lilicqyu-ship-it/smartcar/tc275_car/doc/00-index.md

# 00 · 文档地图（doc/ 入口）

| 项 | 内容 |
|---|---|
| 文档编号 | 00 |
| 域 | 入口（跨板） |
| 版本 | V1.23（2026-10-05：**融合保护主开关批次登记**——新增编译期宏 `FUSION_CFG_PROTECTION`（`app/fusion.h`，默认 1）：置 0 构建台架/诊断旁路固件，场景分类/cap/健康位照常发布但限速、停车锁存（近障/盲区/编码器/超速）、倾斜停车与倒车限速全不执行、原始摇杆直通（动机 = 48 cm 桅杆水平安装下地面回波 ~0.95–1.4 m 把 cap 压到 fs 以下、重新武装 v1.0.9 只豁免 `cap==fs` 的超速假锁存并打破 OPEN_CLEAR，地面无法驾驶；2026-10-04 记录的 201–488 mm 近回波在该高度不可能是地面，待 `[TOF_ZONE]` 定位）；`[FUSION]` 日志新增 `protection` 字段；**旁路构建无任何前向保护仅限台架，测完恢复 1 重烧**，长期修复候选（地面平面过滤/上仰 ≥10–16°/fs 实测标定）登记在 37 号 V1.4），33 **V1.9**（§6 新增主开关条目）、37 **V1.4**、38 **V1.3**；APPFW **1.3.2**；`test_fusion_bypass` 新增 6 组旁路回归并入 CI（`tc275-car.yml`），既有 `test_fusion` 全过；TASKING 构建过（ROM 199042 B），旁路/实车驾驶未上台架。V1.22（2026-10-04：**BUG-ENC-1 编码器健康 P0 修复批次登记**——新增 **51 号缺陷修复记录**（BUG-ENC-1：4 路霍尔健康合并成单一 `alive`、融合把"1 ms 发布序号变化"当"编码器有效"，单侧失效被对侧运动掩蔽，`FUSION_ENCODER_LOST` 对传感器失效是死代码；修复 = `XcoreEncoder.edgeAgeMs[2]` 按侧边沿龄 + "被驱侧 500 ms 宽限内必须出边沿"消费语义，速度锚/一致性只用边沿新鲜的侧，measOk 按侧回退开环，[WHEELS] 补 age 字段），21 **V1.16**（§5.1/§5.2）、31 **V2.9**、33 **V1.8**、37 **V1.3**（flags bit4 语义更新）、38 **V1.2**、51 新登记；APPFW **1.3.1**（与日志泵去阻塞同批一个发布，33 V1.7/38 V1.1 为该批条目）；test_fusion 新增按侧失效回归、test_xcore +2 断言（1144）；TASKING 构建过（ROM 198243），按侧拔线注入待台架）。V1.21（2026-10-04：**TB6612 STBY 受控化同批索引同步**——23 **V1.23**（§3 脚位改 P22.2/X1-16 → J4-2、新增 §3.2 选脚判据与三条电气事实）、21 **V1.15**（§4 术语/§5.2/§7.1/§7.2/§17 五处回写，"急停是否拉低 STBY"登记为未裁决语义）、33 **V1.6**（§9 硬件速查补 STBY 行）、01 **V2.2**（第 4 步改接线 + 排障表加"四轮全不动＝STBY 未使能"）；**改线与刷固件必须同批**，且本轮未过 TASKING 构建）。V1.20（2026-10-04：**新增 38 号开发者日志字典**，App **v1.2.1** 把周期日志改为 `[MODULE] 字段=值+单位` 并按状态分级节流（融合 5 s、IMU/ToF/车速 10 s、链路 30 s，伺服抖动不重置节流），故障与恢复仍即时成事件，新增 `XCORE_LOG_FIELDS`/`XCORE_logDue` 与 `log_dropped_total`；35/36/37/21 各加指向注；CI 步骤新增 `test_log_policy.py`，`test_xcore` 1121→1144 断言）。V1.19（2026-10-04：新增 37 号，App v1.2.0 多传感器融合与遥控保护）。V1.18（2026-10-04：36 号 V1.5，ToF 1 MHz 配置试验 865 帧、错误 0）。V1.17（2026-10-04：36 号 V1.4，ToF COM16 连续 744 帧、错误 0）。V1.16（2026-10-04：23 号 V1.22、36 号 V1.3，ToF 换到 X304-7/-8 复测）。V1.15（2026-10-04：36 号 V1.1 登记复测失败与清标志前诊断快照）。V1.14（2026-10-04：登记 36 号 ToF 驱动故障修复与验证记录）。V1.13（2026-10-03，**§2 版本列同步 23→V1.21**——23 号新增 **§11「TC275 ↔ VL53L5CX 8×8 多区 ToF」接线定稿**：挂 **TC275 唯一 I2C0**（SCL=P13.1 / SDA=P13.2，mikroBUS 12/11 孔）、INT=P10.7（孔 15）、LPn 方案 A（47 k 上拉、不占 MCU 脚）、AVDD+IOVDD 同取 VEXT 3.3 V、典型 95 mA 并入 §5.2 电流预算；**两条新登记的事实**：① **ERU 输入通道互斥**——`IfxScu_REQ4_P10_7_IN` 的 `channelId=0`，与 IMU 在用的 `REQ0_P15_4`（ch0 选 a）是同一条通道 ⇒ ToF 的 INT **做不了边沿中断，改 CPU0 电平轮询**（这正是 §6 G2 所说"引脚冲突是最贵的错误"的又一例，已把备选脚 P10.8/P20.9/P20.0 登记在 23 §11.2）；② **iLLD 把 I2C SCL/SDA 配成开漏**（`IfxI2c.c:220-228`）⇒ SDA/SCL 2.2 k + INT/LPn/I2C_RST 47 k 是手册硬要求，`23 §9.3` 的"杜邦线无外部元件"口径在这条总线**不成立**，已在 23 §1 加例外注。另 23 V1.21 更正 **§10.1 IMU INT2 孔位 X1-30 → X1-29**（X1-30 实为 PORST_N 复位网）。**ToF 本批只锁脚位：不动 `.cproject`、不引 ST API、不写 `bsp/tof.c`、不改 C6 侧、11 号需求表尚无 ToF 条目**；§2 表内 23 行同步，本行自指版本一并纠正为 V1.13）。V1.12（2026-10-03，**新增 35-imu-driver.md 并登记进 §2**——TC275 侧 LSM6DSV16BX 六轴 IMU 驱动落地：`bsp/imu.c/.h` CPU1 属主（QSPI1 主机 SPI 模式 3/1 MHz 档位、WHO_AM_I 0x70、±4 g/±500 dps/240 Hz、每 5 ms 14 B 突发、INT1 P15.4 走 SCU ERU 仅计数、失联 1 Hz 重探免重启自愈）、xcore 新块 `XcoreImu`、中断优先级占用 11/14/15+24（21 §18 C2 同步）、主机单测新增 `test_imu` 55 断言（CI 同步）/`test_xcore` 1095→1109；**未过 TASKING 编译、硬件未接线（23 §10 待实物接线），驱动主体无单测需台架首验**；接线真源 23 §10、驱动设计真源 35。§2 版本列同步 21→V1.13 / 23→V1.19 / 31→V2.7 / 32→V1.9 / 33→V1.5）。V1.11（2026-09-27，**34 号 M2a + M3' + §9 DPT 落地**，本轮口径变更：**标定结果回传 + DFlash 持久化 + 台架命令族**——新增 `mw/calib/`（`calib_record.c/.h` 纯 C99 记录 blob 与 EVT 编解码、有主机单测；`calib_store.c/.h` CPU0 专属 **DFlash0 扇区 15** 单槽持久化，magic/CRC/范围三关不过则回默认值），§8.2 满量程与轮径转**运行时变量（换算公式未动）**，xcore 新增四块 `CalibResult`(CPU1→CPU0)/`Jog`(CPU0→CPU1)/`RecordLive`(带 `version`)/`EVT 出站队列`(CPU0→CPU2)，命令 `0x71 MOTOR_JOG`（duty 钳 ±500、300 ms 未续约自动停车、FAULT/急停拒收）与 `0x72/0x73/0x74` REC 读写清，回传 EVT `0x22`(23 B，`saved` 在 [22])/`0x23`(15 B)，**写 flash 延后到车辆静止 500 ms**、序列=喂狗→关中断→擦→逐页写→回读；真源 `34 §8/§9/§11`，协议侧 `22 §5.1/§5.2`、`21 §5.1/§5.2/§6.2`。**SF 主机单测 2873→2948**（① 的编译单元加 `mw/calib/calib_record.c`，`.github/workflows/ci.yml` 同改）。**M2a/M3' 只过主机单测：未做 TASKING 构建、xcore 新块/jog/DFlash 均无台架证据**，未决项见 `34 §12 Q1~Q3`。§2 版本列同步 21→V1.10 / 22→V1.7 / 23→V1.15 / 31→V2.5 / 32→V1.8 / 33→V1.1 / 34→V1.2）。V1.10（2026-09-27，34 号升 V1.1——按用户需求追加：标定数据（电机位置/运动方向/算法参数）**存 TC275 DFlash**（CalibRecord 单槽+CRC，参数运行时化）、DPT 命令族 **0x71 MOTOR_JOG / 0x72~0x74 REC 读写清**、0x22 回传帧追加 saved 位；跨库配套 esp32c6_car 17 号 V1.1 §8；文档追加，无行为变更）。V1.9（2026-09-27，新增 **34-calib-dpt.md** 并登记进 §2——TC275 编码器判向标定功能现状与需求：0x70 现状盘点、M2a 结果回传帧 `SF_CID_DPT_RESULT(0x22)` 契约（跨库配套 esp32c6_car `doc/17-calib-ui.md`）、M3 符号固化流程、弱 plant 台架规程；文档新增，无行为变更）。V1.8（2026-09-27，§2 版本列同步至 SDD V1.9 / 23 V1.14 / 31 V2.4 / 32 V1.7，本轮口径变更：**电池电压采集落地**——D24A J6-1 分压（VIN/11）接 kit **X2-23/AN4**（VADC G0 CH4），`bsp/adc` 100 Hz + EMA，遥测 `batteryMv/batteryPct` 转 ✅（pct 按 3S 估算待节数确认），真源 `23 §5.5` 与 `21 §6.3`；接线真源 23 V1.14）。V1.7（2026-09-27，**23 号新增 §3.1「D24A 驱动板原理图详解」**——把驱动板原理图 REV1.0 板内电路（5V TB6288GSP / 3V3 RT9013-33 / 双 TB6612FNG / 过温过流使能 / 连接器清单）登记为真源，§2 版本列同步 23→V1.13；33 号 §9 硬件速查补指向该节）。V1.6（2026-09-27，新增 **33-ai-codebase-guide.md**——供 AI 编码助手作业前必读的代码库导航、跨核数据流、高频改动路径正确改法与 9 条红线速查，登记进 §2 真源表；现状口径已含 servo 闭环 / CPU 看门狗 / 0x70 判向）。V1.5（2026-09-27，§2 版本列同步至 SDD V1.8 / 31 V2.3 / 32 V1.6 / 50 V1.2，本轮口径变更：**跑飞自恢复链落地**——`bsp/wdg.h` 新增，**CPU0/CPU1 硬件看门狗启用并周期喂狗**（CPU1 1 kHz 环 / CPU0 robot 任务 10 ms，窗口 ≈0.3~0.5 s），SM 与 CPU2 看门狗**有意保持关闭并各附理由**，FreeRTOS 栈溢出钩子改为"上报 + 断喂复位"，真源 `21 §7.2` 与 `21 §18 C8`（含 **ENDINIT 饱和计数**铁律）；50 号评估 §6 建议 1/2/3 已处置并回执。V1.4（2026-09-27，§2 版本列同步至 SDD V1.7 / 23 V1.12 / 31 V2.2 / 32 V1.5 / 50 V1.1，本轮口径变更：**CPU1 速度闭环落地 + 判向标定转正**——`rt/servo` PI×2（编码器无效回退开环）、`g_encInvert` 运行时可写 + `0x70` 台架自动判向、遥测 `vTargetL/R` 转 ✅，真源 `21 §5.1/§5.2` V1.7；50 号评估的建议 1/2 已处置并回执于 `50 §5`）。V1.3（2026-09-27，新增 **50-tech-assessment.md**——对 `v0.2.1` 现状代码的第三方技术评估快照，登记进 §2 真源表与 §1 编号规则 5x 域）。V1.2（2026-09-27，§2 版本列同步至 SDD V1.6 / 22 V1.6 / 23 V1.11 / 31 V2.1 / 32 V1.4 / 41 V1.3，本轮口径变更：**链路泵简化**——寄存器快照改单读+消费端钳位、失联判定只由 `SF_ALIVE` 500 ms 承担、SEQ 越窗 8 帧重锁，真源 `22 §4.2/§5.4` V1.6；另登记 GitHub Actions CI 已建——主机单测 push/PR 自动跑，真源 `.github/workflows/ci.yml`）。V1.1（2026-09-26，随 doc 目录重构建立；V1.1 = §2 版本列全量同步至 SDD V1.5 / 22 V1.5 / 23 V1.10 / 31 V2.1 / 32 V1.3 / 41 V1.2 / 11 V1.3，并登记两条口径变更：**板间连线为杜邦线直连无外部元件**（真源 `23 §9.3`）、**UART 作为板间链路已弃用**（真源 `21 §5.6` 末条与 `21 §18 C15`，构建侧 `USE_SPI_LINK` 进 Debug/Release 两个 TASKING 配置）） |
| 读者 | 所有第一次进入本仓库的人；以及需要确认"某件事的权威出处在哪篇"的人 |

本仓库（`tc275_car` = TC275 固件工程）与同级仓库（`esp32c6_car` = ESP32-C6 固件工程）共同构成 SmartDrive 的双固件产品。文档按**域**分目录、按**编号**排序。

---

## 1. 编号规则

```
NN-名称.md
│└─ 名称：kebab-case，英文
└─ NN：两位数字。十位 = 域，个位 = 域内阅读顺序
   0x  入口 / 教程        1x  产品与需求      2x  设计与硬件（跨板）
   3x  TC275 侧           4x  ESP32-C6 侧     5x  生产/质量、运维（50 评估、51 验证日志…）
```

目录与编号一一对应：`doc/10-product/`、`doc/20-design/`、`doc/30-tc275/`、`doc/40-esp32c6/`；`0x` 两篇放在 `doc/` 根。

**新增文档时**：先确定归属域，取该域下一个空号；不要插号（如 `21a`），也不要为了"看起来成对"复制内容——跨板内容进 `20-design/`，单板内容进 `3x`/`4x`。

## 2. 全部文档与真源职责

| 编号 | 文档 | 域 | 版本/状态 | 它对什么负责（真源） |
|---|---|---|---|---|
| 00 | [00-index.md](00-index.md) | 入口 | V1.21 | 文档地图、编号规则、阅读路线、缺口清单 |
| 01 | [01-getting-started.md](01-getting-started.md) | 入口 | V2.2 | **demo（esp-at + UART）能跑通的 bring-up 全流程**：编译烧录 → 刷 esp-at → 接线 → 手机遥控 → 排障。**做本教程需临时删掉 `USE_SPI_LINK`**（UART 板间链路已弃用）。**V2.2 = 第 4 步 STBY 改 GPIO 受控（拔 J4-1↔J4-2 跳线帽 + X1-16→J4-2），并加"四轮全不动 = STBY 未使能"排障行** |
| 11 | [10-product/11-requirements.md](10-product/11-requirements.md) | 产品 | V1.3 | 产品定义、功能编号 F01~F14、验收标准、版本路线（V1.3：板间链路唯一为 SPI） |
| 12 | [10-product/12-demo-evaluation.md](10-product/12-demo-evaluation.md) | 产品 | 冻结快照 | demo 的问题清单 P0~P3（**历史快照**，结论已被 21 号吸收为架构约束，不再更新） |
| 21 | [20-design/21-software-design.md](20-design/21-software-design.md) | 设计 | **V1.16 ★基准** | 量产软件设计基准：三核分区、模块详设、两段协议、安全/信息安全、OTA、产测、质量工程、里程碑、风险、**§18 工程级实现约束 C1~C15**（C15 = UART 板间链路弃用；V1.6 = 链路泵简化；V1.7 = 速度闭环 `rt/servo` 落地 + `g_encInvert` 运行时判向 + 0x70 自动判向，**首次闭环前必须先判向**；V1.8 = **CPU0/CPU1 硬件看门狗启用 + 栈溢出钩子上报并断喂复位**，喂狗铁律见 §18 C8；V1.10 = 标定/DPT 落地：§4.1 DF0 槽位占用（扇区 15）+ §5.1 参数运行时化与持久化 + §5.2 jog 与结果回传 + §6.2 `0x70~0x7F` 同字节双语义 hazard + §17 新增 `mw/calib/`；V1.11 = §5.2 闭环使能门固件化（`g_closedLoopOk`，src=0 强制开环等价，34 §13）；V1.12 = §5.1 编码器刻度 13 PPR；**V1.13 = §7.2/§18 C8 看门狗假死根治**——TC27x 的 CPU WDT 到期只发 NMI 不自行复位、iLLD 默认空钩子 → V1.8 的"断喂→复位"链从未闭合（整车假死根因），`Ifx_Cfg.h` NMI 钩子接 `IfxCpu_triggerSwReset()` 兜底，窗口更正 `REL=0xF800`≈**1.4 s**（旧稿 0.3~0.5 s 算术矛盾），随 tc275_car v1.1.2；**V1.15 = TB6612 STBY 改 GPIO 受控（P22.2/X1-16 → D24A J4-2）**：§4 术语"安全态"/§5.2"STBY 硬线"/§7.1 复位口径/§7.2 台架项/§17 映射五处同批回写，凭 TB6612 **控制输入内部 200 kΩ 下拉**给出"复位期间驱动未解锁"的纸面答案（**实物须改线 + 台架未做前不得宣称已闭环**）；**未裁决**：急停/堵转/欠压是否叠加"STBY 拉低"——与现短接刹车互斥（拉低=高阻滑行、刹车距离变长），详见 §5.2 与 23 §3.2） |
| 22 | [20-design/22-link-spi-design.md](20-design/22-link-spi-design.md) | 设计 | V1.8 | 板间 SPI 链路的详细设计：事实基线 **E1~E14**、事务模型（V1.6 = 单读快照 + 消费端钳位，§4.2）、SF 帧（含 FLAGS/CID 载荷形状两张契约表、SEQ 越窗重锁 §5.3）、两固件改动清单、门禁 G1~G6；V1.7 = EVT 登记 0x22(23 B)/0x23(15 B)（CPU0 组帧、CPU2 发送、队头重试）与 DPT op 扩到 0x70~0x74；**V1.8 = 命令队列抗突发**（§5.4 队列满载条目重写：深度 8→16、`SET_SPEED` 新者胜入队 `XCORE_cmdPushLatest`、`cmdq full` 日志限速 1 行/s、`XCORE_logService` 每调用排空一行、LINKDBG 第 19 字段 `cmdqRej`；台架"大量 LINK cmdq full 后失控"的根因收敛，xcore 队列语义新增主机单测 `test_xcore` 1095 断言） |
| 23 | [20-design/23-wiring.md](20-design/23-wiring.md) | 硬件 | **V1.23** | **引脚与接线唯一真源**（TC275 ↔ C6 ↔ D24A ↔ 电机/编码器 ↔ IMU ↔ **ToF** ↔ 电源）+ 接线状态一览 + **§3.1 D24A 驱动板原理图详解（REV1.0 板内电路）** + **§3.2 STBY 受控化**（2026-10-04：STBY 由"跳 J4-1 板载 3V3 常使能"改为 **TC275 GPIO 受控 P22.2 / X1-16 → J4-2**，一根线管四路；含选脚五条排除判据、**片内 200 kΩ 下拉 ⇒ 浮空=关断**、`VIH(STB)=3.5 V` vs 3.3 V 驱动的裕量账、与 21"安全态"的语义冲突登记；**改线与刷固件同批**） + **§9.3 板间连线电气形态（杜邦线直连、无外部元件）**；§2 UART 已降为调试控制台；§8.4 步骤 2 首选 `0x70` 自动判向，V1.15 追加"持久化与台架命令"子块（0x70 结果自动写 DF0 扇区 15、EVT 0x22/0x23、0x71 jog 与 0x72~0x74 语义），V1.16 = "开环等价"由固件强制执行（34 §13 闭环使能门），V1.17 = §8 编码器刻度修正（13 PPR → 1061.27 计数/轮转），V1.18 = **§10 新增 LSM6DSV16BX 六轴 IMU 接线定稿**（QSPI1 P11.6/11.9/11.3 + SLSO3 P11.10、INT1 P15.4/INT2 P15.5、VEXT 供电），V1.19 = §10 IMU 固件驱动落地（`bsp/imu.c/.h` CPU1 属主、xcore `XcoreImu`、失联 1 Hz 重探；设计真源 35），V1.20 = §10.2 首验 ① 台架通过（`WHOAMI=0x71`、静置六轴模 995 mg）+ 三项未结，**V1.21 = 新增 §11「TC275 ↔ VL53L5CX 8×8 多区 ToF」定稿**（**I2C0 主机**，SCL=**P13.1**/SDA=**P13.2** 走 mikroBUS 12/11 孔、INT=**P10.7**（**ERU ch0 与 IMU INT1 撞车 ⇒ 电平轮询**，备选 P10.8/P20.9/P20.0 已登记）、**LPn 方案 A** 47 k 上拉不占 MCU 脚、AVDD+IOVDD 同取 VEXT 3.3 V、典型 95 mA 并入 §5.2）+ **§1 补"I2C 总线上拉例外"口径**（iLLD 开漏 ⇒ SDA/SCL 2.2 k、INT/LPn/I2C_RST 47 k 是硬要求，§9.3 的"无外部元件"在这条总线不成立）+ **§10.1 INT2 孔位更正 X1-30 → X1-29**（X1-30 实为 PORST_N 复位网，用户实物已改插 29）。**ToF 本批只锁脚位：不动 `.cproject`、不引 ST API、不写 `bsp/tof.c`**；当前 ToF 接线按 §11.6：P02.5=X304-7 / P02.4=X304-8（100 kHz 复测） |
| 31 | [30-tc275/31-firmware-architecture.md](30-tc275/31-firmware-architecture.md) | TC275 | V2.9（现状） | **当前代码**的分层/任务/中断/xcore 通道/HTTP API/电机映射（描述现状，不是目标态；UART 段落自 2026-09-26 起需删符号才编得出；V2.2 = CPU1 速度闭环 + 判向请求通道；V2.3 = CPU0/CPU1 看门狗已启用的现状描述；V2.5 = 标定/DPT 落地：xcore 通道表补 `CalibResult`/`Jog`/`RecordLive`/EVT 出站队列四行、§7.2 命令表补 0x71~0x74、mw/calib 进分层图；**V2.6 = 命令队列抗突发现状回写**：命令队列 16 深 + `SET_SPEED` 新者胜 + 限速日志 + `XCORE_logService` 每调用一行；**V2.7 = IMU 驱动现状回写**：xcore 通道表补 `XcoreImu` 行、§3 中断清单补 QSPI1 11/14/15 + ERU 24、分层图补 `bsp/imu`（真源 [35](30-tc275/35-imu-driver.md)） |
| 32 | [30-tc275/32-tc275-dev-guide.md](30-tc275/32-tc275-dev-guide.md) | TC275 | V1.11 | TC275 侧**怎么做**：环境、构建（**两个 TASKING 配置都定义 `USE_SPI_LINK`**）、烧录调试、**两份主机单测的可粘贴命令（GitHub Actions 同步在跑）**、新增中断/跨核消息/外设引脚的操作步骤、排障手册（含 `SRV=`/`ENCCAL=` 台架行判读；**V1.6 起"跑着复位"第一嫌疑是喂狗断流**；V1.8 = 标定/DPT 落地同步：单测 ① 加 `mw/calib/calib_record.c`、2873→2948，§5 新增"写 DFlash 只允许 CPU0 + 喂狗关中断 + 版本计数而非 valid"，§8 排障表加 `CALIBREC`/jog/保存失败三行；**V1.10 = 看门狗假死根治随 v1.1.2/21 V1.13 同步**：§3 调试约定补"超时反应已闭合（NMI→软复位）"、窗口全文更正 ~1.4 s、§8 新增"整车冻结假死"一行；**V1.11 = IMU 驱动落地同步**：§1 单测命令加 ③ `test_imu`（55 断言）/④ `test_xcore`（1109）、§3 CPU1 行补 `bsp/imu.c`、§4 步骤 5 补 SCU ERU 例外（真源 35）） |
| 33 | [30-tc275/33-ai-codebase-guide.md](30-tc275/33-ai-codebase-guide.md) | TC275 | V1.9 | **AI 协作指南**：代码地图、跨核数据流与单位域、三条高频改动路径的正确改法、安全机制现状、验证命令、**10 条红线速查**、硬件事实速查——**AI 编码助手作业前必读**（现状口径含 servo 闭环 / CPU 看门狗 / 0x70 方向标定 / 标定参数运行时化 + DFlash 持久化 + 0x71~0x74；V1.2 = 随 34 号 V1.3 补闭环使能门 §2/§5.2/§6；V1.3 = 编码器刻度修正；**V1.4 = 命令队列 16 深 + SET_SPEED 新者胜**，§7 加 `test_xcore` 命令（1095 断言）；**V1.5 = IMU 驱动落地**：§2 代码地图加 `bsp/imu`、§7 验证加 `test_imu` 命令、§9 硬件速查补 IMU 段（QSPI1/INT1/优先级 11·14·15·24，真源 [35](30-tc275/35-imu-driver.md)）；**V1.6 = STBY 受控化**：§2 代码地图 `bsp/motor.c` 行补 STBY、§9 电机速查新增 STBY 条目（P22.2→J4-2、`MOTOR_setEnabled`、急停路径不调用它、跳线帽须拔）；**V1.9 = §6 新增融合保护主开关** `FUSION_CFG_PROTECTION`（0=旁路固件仅限台架，回归 `test_fusion_bypass` 入 CI）） |
| 34 | [30-tc275/34-calib-dpt.md](30-tc275/34-calib-dpt.md) | TC275 | V1.9（**已落地，台架闭环**） | **编码器判向标定（0x70/DPT）功能真源**：F02 现状盘点（触发链路/状态机/ENCCAL 行）、M2a 结果回传帧 `SF_CID_DPT_RESULT(0x22)` 契约（与 esp32c6_car 17 号同一份协议两端）、**M3' DFlash 持久化（CalibRecord：电机位置/运动方向/算法参数）+ DPT 命令族 0x71~0x74（逐电机 jog / 参数读写）**、弱 plant 台架规程与判读语义。V1.3 = §13 闭环使能门；**V1.8（2026-10-02）= DFlash 保存链路台架全通**（擦除态 0x00 极性 + 页装载小端两根因闭环，固件 1.0.10）；**V1.9（2026-10-03）= §8.3 停顿预算随 21 V1.13 更正**（CPU0 WDT 窗口 ≈1.4 s，旧稿 0.3~0.5 s 算术错误） |
| 35 | [30-tc275/35-imu-driver.md](30-tc275/35-imu-driver.md) | TC275 | V1.3（**首验 ① 台架通过：实测 `IMU ready (WHOAMI=0x71)`、静置六轴模 995 mg、`err`=0；新增"全 0 突发＝读失败"判据；另有三项未结**） | **LSM6DSV16BX 六轴 IMU 驱动真源**（F13 感知层地基）：寄存器级事实（WHO_AM_I=**0x71**、CTRL1/2 低 4 位 ODR、CTRL6/8 分离 FS、0x20 起 14 B 连续突发——与 LSM6DSL 布局不同的交叉核对结论）、QSPI1 主机 SPI 模式 3 与时钟档位、CPU1 属主与优先级 11/14/15+24、xcore `XcoreImu` 块与单位域（mg/mdps/0.01 °C）、失联 1 Hz 重探行为、**台架首验规程（接线后 §7 三步判读）**；**V1.1 = 失联诊断行 `IMUERR st/id/err/clk=`（`imu_probe` 回传 `ImuStatus` + 原始 ID 字节）+ §7.1 判读表——把"无供电/时钟相位/CS 未到/事务超时"四种失联病因在串口上分开，不改总线行为**；**V1.2 = 芯片身份与突发解码更正**：① 期望 ID 0x70→**0x71**（核对来源改 ST 官方 `lsm6dsv16bx-pid`，原 `stm32duino/LSM6DSV16X` 是另一颗芯片；此条独立于台架症状，`id=0x00` 说明总线根本没回字节）② 14 B 突发解码改**小端 + 加计寄存器序 Z,Y,X**（`IMU_le16`/`IMU_burst*`，新增 §2.4 逐字节表）③ §7.1 移位判读值随 0x71 更正 ④ `test_imu` 55→**75 断言**；**V1.3 = 运行中静默判据 + 首验 ① 实测背书**：① 新增 `IMU_burstIsBlank`，14 B 全 0（配 `tempC` 恰好 2500、`drdy` 冻结）判为**读失败**→ 100 ms → `alive=FALSE` → 1 Hz 重探重配置（此前 QSPI 状态干净即把空突发算成功，`IMU=` 行长期撒谎且 `whoAmI` 只是探测缓存）② 两处日志字面量 `0x70`→`0x71` ③ §7.2 登记静默签名与 H1（模块掉电自复位）/H2（彻底失电）判别，`drdy` 同步冻结排除"MISO 单线断" ④ §7.3 记两项未结：`drdy` 实测 +399/行 vs 期望 +480（-17%，候选＝ERU 吞沿或 STIME 时基偏慢）、SCLK 实测 5 µs vs `clk` 字段 1 MHz（iLLD 反算假设 QSPI 输入＝fMAX，全仓无 `IfxScuCcu_init()`）⑤ ODR 编码按 `lsm6dsv16bx_reg.h` 复核（XL 与 GY 的 `0x7` 均为 240 Hz）⑥ `test_imu` 75→**92 断言**，固件本轮未经 TASKING 构建；接线真源 23 §10 |
| 36 | [30-tc275/36-tof-driver.md](30-tc275/36-tof-driver.md) | TC275 | V1.5（2026-10-04） | VL53L5CX 驱动、FIFO 握手修复与首故障快照；实测 SDA 持低，加入有界 GPIO 释放与 TOFCLEAR；TASKING/主机模型通过，COM16 已采集原组故障，GPIO 地址 ACK；新组 X304-7/-8 待换线复测 |
| 37 | [30-tc275/37-sensor-fusion.md](30-tc275/37-sensor-fusion.md) | TC275/C6 | V1.5（2026-10-09） | 完全可信区严格 >2/3 才限速；15–6 cm 线性降速、原始距离 <6 cm 停车；低覆盖忽略限速；原前向距离/车速安全包络已替换（V1.3：编码器健康按侧判定，flags bit4 语义更新，随 [51](51-encoder-health-bugfix.md)；**V1.4：新增融合保护主开关 `FUSION_CFG_PROTECTION` 台架旁路**——`[FUSION]` 日志 `protection` 字段配套、48 cm 桅杆地面回波几何核算与假锁存动机、长期修复候选登记）、冻结帧保护、停车松杆恢复；IMU 互补滤波与差速航向融合留待轴向标定；28 B 可选状态事件、网页提示和验证记录 |
| 38 | [30-tc275/38-developer-logging.md](30-tc275/38-developer-logging.md) | TC275 | V1.3（2026-10-05） | v1.2.1 开发者日志格式（V1.2：[WHEELS] 补按侧边沿龄字段，随 [51](51-encoder-health-bugfix.md)；V1.3：[FUSION] 补 `protection` 字段——旁路构建下 cap/forward 仅为建议值）、输出频率、全字段单位与异常值字典 |
| 41 | [40-esp32c6/41-c6-docs-map.md](40-esp32c6/41-c6-docs-map.md) | C6 | V1.3 | C6 侧文档边界与索引：本仓库负责哪几条接口、`esp32c6_car/doc/` 各篇对应关系、跨仓库待办、**§4 板间连线电气形态 + UART 弃用对 coding 的硬约束** |
| 50 | [50-tech-assessment.md](50-tech-assessment.md) | 生产/质量 | V1.2（评估快照） | **对 `v0.2.1` 现状代码的第三方技术评估**：8 维度评分（加权 3.54/5）、结合主流路线对标、按 P0/P1/P2 排序的改进路线；**非设计基准**，与 21 冲突时以 21 为准（V1.1 = §5 电机建议 1/2 回执；V1.2 = §6 安全兜底建议 1/2/3 回执：CPU0/CPU1 看门狗、栈溢出钩子、§18 C8 铁律已落地，SM/CPU2 与带条件喂狗仍是缺口） |
| 51 | [51-encoder-health-bugfix.md](51-encoder-health-bugfix.md) | 生产/质量 | V1.0（2026-10-04） | **BUG-ENC-1（P0）缺陷修复记录**：编码器健康被合并成单一 `alive` + 融合把发布序号当编码器有效（单侧失效被掩蔽、`FUSION_ENCODER_LOST` 对传感器失效失效、死侧 PI windup）——根因证据、按侧 `edgeAgeMs[2]` + 500 ms 受驱宽限的修复设计、已知边界、验证记录与台架待办 |
| — | `esp32c6_car/doc/00~13` | C6 | 外部 | C6 固件模块级设计（LLDD）**不在本仓库**，见 41 号索引 |

## 3. 冲突裁决顺序

2026-10-04 新增事务层：21 文末补充及 [共享契约](../../contracts/link/transaction-v1.md)。TC275 v1.3.0 实现见 [39 · 诊断事务](30-tc275/39-diagnostic-transactions.md)；C6/iOS 接入尚待实现，现有 SPI 物理层仍参照 22。

多个文档口径不一致时，按此顺序取权威：

```
21（量产基准） > 23（接线真源） > 22（链路详细设计，不得与 21/23 矛盾）
   > 32/31（TC275 实现层） > 11（需求层） > 12（历史快照，仅供追溯）
```

一句话规则：**"要做成什么样"看 21；"线插哪个孔"看 23；"现在代码是什么样"看 31。**

## 4. 阅读路线

**新成员（半天建立全局）**
`00` → `01` 跟做一遍（板子点亮）→ `31`（理解现有代码）→ `21`（理解要去哪）→ 按需 `23`/`22`。

**只改 TC275 固件（今天就要动手）**
`32`（环境与构建）→ `21 §18`（工程铁律，**必读**）→ 目标模块在 `21 §5` 的设计 → 现状参照 `31` 对应节 → 涉及引脚则 `23` 核对冲突。

**做板间链路 / C6 侧（SPI + SF 帧）**
`21 §3.7` + `22` 全文 + `23 §9.1`（接线）+ `23 §9.3`（**电气形态：杜邦线直连、无外部元件，写代码前必读**）→ `41`（C6 侧边界与待办）→ `esp32c6_car/doc/04`（C6 侧实现现状：SPI 从机已完成，未通电联调）。

**评审 / 验收 / 排期**
`21 §2.2`（NFR）→ `§15`（里程碑）→ `§16`（风险）→ `22 §8`（链路门禁）→ `11 §32`（V1.0 验收项）。

**生产 / 测试**
`21 §10`（产测与标定）→ `21 §13`（质量工程）→ `41` 里的 BLE DPT 指针（`esp32c6_car/doc/10`）。

## 5. 维护规则（防漂移）

1. **改行为必须同批改文档**：协议帧、引脚、超时/看门狗数值、xcore 通道语义任一变动，同一提交里更新对应真源（帧→21 §6/22 §5；引脚→23；跨核→31 §4 + 21 §5.5）。
2. **`21` 是唯一允许写"目标态"的地方**；`31`/`01` 只写现状。想在 `31` 里写未实现的东西，说明它该进 `21`。
3. 历史快照类（`12`）不更新；结论被吸收后在 `21` 里注明"吸收自评估报告 P0-x"即可。
4. 每次升版在文档头部表加一行修订记录，并在 `00-index.md` §2 的状态列同步版本号。
5. 文档间引用只写**编号 + 章节**（例：`21 §18 C1`），不写整段路径，避免重命名时批量失效。

## 6. 已知缺口（诚实清单，按价值排序）

| # | 缺什么 | 现状 | 建议 |
|---|---|---|---|
| G1 | **测试/验证矩阵文档（5x 域）** | 判据散落在 `21 §13`、`22 §8`、`21 §10` 与 `esp32c6_car/doc/13` | 等 SPI 链路 G1 门禁跑完后，把"每档门禁的实测记录"独立成验证日志文档（取下一个空号——`51` 已被 [51-encoder-health-bugfix.md](51-encoder-health-bugfix.md) 登记）（含波形截图、CRC 误码率、时延实测），否则数值无法追溯 |
| G2 | **引脚分配总表（单一视图）** | 分在 `23` 各节 + `31 §9`。**2026-10-03 再添一例**：VL53L5CX 的 INT 选到 P10.7 后才发现它与 IMU INT1（P15.4）**同属 ERU 输入通道 0**（`IfxScu_REQ4_P10_7_IN.channelId=0`），边沿中断直接不可用——这种"两个都对、合起来不行"的冲突只有单一矩阵才拦得住 | 引脚冲突是本项目最贵的错误，值得在 `23` 内加一节"全引脚占用矩阵（X1/X2/mikroBUS/**ERU 通道**/板载复用）"；未做，`23` 目前是分区叙述 |
| G3 | **D24A / 电机电流与钳位的量化设计依据** | `21 §5.2` 有职责，缺 StallGuard/电流阈值推导 | 闭环上板实测后再写，避免拍数字 |
| G4 | **C6 侧 LLDD 的中文索引** | `esp32c6_car/doc/` 14 篇无跨仓库索引 | 已由 `41` 承担（本次补齐） |
| G5 | **`01-getting-started` 的量产通路** | 只覆盖 esp-at + UART | SPI 链路启用后新增 `02-bringup-production.md`，在 G1 通过前不预先写未验证流程 |
