lilicqyu-ship-it/smartcar/s3-gateway/doc/17-calib-ui.md

# 17 · 台架标定 Web UI 需求（编码器判向 · 专用页面 /calib.html）

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

> **设计原则：简单、功能完整。** M1 只动 C6，复用既有通路零协议改动即可交付可用台架工具；M2 补一条结果回传帧让结果直接显示在页面上（需要 tc275_car 固件配合，契约在 §5 定义死）。

---

## 1. 背景与目标

**台架证据（2026-09-27 串口抓取，COM16）：**

```
SRV= 200 76 599 160 -86 656    ← 同一次前向命令：左 duty+599↔实测+76（同号正常），
                                  右 duty+656↔实测-86（反号，闭环在追假反馈）
SRV= 0 0 37 0 43 -334          ← 摇杆松开（目标0/0）后右 duty 仍钳在 -334 持续倒驱
SPD= 0 43 29926 1              ← "空闲"状态下右轮累计转出 29.9 m
```

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

**目标**：做一个专门的标定 Web UI 页面 `/calib.html`，完成：

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

**非目标（明确排除）**：

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

---

## 2. 页面设计（M1，纯 C6 可交付）

### 2.1 文件与入口

| 项 | 规定 |
|---|---|
| 页面 | 新增 `assets_src/calib.html` + `assets_src/calib.js`（自包含：复制控制页约 40 行的 `buildFrame/crc16/wsUrl/hello` 助手，**不重构 app.js**，降低回归面）；打包机制照 doc/12-assets-tools.md |
| 入口 | 控制页 `index.html` 的"维护 · 固件升级" `<details>` 区（73 行附近）加一行链接：`台架标定 → /calib.html` |
| 会话 | 复用同源 token 配对流程与 WS 建连（`/ws?token=`）。页面 hello 后按 `role==="ctrl"` 判定权限；服务端单 ctrl 会话会把旧 ctrl 自动降级（`s3_http/ws_sessions.c:194`），页面上提示"**标定时请勿同时操作控制页**" |

### 2.2 布局（单列卡片，沿用深色座舱主题与现有 CSS 类）

> **V1.2 起本节为历史记录**：卡片 A/B 的平铺已按标定流程重排为四步，监视器并入③、前提独立成①，现行排布见 §9。

```
┌──────────────────────────────────────┐
│ ●已连接   [状态chip]      [STOP 大红钮] │  ← STOP=sendDrive(0,0)，任何状态可用
├──────────────────────────────────────┤
│ ⚠ 判向标定将逐轮转动车轮，必须四轮离地    │  ← 常显安全横幅（warn 色）
├──────────────────────────────────────┤ 卡片A 编码器判向
│ 说明：每轮 250ms 脉冲共约 1.4s；          │
│ 结果仅本次上电有效（断电回默认值）          │
│ [×] 我已确认四轮离地                    │  ← 未勾选则按钮禁用
│ [ 开始判向标定 ]   （进度条 ▓▓▓░░ 1.4s）│
│ 结果表（M2 有回传后填充）：               │
│  轮       位置      delta  判定   状态   │
│  A(motor A) 前左   -1204  →-1   已翻转  │
│  B(motor B) 后左    +331  →+1   正常    │
│  C(motor C) 后右       0  →+1   无计数⚠ │  ← delta=0 标红：查编码器接线
│  D(motor D) 前右    +987  →+1   正常    │
├──────────────────────────────────────┤ 卡片B 闭环验证观察（复用现有遥测）
│  左侧  目标 ▓▓▓▓░░ 实测 ▓▓▓▓░░          │  ← 同控制页 gauge 样式
│  右侧  目标 ▓▓▓▓░░ 实测 ▓▓▓▓░░          │
└──────────────────────────────────────┘
```

### 2.3 状态机与互锁

```
idle → confirm(二次确认弹窗) → sending(发1帧) → running(1.4s+余量,互锁) → done
                                                     ├→ 超时(3s)→ fallback 文案
                                                     └→ 收到结果(M2)→ 填表
```

互锁规则（全部硬性）：

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

### 2.4 超时与降级（M1 的预期终点）

发出 0x70 后 3s 内未收到结果事件 → 结果区显示固定文案：

> 结果回传未启用（需 tc275_car 固件 M2）：请在 TC275 调试串口查看 `ENCCAL=` 行（invert[0..3] delta[0..3]）。

页面不报错、不复位，进度照常结束。

---

## 3. 通信协议契约（M1：既有通路，零改动，逐跳验收路径）

开发 AI 按此链路逐级自验：

| 跳 | 位置 | 行为 |
|---|---|---|
| 1 | 页面 `calib.js` | `ws.send(buildFrame(0x70, new Uint8Array(0)))`；v2 帧 `[SYNC1][SYNC2][VER][0x70][seq][len=0][CRC16be]`（参考 app.js:21 `buildFrame`） |
| 2 | `s3_bridge/bridge.c:153` | `bridge_post_cmd` 入队；0x70 非 DRIVE，走严格不丢路径 |
| 3 | `s3_link/link.c:286` | v2 cmd 0x70∈[`PROTO_CMD_DPT_ENTER`,`PROTO_CMD_DPT_SELFTEST`] → SF `TYPE_CMD(0x01)`、`CID_DPT(0x04)`、`payload[0]=op=0x70`、len=1 |
| 4 | SF-over-QSPI3 | 事务泵照旧（doc/14-sf-link.md；寄存器握手 + RDDMA/WRDMA 分段） |
| 5 | tc275_car `com/link.c:243` | CPU2 `link_dispatch`：CID 白名单含 DPT → `link_forward(0x70,…)` 入 xcore 命令队列 |
| 6 | tc275_car `mw/proto/protocol.c:110` | CPU0 `PROTO_handleCommand` case 0x70 → `XCORE_dirCalibRequest()`。**注意：不是驾驶命令——不发心跳、不受故障锁存门禁** |
| 7 | tc275_car `rt/motor_algo.c` | CPU1 消费请求 → `calibStart`（`MOTOR_stopAll`+`SERVO_reset`）→ 逐轮 250ms +12% duty 脉冲 + 80ms 停顿，共 ≈1.4s → delta<0 翻 `ENCODER_setInvert(-1)`，delta==0 记死通道 → 结束 `ENCCAL= invert[0..3] delta[0..3]`（仅串口） |
| 8 | 任意急停 | 0x32 或链路失联 → `ENCCAL aborted (estop)`，标定中止 |

**命名冲突（必须在代码注释里写明）**：字节 0x70 在 esp32c6_car 叫 `PROTO_CMD_DPT_ENTER`（`s3_proto/proto_frames.h:78`），在 tc275_car 叫 `PROTO_CMD_DPT_CAL_DIR`（`mw/proto/protocol.h:36`）——同一字节双语义，对 tc275_car main 基线的实际语义是**编码器判向标定**。

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

---

## 4. 结果回传协议（M2，跨仓库契约——本文档定义，实施分两仓库任务）

现状缺口：标定结果只有 TC275 串口 `ENCCAL=` 行，页面拿不到。M2 定义如下：

### 4.1 SF 帧定义（tc275_car 侧）

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

### 4.2 C6 侧解码与 WS 事件

- `s3_link` 收到 `TYPE_EVT/CID 0x22` → 解码 → 经 `s3_http` JSON 事件流下发：`{"t":"cal","status":n,"invert":[i0,i1,i2,i3],"delta":[d0,d1,d2,d3]}`（与现有 `"tc"/"otastatus"` 事件同通道同风格）；
- 页面收到 `"cal"`：填 §2.2 结果表；`delta==0` 行标红"无计数：查编码器接线"；`invert==-1` 行标"已翻转"；`status!=0` 显示对应原因；
- 兼容性：无 M2 固件时（页面在 3s 窗口内收不到 `"cal"`）走 §2.4 降级文案，不得报错。

### 4.3 回归与测试

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

---

## 5. 验收标准（AC）

**M1（本仓库独立可验收）：**

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

**M2（tc275_car 固件合入后）：**

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

---

## 6. 任务拆分建议

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

---

## 7. 附录

### 7.1 文件锚点

- esp32c6_car：`assets_src/index.html:62-86`（ctl 行与维护区）、`assets_src/app.js:6/21/173-205`（CMD 表/buildFrame/摇杆 30Hz）、`components/s3_bridge/bridge.c:153-184`、`components/s3_link/link.c:286-293`（DPT 映射）、`components/s3_http/ws_sessions.c:194-201`（单 ctrl 降级）
- tc275_car：`mw/proto/protocol.h:33`、`mw/proto/protocol.c:110-116`、`com/link.c:243`（CID 白名单）、`rt/motor_algo.c:30-57/183-288`（标定状态机）、`rt/encoder.c:62/327-339`（invert）、`mw/sf/sf_frame.h:60-96`（TYPE/CID 表）、`mw/xcore/xcore.c`（块规约样板）

### 7.2 TC275 串口行格式（台架对数用，115200 8N1）

```
SRV= tL mL dL tR mR dR     ← 1Hz，percent*10：目标/实测/输出 duty（MOTOR_ALGO_diag）
SPD= vL vR odo alive       ← 1Hz，mm/s / mm / 0|1（Cpu2_Main link_speedPrint）
ENCCAL start               ← 标定开始（要求四轮离地）
ENCCAL= i0 i1 i2 i3 d0 d1 d2 d3   ← 标定结束：各轮符号终值 + 脉冲计数 delta
ENCCAL aborted (estop)     ← 急停中止
```

### 7.3 判向结果固化（当前工作流，非本任务范围）

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

### 7.4 给开发 AI 的红线提示

- 只发 0x70，不发 0x71~0x79；0x70 不是心跳，不要把它当驾驶保活用；
- 不改 `s3_link` 的 v2→SF 映射表（0x70 通路已存在，改了反而破坏对齐）；
- 不在标定页面引入新依赖/构建步骤；样式复用现有 class；
- 改 `index.html` 仅限加一行入口链接，其余全部放新文件。

---

## 8 · V1.1 追加需求：逐电机手动控制 · 车辆可视化 · 参数与 DFlash 持久化

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

### 8.1 卡片 C：逐电机手动控制（台架 jog）

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

### 8.2 车辆可视化（4 轮运动状态）

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

### 8.3 卡片 D：参数与 DFlash 持久化

- 进入页面即发 `0x72 REC_GET`，用 EVT `0x23` 渲染**当前生效参数表**：每轮 位置 / 编码器方向（±1，`-1` 标"已翻转"）/ 全局 满量程速度 `fullScaleMmS` / 轮径 `wheelDiaMm` / 数据来源（默认值 · DFlash · 在线设置）；
- 编辑 `fullScaleMmS`（100..5000）、`wheelDiaMm`（30..200，前端范围校验）→ `0x73 REC_SET` **生效并写入 DFlash**；`0x74 REC_CLEAR` 恢复默认并擦除；
- `0x70` 自动判向成功后由 TC275 **自动持久化**，UI 无需手动存；EVT `0x22` 追加 `saved u8`（0 未持久化 / 1 已写 / 2 写失败），结果表显示保存状态；
- "运动方向"指**编码器计数方向 invert**（0x70 判向结果，生效项）；电机驱动方向属接线级事实（tc275_car `g_dirInvert` 编译期表），**不在本协议字段范围**，页面不显示、不下发。

### 8.4 协议追加（与 tc275_car 34 §9 同源；既有 0x70 通路与 s3_link 映射零改动）

DPT 命令族（SF `CMD` / `CID_DPT`，`payload[0]=op`；s3_link 现有 0x70~0x79 映射已覆盖，**不改 s3_link**）：

| v2 op | 名称 | payload（多字节小端） | 应答 |
|---|---|---|---|
| 0x70 | CAL_DIR（既有） | ∅ | EVT 0x22（追加 `saved u8` → 23 B，见 §4.1 更正） |
| 0x71 | MOTOR_JOG | `{motor u8, duty i16}`（3 B，duty=percent×10，钳 ±500） | 无（newest-wins，300 ms 固件超时） |
| 0x72 | REC_GET | ∅ | EVT 0x23 |
| 0x73 | REC_SET | `{pos u8×4, invert i8×4, fullScale i16, wheelDia i16}`（12 B） | EVT 0x23（生效+持久化回执） |
| 0x74 | REC_CLEAR | ∅ | EVT 0x23（默认值回执） |

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

新增事件帧：**EVT `SF_CID_DPT_REC = 0x23`**，payload **15 B**，逐字节（已与 tc275_car `mw/calib/calib_record.c:buildEvtRec` 实码核对一致）：

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

c6 侧改动点：`s3_link` 不改；JSON 事件流新增/扩展（`"cal"` 扩展 `saved` 字段、新 `"rec"` 事件）；`test/host` 补 0x71~0x74 触发帧与 `0x22/0x23` 解析用例。

### 8.5 里程碑与验收追加

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

**AC 追加（编号接 §5）：**

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

## 9 · V1.2 页面排布：按标定流程分四步

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

```
┌ header：台架标定 · fw · [车●][WS●] ┐
│ ▣ 常驻安全条 sticky：状态文案 [STOP] [配对] │  ← 滚动到任一步都能急停
│ 流程条 ①前提 ②判向 ③复核 ④落库（act/done/bad 四态）│
├──────────────────────────────────┤ ① 安全前提
│ ⚠ 横幅 + 四项清单（连接/控制权/车在线/四轮离地）│  ← 缺哪几项写在标题右侧
├──────────────────────────────────┤ ② 编码器判向标定
│ [开始判向标定] 进度条 结论 + 结果表（轮/位置/delta/计数方向/结论）│
├──────────────────────────────────┤ ③ 点动复核 · 车辆实时
│ 车辆俯视图 + 左/右"目标·实测"两条 gauge      │  ← 原卡片B 并入，消除与 cv_l/cv_r 的重复
│ 4 行 jog：轮位标签下挂"② 已翻转（计数 -1）"  │  ← 复核时对照在眼前
├──────────────────────────────────┤ ④ 生效参数与持久化
│ 来源 + "与②判定一致/不一致⚠(轮号)" + 位置/方向表 + fullScale/wheelDia + 写入/擦除 │
└──────────────────────────────────┘
```

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
