lilicqyu-ship-it/smartcar/smartcar_remote/doc/06-ui.md

# 06 LCD UI（main/ui，LVGL 9）

| 项 | 内容 |
|---|---|
| 代码位置 | `main/ui/`：`ui.c/.h`（页面管理）`ui_theme.c`（主题）`ui_joystick.c`（摇杆）`ui_home.c`（驾驶主页）`ui_pages.c`（Vehicle/Radio/Diagnostics/Settings/Pairing/Events）`ui_alert.c`（告警覆盖层） |
| 上游需求 | spec §3（响应式）、§4-§5（信息架构/页面清单）、§8-§22（驾驶主页/告警）、§31-§48（设置/校准/导航/手势）、§51-§57（颜色/主题/字体/图标/电量）、§59（状态决定 UI）、§70/§110（推荐布局）、§71-§76（Quick Panel/解耦/刷新率/卡顿）、§83（Event Log）、§86-87（用户/工程模式）、§111（验收清单） |
| 状态 | 🟩 **代码完成** — 触摸/显示/流畅度待真机 |

## 1. 线程模型（解耦的架构保证，spec §74-76）

```
LVGL 任务（BSP bsp_display_start_with_config：栈 9216 B、绑核 1）
 ├─ 100 ms 周期定时器：app_state_snapshot → 告警覆盖层 + 当前页刷新
 │    （全部经 ui_label_set_text/fmt 缓存写入——值不变不触碰对象，
 │      否则 10 Hz 无效重绘让 RGB bounce-buffer 供帧持续满载 → 屏幕抖动）
 ├─ 触摸/按钮事件回调（摇杆、STOP、设置控件）
 └─ 页面切换（单层导航，无跨任务对象访问）

scr_ctrl 任务（核 1，prio 5 > LVGL 4）：30 Hz，发送 try-only（见 04 §7），
   微秒级突发，不受 UI 负载影响也不阻塞 UI
scr_link 任务（核 0，网络侧）：不持有任何 LVGL 对象
跨任务通道：唯一 = app_state 快照（互斥拷贝，见 01 §3）
```

刷新分级（spec §75）：驾驶控制 30 Hz（ctrl 任务直发，不过 UI）、UI 值刷新
10 Hz、Radio 统计 1 Hz、静态信息仅 on_show。**没有任何 50 Hz 全量刷新路径**。

## 2. 页面清单（spec §5 → 实现映射）

| 页 | 实现 | 备注 |
|---|---|---|
| P0 Boot | `boot_create/refresh` | SMART CAR + 进度条 + LCD/Touch/Radio/System 四格 ✓；满格 600 ms 后 fade(250 ms) 进主页；无 DEBUG 输出（§7） |
| P1 Home | `ui_home.c` | 见 §3 |
| P2 Vehicle | `ui_pages` | State/Speed/Throttle/Steering/Mode/Battery(+V)/Odo/Fault/TC FW/HW；过期显示 `--` |
| P3 Radio | `ui_pages` | 状态行 + RSSI（数字 + 条形双表达 §25）/Quality/Latency(min/max)/Loss/TX/RX/Seq/Channel/Peer/LINK RTT |
| P4 Diagnostics | `ui_pages` | **工程模式条目**（§86-87）：Controller FW/Heap/PSRAM/Uptime + Radio + Vehicle Chain + Event Log 入口 |
| P5 Settings | `ui_pages` | 列表 + Control（模式三选/死区滑条）/Radio（SSID/密码 + 配对）/Display/About 四子页；危险项无（一阶段无恢复出厂） |
| P6 Pairing | `ui_pages` | 三步引导 + [PAIR] + 状态反馈（spec §40/41） |
| P8 About | Settings 子页 | 版本信息；**FW 值 3 s 内 7 连击 → 工程模式解锁**（spec §87，Toast 反馈） |
| P9 Alert Overlay | `ui_alert.c` | 见 §5 |
| Event Log | `ui_pages` | 工程模式条目；时间戳 + 等级着色（spec §83） |
| P7/P10 Calibration | — | ⚪ 二阶段（虚拟摇杆无硬件校准需求，死区/限幅即"校准"） |

导航：主页右上齿轮 → Settings；各子页 BACK → Home。**驾驶中不做滑动手势**
（spec §47 驾驶功能避免复杂手势；§48 禁止隐蔽急停手势）。

设置子页的值在**打开时一次性填充**（10 Hz 刷新绝不重写 textarea/滑条——
否则用户每敲一个字符都会被清掉）；软键盘的隐藏走 50 ms 延时（DEFOCUSED 与
FOCUSED 事件顺序竞态下，两个输入框间切换永不丢键盘）。

## 3. P1 驾驶主页（spec §70/§110 布局）

```
┌──────────────────────────────────────────────┐
│ SMART CAR          ● CONNECTED   [⚙]         │  顶栏 52 px：连接态(色+字) / 控制权
├──────────────────────────────────────────────┤
│ ┌─ 左列 36 % ─────────┐  ┌─ 摇杆区 ───────┐ │
│ │ SPEED               │  │                │ │
│ │ +1.25   (48 px)     │  │    大摇杆      │ │  flex 布局随分辨率伸缩
│ │ THROTTLE/STEER      │  │  (≤340 px)     │ │
│ │ BAT/MODE/STATE 行   │  │                │ │
│ │ RSSI/LAT/LOSS 行    │  └────────────────┘ │
├──────────────────────────────────────────────┤
│                  [ STOP ]                    │  底部固定 56 px，红，宽 ~33 %
└──────────────────────────────────────────────┘
```

- 信息**色+图标+文字**三重表达（§51/§11）：CONNECTED/STALE/CONNECTING/
  SEARCHING；S3 MASTER / NO CONTROL；READY/DRIVING/STOPPED/WARNING/FAULT/
  EMERGENCY。
- **模式一键切换**：信息行模式值可点，点击在 ECO→NORMAL→SPORT 间循环 +
  Toast 反馈（spec §33/§34，驾驶中 1 次触摸完成，不进设置页）。
- 过期数据处理（§101/102）：遥测过期 → 速度 `--`（含慢速倒车符号修正：
  -50 mm/s 显示 `-0.05` 而非 `+0.05`）；连接在但无数据 → STALE。
- STOP 按钮固定底部中央不随页面变化（§18）；按下时长在 UI 内计时，
  松开时分流单击/急停（§19）；RELEASED 无 PRESSED 配对（如按压中弹出
  覆盖层）一律按单击处理，防误触发急停。

## 4. 虚拟摇杆（ui_joystick，spec §13-16）

- 视觉：外圈 + 四向刻度 + 中心点 + 高亮旋钮（**3 px 描边而非模糊阴影**——阴影
  随拖动逐像素混合，是面板上最重的渲染路径，实测拖动闪烁 R-9）。
- 旋钮像素更新带 2 px 滞回（PRESSING 每次输入轮询都到达，坐标未变不重绘）；
  **控制输出不受滞回影响**，仍按触摸原始坐标全速率计算。
- **输入门控（失效保护）**：Home 页 10 Hz 下发
  `ui_joystick_set_enabled(conn==CONNECTED && owner==S3)`。门关闭时：输入
  全零、旋钮强制回中、控件置灰（不可驾驶的视觉语言，spec §104）；**拖动中
  失链不会留下"陈旧倾斜量"**——链路恢复时若手指仍停在盘上，摇杆保持惰性，
  抬手重按才恢复，杜绝恢复瞬间复出行驶指令。
- 门开启时：`PRESSING` 取屏坐标 → 相对中心、钳位到最大半径；
  **径向死区**（按压起始时从设置采样）+ 死区边缘线性重映射：
  `scale=(r-dz)/(1-dz)`，`v=-dy/r·scale·600`，`w=-dx/r·scale·300`（上=前进）。
- 释放：160 ms ease-out 回弹动画 + 输入归零；按压即调
  `scr_ctrl_joystick_touch()`（STOP 锁存的显式再接管，仅门开启时）。
- Throttle/Steering 实时百分比显示在主页（来自 `out_v/out_w`，§16：让用户
  看见"油门非零"）。

## 5. 告警覆盖层（P9，spec §20-22/§63）

- `lv_layer_top()` 全屏模态：等级配色（CRIT 红/WARN 琥珀/NOTICE 蓝）+ 红色
  边框（急停态 §63）+ 图标 + 标题 + 正文 + 动作按钮。
- 按钮语义：`id==EMERGENCY` → **[RELEASE]**（调 `scr_ctrl_emergency_release`）；
  其余 → **[ACKNOWLEDGE]**（`app_alert_ack`，条件解除仍由 raise/clear 管理）。
- 等级门槛：仅 WARNING/CRITICAL 进覆盖层；RSSI 低等提示只走状态栏（§22）。

## 6. 主题与字体层级（spec §51-54）

深色主题（§52）：`#0E1116` 底 / `#1A2029` 卡片 / 亮字 `#E8ECF1`；
语义色 OK `#34C77B` / WARN `#F5B944` / CRIT `#F5475B` / INFO `#4D9FFF` /
ACCENT `#2FA4FF`。

字体四级（§54）：48 px（速度）→ 28 px（STOP/标题）→ 20 px（页标题）→
16/14 px（值/说明/Diagnostics）。图标统一 LVGL 内置符号集（一阶段，§55
统一视觉语言）。

## 7. 资源

| 项 | 值 |
|---|---|
| LVGL 任务 | 栈 9216 B / prio 4 / 绑核 1（`bsp_display_start_with_config`，覆盖 BSP 默认值） |
| UI 定时器 | 100 ms 单实例 |
| RGB 供帧 | **防撕裂 DIRECT_MODE**：三全尺寸帧缓冲（PSRAM，3×768 KB）+ bounce-buffer（高度 20）+ VSYNC 同步——局部重绘不再与扫描相撞（撕裂/抖动的根因）；FULL_REFRESH 已实测否定（每次小失效整屏重绘 → 闪屏）。**供帧带宽前提（2026-09-29 R-10）**：必须与官方 `lvgl_demos` 一致——CPU 240 MHz（`CONFIG_ESP_DEFAULT_CPU_FREQ_MHZ_240`）、`SPIRAM_XIP_FROM_PSRAM`（flash 写时 bounce ISR 仍可读 PSRAM）、D-cache 64 KB / 64 B、`-O2`（PERF）、3 帧缓冲；缺任一项在开机 PHY 校准或 Wi-Fi 负载下即出现割裂。禁用 `LCD_RGB_RESTART_IN_VSYNC`（bounce 模式下致雪花屏） |
| 对象规模 | 全部页面一次性创建后隐藏切换（无运行时创建/销毁，除 Event Log 列表与 Settings 列表重建） |
| Toast | 顶层单例 label + 1.4 s 一次性定时器（§34 模式切换反馈） |

## 8. 完成状态表

| # | 功能 | 状态 | 证据 / 缺口 |
|---|---|---|---|
| U-1 | 800×480 flex 响应式布局 | 🟩 | 比例化布局；真机显示未验 |
| U-2 | P0/P1/P2/P3/P5/P6 页面 | 🟩 | 代码完成；触摸联调未做 |
| U-3 | 摇杆（死区/回弹/实时值） | 🟩 | 算法见 §4；手感待实驾调 |
| U-4 | STOP/急停 UI（长按分流 + 误触发防护） | 🟩 | 待 HIL |
| U-5 | 告警覆盖层（ACK/RELEASE 分流） | ✅ | 逻辑与 01/05 对齐；多告警仲裁见 01 §4 |
| U-6 | Event Log 页 | ✅ | 读取环形日志，增量重建 |
| U-7 | 工程模式门控（7 连击） | ✅ | 解锁 Diagnostics/Event Log 条目 |
| U-8 | 摇杆禁用（无控制权/断链） | ✅ | 门控 + 置零 + 回中 + 置灰，见 §4 |
| U-9 | 设置页输入稳定性 | ✅ | 子页打开时一次性填值；键盘 50 ms 延时隐藏 |
| U-9 | Quick Panel 下滑抽屉 | ⚪ | spec §71 二阶段 |
| U-10 | 滑动切页 / 页面过渡动画 | ⚪ | 防驾驶误触（§47）；开机→主页有 250 ms fade |
| U-11 | 屏幕常亮策略 | ⚪/✅ | SUB3 背光硬件常亮，天然满足 §37"驾驶不黑屏" |

## 9. 已知限制与风险

1. **LVGL 任务栈已提升至 9216 B**（原 BSP 默认 7168），Settings+键盘页的
   最深调用路径留有余量；真机仍应读 `uxTaskGetStackHighWaterMark` 复核。
2. Event Log 列表整列表重建（32 条上限，1 Hz 内触发，成本可控）。
3. 图标为 LVGL 符号字体，开机页"小车"占位符是通用图标——正式视觉资产
   （SVG→C 数组）属 spec §92 UI Phase 6。
4. 主页信息行约 10 个 label 每 100 ms 重设文本（值变化才重绘出内容，但
   invalidate 每次发生）；800×480 RGB + bounce-buffer 下余量充足，
   若真机测出帧率问题再按字段缓存。
