lilicqyu-ship-it/smartcar/tc275_car/doc/40-esp32c6/41-c6-docs-map.md

# 41 · ESP32-C6 侧文档地图与跨仓库边界

| 项 | 内容 |
|---|---|
| 文档编号 | 41 |
| 域 | ESP32-C6（C6 固件开发） |
| 版本 | V1.3（2026-09-27：§3 T4 的主机侧读法改按 22 号文档 V1.6 新口径——**单读快照 + 消费端钳位**，原"连读两次取相同值"规范已随链路泵简化（`ae10aac`）废弃）。V1.2（2026-09-26，随 doc 目录重构建立；V1.1 = §4 补入板间连线电气形态（杜邦线直连、无外部上拉）与 Debug 已定义 `USE_SPI_LINK` 的现状，登记 C6 侧 `link.c` 注释待更正；V1.2 = §3 T6/§4 按"UART 板间链路弃用、Release 也定义 `USE_SPI_LINK`"改口径，并写明恢复 UART 是双侧刷机动作） |
| 为什么在本仓库 | C6 固件的**代码与模块设计在 `esp32c6_car` 仓库**，但"两板之间怎么连、谁对什么负责"这件事的裁决权在 TC275 侧。本篇是**边界声明 + 索引 + 跨仓库待办清单**，不镜像 C6 内容（避免双写漂移） |

---

## 1. 两个仓库的分工

| 主题 | 真源在哪 | 具体位置 |
|---|---|---|
| 产品需求、量产架构、安全模型、里程碑 | tc275_car | `21-software-design.md`（基准） |
| **板间物理层：引脚、线束、时钟档位、上拉** | tc275_car | `23-wiring.md §9.1`（实物已接线）+ `§9.3`（电气形态：杜邦线直连、无外部元件） |
| **LINK 段帧格式（SF 帧）与事务模型、握手寄存器、门禁 G1~G6** | tc275_car | `22-link-spi-design.md` |
| 手机侧协议（v2 帧）、命令/遥测表 | tc275_car | `21 §6.1b/§6.2/§6.3` |
| C6 内部：任务模型、组件接口、WS 会话、配对、OTA 自身、assets、BLE DPT | **esp32c6_car** | `esp32c6_car/doc/00~13`（下表） |
| C6 侧构建/烧录/签名/主机单测怎么跑 | **esp32c6_car** | `esp32c6_car/README.md` |
| 控制页前端（摇杆 + 50 Hz 仪表） | **esp32c6_car** | `esp32c6_car/assets_src/` + `esp32c6_car/doc/12` |

一句话：**C6 怎么实现自己 = esp32c6_car；C6 与 TC275 之间长什么样 = tc275_car 的 21/22/23。**

## 2. `esp32c6_car/doc/` 索引（14 篇，含与 TC275 侧的对齐点）

| 篇 | 主题 | TC275 侧要对齐的文件/节 |
|---|---|---|
| 00 | 总览与完成状态矩阵 | 看链路/协议改造进度时以它为准；对齐 `22 §7.1` |
| 01 | 应用状态机与启动编排（`app_main`/`app_state`） | `21 §3.4` 初始化时序（C6 侧对应物） |
| 02 | proto v2 帧编解码（`c6_proto`） | **同一份纯 C 源码在 TC275 侧复用** → 改帧必须两仓库同审；对齐 `21 §6.1b` |
| 03 | 出厂数据（`c6_factory`，NVS：SN/密钥/预配对表） | `21 §4.2` 分区表、`21 §8` 身份与配对 |
| 04 | LINK 链路（`c6_link`）**已换向 SPI 从机**（2026-09-26）| `22 §4`（事务模型）、`22 §7.1`（改动清单，C6 侧已执行）、`23 §9.1`（接线）；详设见 `esp32c6_car/doc/14` |
| 05 | 接入网（softAP / Captive DNS / mDNS） | `21 §11` UX、`11-requirements.md §5.1` |
| 06 | 配对与会话（token、30 s 宽限） | `21 §8.2` 配对流程 |
| 07 | Web 服务与 WS 会话（含 assets 流式、REST/OTA 端点） | `31 §8`（demo 的 HTTP 现状，量产由 C6 承担） |
| 08 | 三台泵（命令 / 遥测广播 50 Hz / OTA 中继信用窗） | `21 §3.5` 数据流、`21 §9.2` OTA 流程 |
| 09 | 自身升级与 ed25519 验签、A/B 回滚 | `21 §9`、`21 §8` 反回滚 |
| 10 | BLE DPT 产测通道（默认关） | `21 §10` 产测序列 |
| 11 | TCP 8080 遗留直通桥（默认关） | 与 demo `31 §6/§8` 的兼容通道 |
| 12 | 控制页源码与工具链（`build_assets.py`/`sign_bundle.py`） | `21 §11` 交互结论 |
| 13 | 验证与测试状态汇总 | `21 §13` 质量工程、`22 §8` 门禁 |

访问路径（同级仓库）：`../esp32c6_car/doc/`（从仓库根）或 `../../../esp32c6_car/doc/`（从本文档所在目录）。

## 3. 跨仓库待办（SPI 链路启用前必须清）

| # | 待办 | 落点 | 判据 |
|---|---|---|---|
| T1 | `c6_link` 传输层由 UART 改 `spi_slave_hd`（半双工 + 共享寄存器 + IRQ），`link.h` 对外 API 签名不变，`bridge`/`ota_relay` 不感知物理层 | `esp32c6_car/components/c6_link/`，`esp32c6_car/doc/04` | `22 §8` G1~G2 |
| T2 | 删除 UART 专有物：0x44 BAUD REQ/ACK/NAK 状态机、`C6_LINK_TX_GPIO`/`RX_GPIO` 配置项 | 同上 + `Kconfig` | 全仓库 grep 无 `0x44` 波特率协商残留 |
| T3 | **调试串口脚位统一**：Kconfig 现在默认 `TX=10 / RX=11`，与实物接线（`23 §2` 的 GPIO6=RX / GPIO7=TX，J1-5/6）不一致 | `esp32c6_car` Kconfig + help | 文档、Kconfig、实物三者一致 |
| T4 | C6 侧发布 6 个 u32 握手寄存器（`SF_READY`/`SF_TX_PENDING`/`SF_RX_ROOM`/`SF_ALIVE`/`SF_ERRSTAT`/`SF_CMDRSP`）；主机侧**单读快照 + 消费端钳位**（2026-09-27 起，`22 §4.2` V1.6——原"连读两次取相同值"规范已废弃） | `22 §4.3` | G1 |
| T5 | OTA 分片上限 62 B → 240 B（4 B 对齐约束带来的红利），两端同步 | `esp32c6_car/doc/09` + `21 §9.2` | G5 提速档下 OTA 1 MB ≤3 s |
| T6 | `esp-at` 工程保留为**应急返修镜像**：G1 失败时刷回 esp-at 走 UART 通道（**2026-09-26 起 UART 已弃用**，还需 TC275 侧删除 `USE_SPI_LINK` 重编，双侧动作） | `23 §2`、`21 §16 R4`/`R7` | 回退流程可复现（含 `AT+UART_CUR=115200,8,1,0,0` 关流控） |

## 3.1 C6 侧落地状态（2026-09-26 更新，`esp32c6_car` 仓库）

| # | 状态 | 说明 |
|---|---|---|
| T1 | ✅ 完成 | `c6_link` 重写为 `spi_slave_hd` 段模式从机；`link.h` 对外保持 v2 帧 API，**v2↔SF 映射落在 c6_link 内部**（与原计划"在 c6_bridge 里做"不同——见 `esp32c6_car/doc/14-sf-link.md` 差异记录 D1），bridge 仅新增 EVT→WS 文本一行 |
| T2 | ✅ 完成 | 0x44 BAUD 状态机、PING/PONG、`C6_LINK_TX/RX_GPIO` 全部删除；全仓 grep 无残留（v2 头中 0x43/0x44 常量同步移除） |
| T3 | ✅ 完成 | SPI 五线 Kconfig 按 23 §9.1（19/18/20/23/21）；调试串口 GPIO6/7 以文档锚点项固化 |
| T4 | ✅ 完成 | 6 个 u32 寄存器按 22 §4.3 发布（SF_GEN 槽在偏移 24），GEN 回执/静默模式/时钟镜像已实现 |
| T5 | ✅ 完成 | OTA CHUNK 240B（`link_send_ota_chunk` 快路径）；**TC275 侧 `mw/sf/` 已落地**（22 §7.2）。注意两侧是**同一份线格式的独立实现**（C6 用 `c6_sf`、TC275 用 `sf_frame.c`，API 不同名），因此常量必须逐项目视对齐：寄存器偏移 / READY magic / LEN 上限 / 段长已核对一致（22 §7.1） |
| T6 | 未动 | esp-at 回退镜像职责不在 esp32c6_car 仓库 |

C6 侧验证状态：主机单测 33/33 绿（新增 test_sf 7 项）、`idf.py build` 0 error。
**22 §8 G1 波形兼容（R7 硬风险）待台架**：两侧代码均已就绪，缺的是逻辑分析仪（TC275 侧 TASKING IDE 构建链接闭合已于 2026-09-26 达成，22 §7.2）。

## 4. 现状提醒（别把已接线当成已启用）

`23 §9.1` 的 SPI 五行 + 共地**实物已接好**，**两侧固件代码也都已改为 SPI**（C6 侧 `esp32c6_car` `22e15f2`；TC275 侧 `com/`，**Debug 与 Release 两个 TASKING 配置都已定义 `USE_SPI_LINK`——UART 板间链路于 2026-09-26 弃用，见 `21 §5.6` 末条与 `21 §18 C15`**，UART 分支只在手动删除该符号时才编译，见 `32 §1`）。但**这条链路从未通电跑过**：TC275 侧编译链接已闭合（2026-09-26），板上实际刷的镜像仍未验证。**后果（C6 侧要一起认）**：G1 失败时不再有"刷回 esp-at 就能通"的单向退路——恢复 UART 需要 TC275 删符号重编 + C6 重刷 esp-at 两侧动作，`esp32c6_car` 的构建/文档若把 UART 当作现成回退通道来写，口径已过期。

**电气形态（2026-09-26 已确认，coding 必读）**：两板之间**所有相连引脚都是杜邦线直连，没有任何外部电阻**（无上拉/下拉/串阻/端接/电平转换），真源见 `23 §9.3` 与 SDD `§18 C14`。对 IRQ（GPIO21 → P23.0）这条线的直接后果：

- 唯一上拉是 **TC275 片内** `IfxPort_InputMode_pullUp`；C6 侧 `esp32c6_car/components/c6_link/link.c` 以开漏输出且显式写了 `GPIO_PULLUP_DISABLE`，其"`/* external 10k (22 §3.2) */`"注释与实物不符，**待该仓库更正**。
- 握手是**电平轮询**（P23.x 做不出边沿中断，22 §3.1 E11），且片内上拉驱动能力弱、线又长，电平边沿慢且可能带毛刺：只采样静态电平，不做边沿计数/消抖状态机。
- **判活只看 `SF_ALIVE`**：`IRQ 高 ≠ 从机在位`，`MISO 读回 0x00/0xFF ≠ 应答`（那是浮空/默认值，不是回答）。
