lilicqyu-ship-it/smartcar/tc275_car/doc/20-design/22-link-sequence.html

深色

风格

视觉表达S 循环切换

经典稳定的技术默认风格 信号流突出动态流向 蓝图工程评审 编辑风格适合发布与上线说明

动态 演示

导出

导出图表便携、整洁的输出

E

分享 分享卡片1200×630 PNG 路径分享卡片1200×630 PNG 可达范围分享卡片1200×630 PNG 复制分享卡片复制 PNG 到剪贴板 复制图表复制 PNG 到剪贴板

图像 PNG无损图像 JPEG紧凑图像 WebP现代图像格式

矢量与动效 SVG可编辑矢量图 WebM6 秒动效

# TC275 ↔ ESP32-C6 板间 SPI 链路交互

SF 帧半双工事务：QSPI3 主机轮询拉取 + 共享寄存器握手（doc 22-link-spi-design V1.6）

←

引导视图

探索此系统 沿精选路径逐步查看，而不改变源图表。

节点

→

▶ 播放故事 # 复制此刻 显示全部

就绪 章节 01 / 01

引导章节

图表指南 探索此系统 ×

正在检查已编译语义

01 查找任意节点搜索标签、职责、类型和稳定 ID。 / 02 追踪路径查看两个语义节点如何按编写方向连接。 R 03 查看完整系统打开带实时视口和稳定节点的语义雷达。 M 04 比较语义类型统计角色、显示流量并比较直接编写的连接。 L 05 播放引导故事浏览已编写的章节和真实关系。 P 06 进入演示模式让实时图表占满视口，同时不改变导出。 F

E 导出T 主题S 风格0 重置+ 放大- 缩小Esc 关闭

查找节点 ×

⌕ /

没有匹配的节点

语义护照

已验证来源

编写可达范围

上游0 下游0

× 复制链接 关系

路径探测 选择起点节点 查找起点 复制链接 清除

在图表中选择两个语义节点

← ▶ 旅程 → 总览

先选择来源，再选择目标；方向很重要。

语义透镜 比较系统角色 ×

最多选择两种语义类型。选择一种可显示其真实流量；选择两种只比较直接编写的关系。

选择一种类型以检查其节点和相连关系。

复制链接 清除

语义雷达 正在构建总览 打开雷达 ×

点击节点拖动平移

语义雷达需要更多地图可见空间。

路径 地图 透镜 100%

### 主机拉取模型

- • C6 半双工不能主动推送：IRQ 提示 + 2 ms 保活轮询兜底
- • 每圈顺序固定：寄存器快照 → 读(优先) → 写 → 判活
- • 命令链路段时延 ≤2.3 ms，端到端预算 50 ms

### 安全语义

- • LINK_LOST / 急停都走 XCORE_estopRequest 锁存，受控停车
- • 急停旁路 CPU0 队列深度，不等出队
- • SEQ 严格前进窗口(32)、连续 8 帧越窗即重锁 + CRC16，从机 ERRSTAT 七位粘滞可读

### 三条硬握手契约

- • 寄存器单读快照 + 消费端钳位（V1.6：E5 非原子属实，但双读比对越忙越误判失联，已废弃）
- • RDDMA/WRDMA 必须以 INT0/WR_END 收尾（E12，否则从机卡死）
- • GEN 回执跨两次从机任务调度，必须带 20 ms 超时（E14）
