lilicqyu-ship-it/smartcar/ios_remote/doc/screenshot-home-radiolost.png

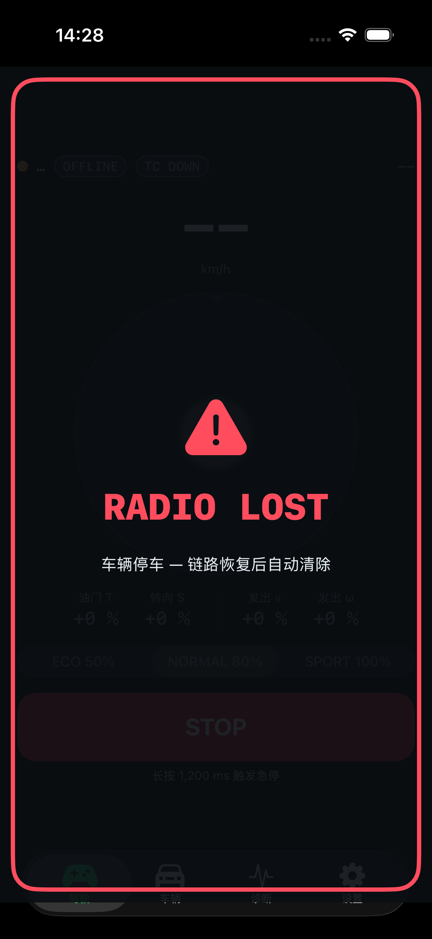
ios_remote/doc/screenshot-home-radiolost.png
