lilicqyu-ship-it/smartcar/ios_remote/doc/ui-alert-radiolost.png

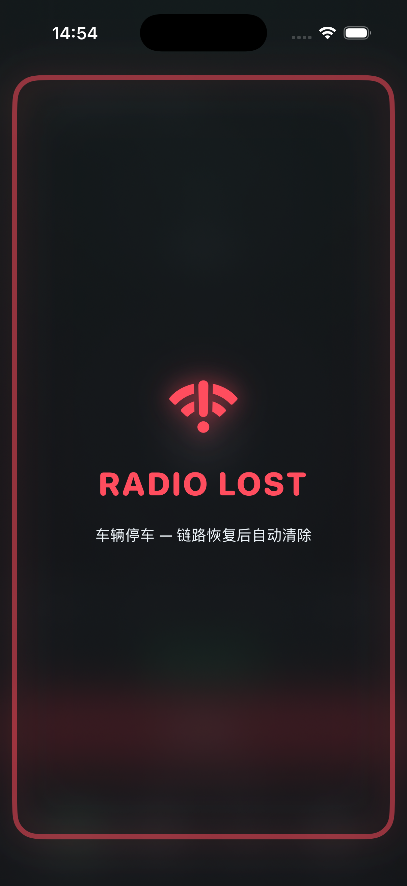
ios_remote/doc/ui-alert-radiolost.png
