lilicqyu-ship-it/smartcar/ios_remote/doc/ui-diag.png

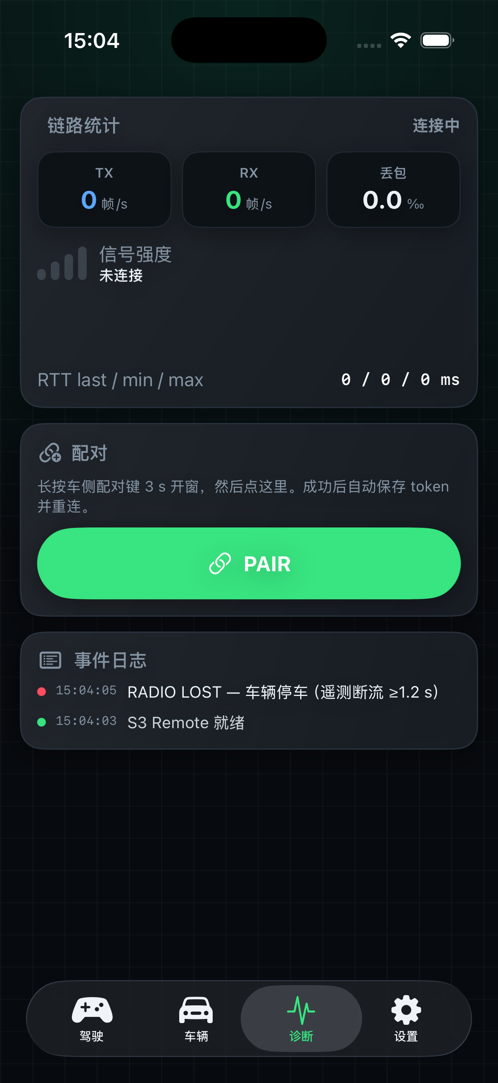
ios_remote/doc/ui-diag.png
