lilicqyu-ship-it/smartcar/ios_remote/doc/ui-home.png

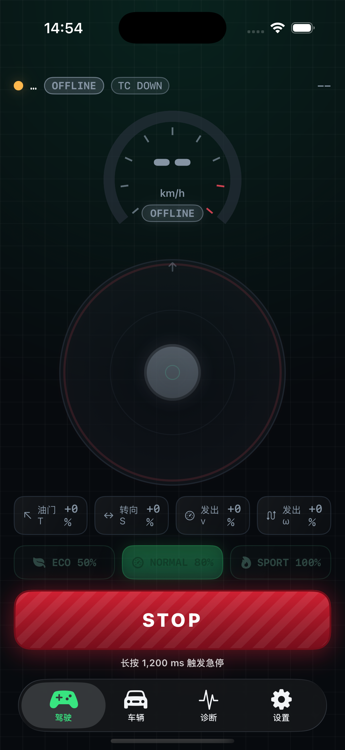
ios_remote/doc/ui-home.png
