lilicqyu-ship-it/smartcar/ios_remote/doc/ui-settings.png

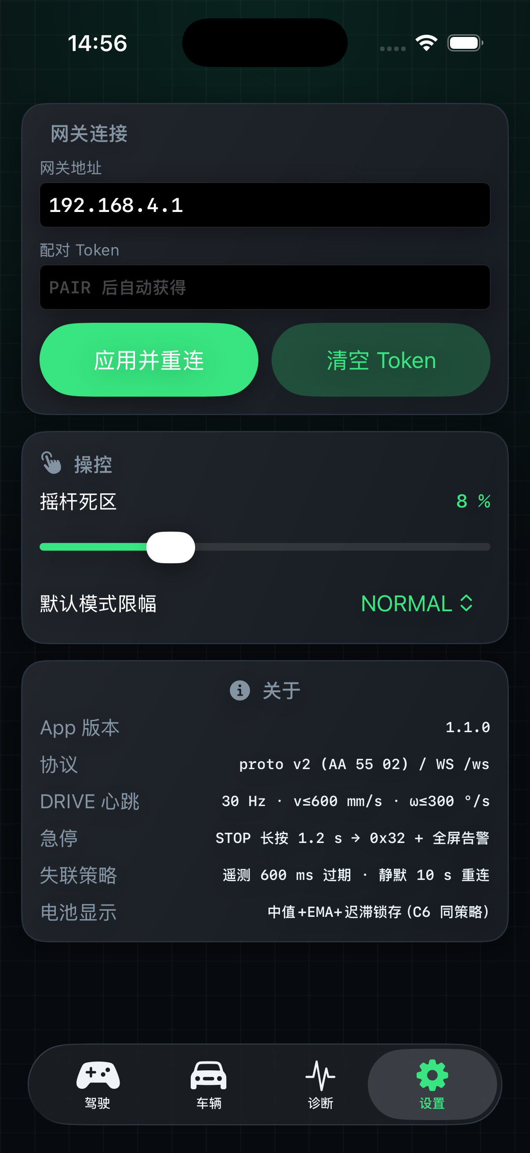
ios_remote/doc/ui-settings.png
