lilicqyu-ship-it/smartcar/ios_remote/doc/ui-vehicle.png

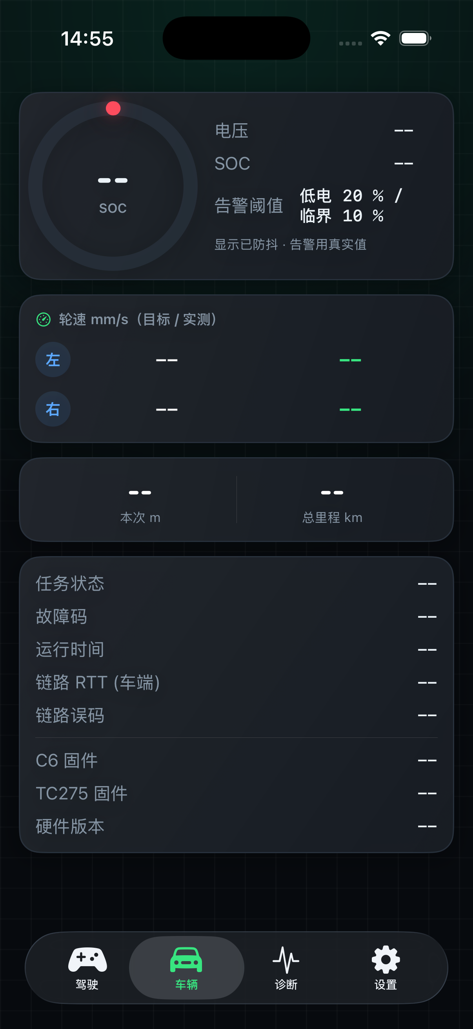
ios_remote/doc/ui-vehicle.png
