lilicqyu-ship-it/smartcar/tc275_car/doc/20-design/23-wiring.md

# AURIX SmartDrive 接线图（TC275 + ESP32-C6 + D24A 四路驱动板）

> 文档编号 **23** · 域 设计·硬件 · 定位：**引脚与接线真源**（脚位/孔位冲突以本文为准） · 上级索引 [00-index.md](../00-index.md)

版本：V1.23（2026-10-04：**§3 STBY 受控化 + 新增 §3.2**——TB6612 的 STBY 从"J4-2 跳 J4-1 板载 3V3 常使能"改为 **TC275 GPIO 受控：P22.2 / X1-16 → J4-2**（一片 GPIO 管四个电机：两片 TB6612 的 STBY 在 D24A 板内是**同一网络**，只从 J4-2 引出，J6 无独立 STBY 脚）。§3 表 STBY/3V3 两行改写、§1 状态行标 🔌 待改线、§3.1 电机驱动行登记两条电气事实（VCC=板载 5V ⇒ `VIH(STB)=3.5 V`；**全部控制输入含 STBY 内部 200 kΩ 下拉** ⇒ 浮空=低=关断，板内无上下拉/跳线帽座）。**§3.2 新节**给出选脚判据（P22.2 五条排除审计 + 备选脚）与三条事实的后果：① 片内下拉使"MCU 复位/未烧录 = 驱动未解锁"无需外部元件，**§9.3 的"杜邦线无外部元件"口径不用破**，并回答 21 §7.1 挂着的"复位期间 TB6612 输入行为未核实"（纸面=滑行）；② 3.3 V 驱动低于 `VIH(STB)=3.5 V` 保证门限，**与原跳线接法同级裕量、非新引入缺陷**，spec-clean 需 PMOS 抬到 5 V——本批不做；③ 与 21 号"安全态=STBY 拉低"存在语义冲突（拉低会使 `MOTOR_ALGO_brakeAll` 的短接刹车退化为高阻滑行、急停距离变长），**本批只做"上电使能 + 未跑固件即断电"，急停/故障路径不碰 STBY**，待用户放行。固件落点 `bsp/motor.c`（`MOTOR_STBY_PORT/PIN`、`MOTOR_setEnabled()`、`MOTOR_init()` 末步拉高，属主 CPU1）。**改线与刷固件必须同批**。01-getting-started 第 4 步、21 §5.2/§7.1/§17、33 §9、00-index 同批同步）。V1.22（2026-10-04：按用户要求，ToF I2C0 复测切换到 P02.5=X304-7 / P02.4=X304-8，见 §11.6；原 mikroBUS 接线保留为历史记录）。V1.21（2026-10-03：**新增 §11「TC275 ↔ VL53L5CX 8×8 多区 ToF」并定稿 + §10.1 INT2 孔位更正**——① ToF 归属经"挂 C6 还是挂 TC275"对比后定在 **TC275 I2C0**（本工程只有一模块 I2C0，`IfxI2c_PinMap.h:74-79`），脚位 **SCL=P13.1 / SDA=P13.2**，落在 mikroBUS 12/11 号孔，整把插座一次接线；② **INT=P10.7**（mikroBUS 15 号孔；**写本节时逐条核 iLLD 后发现：`IfxScu_REQ4_P10_7_IN` 的 `channelId=0`，与 IMU 在用的 `IfxScu_REQ0_P15_4_IN` 是同一条 ERU 输入通道 ⇒ 二者不能同时做边沿中断**，`IfxScu_PinMap.c:61,73`。孔位按用户批准保持不变，**消费方式改为 CPU0 电平轮询**，边沿中断备选脚（P10.8/P20.9/P20.0）在 §11.2 登记但本批不做）；③ **LPn 采方案 A**——47 kΩ 上拉到 IOVDD、**不占 MCU 脚**，省出 P10.6（该脚受 Table 2 的 R31 空焊约束）；④ §1 状态一览登记 ToF 行 + §1 补"**I2C 总线上拉例外**"口径（iLLD 把 SCL/SDA 配成开漏，`IfxI2c.c:220-228`，故 §9.3 的"杜邦线无外部元件"在这条总线**不成立**：SDA/SCL 2.2 k、INT/LPn/I2C_RST 47 k 是手册硬要求）；§5.2 电流预算并入 ToF 典型 **95 mA**（max ≈130 mA），扣后 VEXT 余量 ≈600 mA；mermaid 增 I2C0/ToF 节点；⑤ **§11.2 新建「ERU 输入通道占用矩阵」**（8 通道 × 4 选择、17 路 REQ 全量对照孔位与本工程占用），并据此更正 §9.1 两处的错误措辞——**"TC275 无 ERU"是错的**（IMU INT1 正在用），正确说法是"**P23.x 一颗都不在 ERU 的 REQ 清单里**"，22 号 E11 与 §9.1 的结论不变；35 号 §2.1 的 INT2 孔位、00-index 的 23 行与 G2 缺口条目同批同步。**明确不做（本批）**：`.cproject` 的 `I2c/*`、`Port/Io` 排除未解除（须与真实 `bsp/tof.c` 同批改才能验零告警）、ST API 与固件 blob 未引入、SDD §18 C2 未登记 I2C0/ERU 新优先级与 OGU 通道。② §10.1 更正：**INT2 实际孔位 = X1-29（P15.5/SDA0）**，原文记 X1-30 有误——**X1-30 是 PORST_N 复位网**，用户实物已改插 29；§10.1 表行与末条孔位列表同批修正）。V1.20（2026-10-03：**§10 IMU 首验 ① 台架通过 + 运行中静默判据**——实物已接线；实测上电 `IMU ready (WHOAMI=0x71, ODR 240Hz, +-4g/+-500dps, 1MHz)`、静置六轴 `595 479 -649`（模 **995 mg**）、`err` 恒 0 ⇒ V1.19 遗留的"首验 ① 未过（`id=0x00`＝MISO 未被驱动）"**结案**，0x71 身份与小端/加计 Z,Y,X 解码同时获得实物证据。新登记**三项未结**（§10.2 状态）：① **运行中静默**（六轴全 0 ＋ `tempC` 恰好 2500 ＋ `drdy` 冻结 ＋ `err` 仍 0；`drdy` 同步冻结排除"MISO 单线断"，病因收缩到 VCC/GND/SCL/CS 公共路径或器件自复位；35 V1.3 已把"14 B 全 0"判成读失败并接回 1 Hz 重探自愈）；② `drdy` 实测 **+399/行 vs 期望 +480（-17%）**，候选为 ERU 吞沿或 STIME 时基偏慢——**未结前不提时钟档**；③ 示波器实测 **SCLK 5 µs（200 kHz）** vs `clk` 字段报 1 MHz（iLLD 反算假设 QSPI 输入＝fMAX，全仓无 `IfxScuCcu_init()`）。§1 状态行/§10 标题/§10.2 状态注回写；随 35 号 V1.3）。V1.19（2026-10-03：**§10 IMU 固件侧驱动落地**——`bsp/imu.c/.h`（CPU1 属主，QSPI1 主机 SPI 模式 3、1 MHz 起步档位；WHO_AM_I=0x70 探测 + SW_RESET/BDU/IF_INC 配置，默认 ±4 g/±500 dps/240 Hz；每 5 ms 一次 0x20 起 14 B 突发（温度+陀螺+加计）；INT1 P15.4 走 SCU ERU（输入通道 0→OGU0）**仅计数**，作本节 §10.2 ③ 的台架证据；QSPI1 TX/RX/ER=11/14/15、ERU DRDY=24（21 §18 C2 已登记）；xcore 新块 `XcoreImu`（mg/mdps/0.01 °C 域 + seq）；失联 1 Hz 重探、接线下自愈免重启；主机单测新增 `test_imu` 55 断言）。本节 §1 状态行/§10.2 状态注已回写；**待实物接线 + §10.2 台架首验**，固件侧判读规程见 [35-imu-driver.md](../30-tc275/35-imu-driver.md) §7。V1.18（2026-10-03：**新增 §10「TC275 ↔ LSM6DSV16BX 六轴 IMU」**——3.3 V 供电/3.3 V 接口模块走 **QSPI1**：SCLK=P11.6(X1-36)、MTSR=P11.9(X1-35)、MRST=P11.3(X1-37)、CS=SLSO3 P11.10(X1-34)，INT1=P15.4(X1-31，数据就绪，推荐接)、INT2=P15.5(X1-30，运动事件，可选)，VCC 取 **X1-2 VEXT**（LDO G1 1 A 预算内）；冲突检查三结论：P11.3/6/9/10 丝印为以太网 MII 名（kit 无 PHY，可安全复用）、P11.10 与 Shield2Go 2 号座 CS 复用（禁同插）、P15.4/5 在 SCU ERU 通路（REQ0/REQ13）**可边沿中断**——与 P23.0/P33.x"无 ERU"口径相反；QSPI3 板间主链路不挂 IMU 的理由在案；需求定位 F13（V2.0 感知层）提前锁脚位，**待实物接线 + WHO_AM_I 首验**。§1 状态一览/§1 mermaid/§5.2 电流预算同步）。V1.17（2026-09-30：**§8 编码器刻度修正**——实物 MG310 编码器为 **13 PPR** 霍尔 AB（此前误记 260 线）：×4 解码 = 52 计数/电机转，×20.409 减速 = **1061.27 计数/轮转**（48 mm 胎周长 150.8 mm，0.1421 mm/计数），§8.1/§8.3/§8.4 数字与默认 `wheelDiaMm`（65→**48**）同步更正，固件 `rt/encoder.h`、`mw/calib` 同批；随 34 V1.4。V1.16（2026-09-27：**§8.4"开环等价"由固件强制执行**——随 34 号 V1.3 闭环使能门（`g_closedLoopOk`，src=0 记录强制 SERVO 开环等价、0x70 DONE 自动开门），根治"编码器已接线但方向未标定 → 闭环正反馈、原点回中电机仍转"的台架现象；本节"判向结果自动落盘"条补门机制与两条门日志，V1.15 内容不变。随 34 号 V1.3）。V1.15（2026-09-27：**§8.4 追加"标定持久化与台架命令"小节**——`0x70` 判向结果自动写 **DFlash0 扇区 15**（掉电保持、静止才写、校验失败回落默认 `src=0`）、EVT `0x22`(23 B)/`0x23`(15 B) 回传、`0x71 MOTOR_JOG` 单轮手动验证（钳 ±500 / 故障门禁 / 300 ms 超时）、`0x72~0x74` 读写清标定参数（`fullScaleMmS`/`wheelDiaMm` 不再需要重编固件）；随 SDD V1.10，真源 [34-calib-dpt.md](../30-tc275/34-calib-dpt.md) §8/§9/§11。V1.14 = 2026-09-27：**电池电压采集落地**——§4 J6 表 ADC 行接 **X2-23/AN4**（D24A J6-1 分压 VIN/11），新增 **§5.5**（信号链/VAREF 基准/固件 100 Hz+EMA/验收，含"台架量 X2-15 核对 VAREF"动作）；固件 `bsp/adc.c` + xcore 电池块 + 遥测 `batteryMv/Pct` 转 ✅（SDD V1.8）；`.cproject` 解除 `Vadc/{,Std,Adc}` 排除。V1.13 = 2026-09-27：**新增 §3.1「D24A 驱动板原理图详解」**——把驱动板原理图 REV1.0 的板内电路登记为真源：5V 降压 TB6288GSP(U1)、3V3 LDO RT9013-33(U4)、双 TB6612FNG(U8/U2)、过温(P_EN/NTC)与过流使能网络、连接器清单(J5/J7/J8/Motor_A~D/KEY1)，并明确"逻辑电全板载自产、编码器 3V3 参考即此 LDO、动力经 VM 不经 3V3"三条使用前提；§3/§4 对外脚位表不变）。V1.12（2026-09-27：**§8.4 步骤 2 判向自动化**——`0x70` 命令触发 CPU1 脉冲判向、`g_encInvert` 运行时翻转（`ENCCAL=` 结果行），手动改表降级为备用手段；随 21 V1.7 servo/闭环落地。V1.11 = 2026-09-27：**链路泵简化随 `com/link.c` `ae10aac` 同步**——§9.2 事务模型中"寄存器连读两次取相同值"的继承规范废弃，改**单读快照 + 消费端钳位**、失联判定只由 `SF_ALIVE` 500 ms 承担；§9.3 第 4 行"超时判定"改按新口径；主机单测断言数 2855→2873。决策真源 22 号文档 V1.6 §4.2/§5.4 与 21 §16 R9）（V1.10 = 2026-09-26：**UART 作为板间链路弃用**——用户决策，`USE_SPI_LINK` 已定义进 TC275 的 Debug 与 Release 两个 TASKING 构建配置，构建唯一产出的板间链路是 SPI；本号 §1 状态表、§2（改为"仅调试控制台 + 双侧刷机才恢复的应急返修"）、§9.2 进度注、§9.3 第 6 行、§9.1 R7 退路口径同步，决策真源见 21 §5.6 末条与 21 §18 **C15**）（V1.9 是 2026-09-26：**新增 §9.3「板间连线全程杜邦线直连、无任何外部元件」**——用户确认两板之间无外部上拉/下拉/端接电阻、无电平转换，据此更正 §9.1 的 IRQ 上拉条目（原"需 10 kΩ 上拉，待确认"→ 唯一上拉是 TC275 片内，C6 侧显式 `GPIO_PULLUP_DISABLE`），并给出七条 coding 后果（判活只看 `SF_ALIVE`、0xFF 不等于从机在位、提速只能靠时钟档位等）；V1.8 是**目录重排**——`Bsp/encoder.c`→`rt/encoder.c`、`Middleware/{com,sf}/`→`com/`、`mw/sf/`（SDD §3.4/V1.3），**TC275 IDE 构建链接闭合达成**（Debug 0 错误）；V1.7 是**编码器固件已实现**——`rt/encoder.c`（当时位于 `Bsp/encoder.c`）GTM TIM0 八通道 TIEM 双边沿中断 + 软件 ×4 正交（§8.3 有 UDC 不可用的重要纠错），P33.0~7 待接线后按 §8.4 台架判向；V1.6 是 **C6 已烧录 SPI 固件后，TC275 侧按契约完善并回写**——握手寄存器补 `SF_GEN(24)` 与"主机只读 24 B 前缀"口径、`FLAGS` 更正为 `FRAG/FRAG_END`（ACK 不是 flag）、遥测定为**固定 38 B 且短帧=整帧丢弃**、两侧常量核对结论改记三处不一致（22 号文档 E13/E14）；V1.5 已落地 TC275 侧 SPI 链路代码（现位于 `com/`、`mw/sf/`），P23.0 握手改为**电平轮询**（P23.x 无法产生边沿中断，见 22 号文档 E11），构建默认仍是 UART、SPI 用 `-D USE_SPI_LINK` 开启；V1.4 已按 §9.1 完成 SPI 实物接线；V1.3 已把 §9 定为主链路、§2 UART 降级为调试控制台/回退链路；驱动板为轮趣 D24A 四路稳压模块，按原理图 REV1.0 核对）

配套文档：11-requirements.md（产品需求 V1.2）、[21-software-design.md](../20-design/21-software-design.md)（量产 SDD V1.8，**设计基准**）、[22-link-spi-design.md](../20-design/22-link-spi-design.md)（SPI 链路详细设计，V1.6）

ESP32-C6 固件工程：**自研** `C:\Code\TC275\AURIX-v1.10.36-workspace\esp32c6_car`（ESP-IDF）；`esp-at` 工程仅作 UART **应急返修**参考（UART 作为板间链路已弃用，见 §2）

ESP32-C6 硬件板卡：**ESP32-C6-DevKitC-1 V1.2**（ESP32-C6-WROOM-1/-1U 模组，8 MB flash，板载 5V→3.3V LDO、USB-UART 桥 + 原生 USB 双 Type-C 口、BOOT/RST 按键、GPIO8 地址彩灯）

参考资料：[ESP32-C6-DevKitC-1 v1.2 User Guide](https://docs.espressif.com/projects/esp-dev-kits/en/latest/esp32c6/esp32-c6-devkitc-1/user_guide.html)

---

## 1. 系统总接线图

**接线状态一览（2026-09-26）**

| 通道 | 见 | 实物状态 |
|---|---|---|
| **板间主链路 SPI**（QSPI3 主 ↔ C6 SPI2 从 + IRQ，5 线 + 共地） | §9.1 | ✅ **已按 §9.1 完成接线**。**两侧固件均已实现**：C6 侧 = `esp32c6_car` `22e15f2`（`spi_slave_hd` 从机，已提交）；TC275 侧 = `com/` + `mw/sf/`，**且 `USE_SPI_LINK` 已定义进 Debug 与 Release 两个 TASKING 构建配置（2026-09-26 UART 板间链路弃用，SDD §5.6/§18 C15），SPI 是日常构建唯一产出的板间链路**。**IDE 构建链接闭合已达成（2026-09-26，Debug 0 错误）**。下一步：G1 波形门禁 |
| 板间 UART（ASCLIN1 ↔ GPIO6/7） | §2 | ✅ 已接，**线不拆**。**2026-09-26 起该通道作为板间链路已弃用**（SDD §5.6 末条 / §18 C15）：现在只承担 **C6 调试控制台**；G1 失败时的应急返修要同时做两件事——TC275 删除 `USE_SPI_LINK` 重编 + C6 重刷 esp-at |
| 电机 PWM/方向 8 线 + STBY | §3 / §4 | ✅ 8 线已接，实车验证。**STBY 于 2026-10-04 由"跳 J4-1 常使能"改为 TC275 GPIO 受控（P22.2 / X1-16 → J4-2）**：🔌 **待改线**——拔跳线帽 + 接一根线，且**新固件与改线必须同批**（只刷固件不改线 = 驱动永不使能，四轮不动）|
| 编码器 8 线（P33.0~7 / X2-28~35） | §8.2 | 🔌 **固件已实现**（`rt/encoder.c`，GTM TIM0 TIEM ×4 软件正交，优先级 16~23）；待按本表接线 + §8.4 台架判向 |
| 六轴 IMU LSM6DSV16BX（QSPI1 + INT1/INT2，X1 侧） | §10 | ✅ **已接线，首验 ① 通过（2026-10-03 台架实测）**：上电 `IMU ready (WHOAMI=0x71, ...)`，静置六轴模 995 mg、`err`=0。驱动 [35-imu-driver.md](../30-tc275/35-imu-driver.md) V1.3（QSPI1 P11.6/11.9/11.3 + SLSO3 P11.10、INT1 P15.4 ERU 计数/INT2 P15.5 可选未配、VEXT 供电、失联 1 Hz 重探免重启自愈）。**未结三项**见 §10.2 状态：运行中全 0 静默（V1.3 已能判为读失败）、`drdy` 增量 -17%、SCLK 实测 5 µs vs `clk` 字段 1 MHz |
| ToF VL53L5CX 8×8 多区测距（I2C0 + INT，mikroBUS 插座） | §11 | 🔌 **方案定稿（2026-10-03 用户确认：INT=P10.7 / LPn 方案 A 不占 MCU 脚），尚未接线、固件未动**。脚位已锁进真源：SCL **P13.1**、SDA **P13.2**（mikroBUS 12/11 号孔）、INT **P10.7**（孔 15，**经核实只能电平轮询——P10.7 与 IMU INT1 共用 ERU 输入通道 0，见 §11.2**）、LPn 47 k 上拉至 3.3 V、供电与 I2C 2.2 k 上拉见 §11.1/§11.3。**明确不做**：本批不解锁 `.cproject` 的 I2c/Port-Io 排除、不引入 ST API、不写 `bsp/tof.c` |
| 电源与共地 | §5 | ✅ 已接 |

> **两板之间的连线形态（coding 前必读，真源见 §9.3）**：SPI 五线 + 调试 UART 两线 + 共地全部是**杜邦线直连，无任何外部元件**（无外部上拉/下拉、无串联端接、无电平转换）。IRQ 的高电平由 **TC275 片内上拉**单独撑起。
> **例外口径（V1.21）**：§11 的 **I2C0 总线不属于"杜邦线无外部元件"体系**——iLLD 把 SCL/SDA 配成**开漏输出**（`IfxI2c.c:220-228`，片内不上拉），VL53L5CX 手册硬性要求 **SDA/SCL 各 2.2 kΩ 上拉**、INT/LPn 各 **47 kΩ 上拉**。"接个杜邦线就能用"在这条总线上不成立，缺上拉的现象是"地址无 ACK / 波形只往下走不上升"，须按 §11.1 装齐电阻再判故障。

```
                        ┌──────────────────────────────────┐
                        │       KIT-AURIX-TC275-LITE       │
  X4 micro-USB ────────►│  供电 + DAS 调试 + 虚拟 COM       │
  (接PC, 一根线三件事)   │  ASCLIN0 P14.0/P14.1 板内互连     │
                        │                                  │
  ESP32-C6-DevKitC-1    │ ══ 主链路 QSPI3 主机（§9.1 已接）══│
  ┌─────────────────┐   │                                  │
  │ GPIO19 SCLK ◄───────│─ P33.11  SCLK   X1-3   主→从      │
  │ GPIO18 MOSI ◄───────│─ P33.12  MTSR   X1-4   主→从      │
  │ GPIO20 MISO ───────►│─ P33.13  MRST   X1-5   从→主      │
  │ GPIO23 CS   ◄───────│─ P23.4   SLSO5  X1-12  主→从      │
  │ GPIO21 IRQ  ───────►│─ P23.0   电平   X1-8   从→主      │
  │  ····· GND ─────────│─ GND     共地（必须！）            │
  │                     │                                  │
  │ 5V ◄── DC-DC 5V≥2A  │  (板载 LDO 出 3.3V, 见 §5)        │
  │ EN/RST 板载已处理    │                                  │
  └─────────────────┘   │  GTM PWM 20kHz    方向 GPIO       │
                        │  P21.0 P21.3      P21.2~5         │
     电池(2S~3S)         │  P00.0 P00.8      P00.x P22.3     │
        │               └──────────┬────────────────────────┘
        ├──► VM(→D24A VIN) ───────►│
        ├──► DC-DC 降压 5V ≥2A ──► 5V(DevKit J1-14) + kit X302
        │                        ┌────────────────────┐
        └──► GND(全系统共地)      │ D24A 四路驱动板     │
                                 │ J4: A=电机A B=电机B│── AO/BO → 同侧两轮电机
                                 │ J6: A=电机C B=电机D│── CO/DO → 另一侧两轮电机
                                 └────────────────────┘   (编码器 E1~E4 见 §8)
```

Mermaid 版（支持的查看器可渲染）：

```mermaid
flowchart LR
    subgraph TC275 [KIT-AURIX-TC275-LITE]
        QSPI[QSPI3 主机<br/>SCLK P33.11 / MTSR P33.12 / MRST P33.13<br/>CS SLSO5 P23.4 + IRQ 电平轮询 P23.0]
        ASC0[ASCLIN0<br/>P14.0 TX / P14.1 RX]
        ASC1[ASCLIN1<br/>P15.0 TX / P15.1 RX]
        PWM[GTM ATOM PWM 20kHz<br/>P21.0 P21.3 P00.0 P00.8]
        DIR[方向 GPIO<br/>P21.x P22.3 P00.x]
        IMUC[QSPI1 主机（IMU）<br/>SCLK P11.6 / MTSR P11.9 / MRST P11.3<br/>CS SLSO3 P11.10 + INT1 P15.4]
        I2C0[I2C0 主机（ToF）<br/>SCL P13.1 / SDA P13.2<br/>+ INT P10.7（电平轮询，§11.2）]
    end
    ESP[ESP32-C6 自研固件<br/>SPI2 从机 HD GPIO19/18/20/23 + IRQ GPIO21<br/>UART1 控制台 GPIO6/7 115200]
    PHONE((手机/PC<br/>Wi-Fi AP))
    DRV[D24A 四路驱动板<br/>J4=电机A/B J6=电机C/D<br/>编码器 E1~E4 见 §8]
    BAT[电池 VM 6.5~12V<br/>DC-DC 5V ≥2A → DevKit J1-14 + kit X302]
    IMU[LSM6DSV16BX 六轴 IMU<br/>3.3V 由 kit VEXT(X1-2) 供电]

    PHONE -- Wi-Fi 2.4G --> ESP
    QSPI -- 主链路 SPI 半双工 已接线 --> ESP
    ESP -- IRQ 就绪 + 共地 --> QSPI
    ASC1 -- 调试控制台 TX→RX / RX→TX --> ESP
    ASC0 --> DBG[X4 micro-USB<br/>供电+DAS+虚拟COM]
    PWM --> DRV
    DIR --> DRV
    BAT --> DRV
    IMUC -- SPI + INT1/INT2 --> IMU
```

> **V1.5 现状标注（V1.10 更新口径）**：`QSPI3 ↔ C6 SPI2`（§9.1 五线 + 共地）**已按接线表完成实物接线**；`ASCLIN1 ↔ GPIO6/7` UART 线**保留不拆**，仅作 C6 调试控制台（作为板间链路已于 2026-09-26 弃用，见 §2 与 SDD §18 C15）。**两侧 SPI 固件代码均已落地**：C6 侧 `esp32c6_car` 已完成 `spi_slave_hd` 从机改造（提交 `22e15f2`，UART 时代的 0x44 波特率协商与 `C6_LINK_TX/RX_GPIO` 已删除）；TC275 侧 `USE_SPI_LINK` **已定义进 Debug 与 Release 两个 TASKING 构建配置**，日常构建唯一产出的板间链路就是 SPI。**通电联调尚未做过**：链路启用与波形兼容性由 G1 门禁把关（见 [22-link-spi-design.md](../20-design/22-link-spi-design.md) §8）。编码器 8 线见 §8（尚未接线，待确认）。

---

## 2. TC275 ↔ ESP32-C6（UART 通道：V1.3 起降级为调试控制台，**V1.10 起作为板间链路弃用**）

> **状态变更（V1.3）**：本节描述的 ASCLIN1 ↔ C6 UART 接线**保留不拆**，用途为 C6 自研固件的 115200 调试控制台。引脚与流控信息仍按 esp-at 时代记录，供返工查阅。
> **状态变更（V1.10，2026-09-26 用户决策）**：UART **不再是板间链路**——`USE_SPI_LINK` 已定义进 TC275 的 Debug 与 Release 两个 TASKING 构建配置，AT/UART 分支只在手动删除该符号时才编译（SDD §5.6 末条、§18 C15）。若 G1 波形门禁失败需要临时恢复这条通道，动作是**双侧**的：TC275 删符号重编烧录 + C6 重刷 `esp-at` 镜像（`AT+UART_CUR=115200,8,1,0,0` 关流控），按一次刷机的代价排计划，不是改一行 `#ifdef`。
>
> **已消除的不一致（V1.5 核对）**：`esp32c6_car/components/c6_link/Kconfig` 原 `C6_LINK_TX_GPIO default 10` / `C6_LINK_RX_GPIO default 11` 与本节记录的 **GPIO6(RX)/GPIO7(TX)** 冲突。C6 侧 SPI 改造（提交 `22e15f2`）时**已删除**这两项，改为显式的 `C6_LINK_DEBUG_UART_RX_GPIO default 6` / `C6_LINK_DEBUG_UART_TX_GPIO default 7`，与本节和实物接线一致。UART 通道现在只剩调试控制台用途。

ESP32-C6 esp-at 固件的 AT 通道是 **UART1**（不是 ESP8266 的 UART0），默认引脚如下（来自 esp-at `docs/en/Get_Started/Hardware_connection.rst` ESP32-C6 章节）。DevKitC-1 排针位置见官方 User Guide 引脚图（引脚号以板端丝印为准）：

| TC275 (LITE kit) | 方向 | ESP32-C6 (esp-at) | DevKitC-1 位置 | 说明 |
|---|---|---|---|---|
| P15.0（ASCLIN1 TX） | → | GPIO6（UART1 RX） | J1-5 | 交叉连接 |
| P15.1（ASCLIN1 RX，保持上拉） | ← | GPIO7（UART1 TX） | J1-6 | 交叉连接 |
| GND | — | GND | J1-15 | **必须共地** |
| — | — | 5V 供电 | J1-14（5V） | 车载 DC-DC 5V（与 kit 共用 ≥2A 轨），见 §5 |

> AT 串口用 ASCLIN1：TX=**P15.0**、RX=**P15.1**（iLLD 符号 `IfxAsclin1_TX_P15_0_OUT` / `IfxAsclin1_RXA_P15_1_IN`）。物理位置在板载 **mikroBUS 插座：pin13=TX(P15.0)、pin14=RX(P15.1)**（官方手册 Figure 5，二者不在 X1/X2 上）。曾在 V1.1 尝试改用 P11.12/P11.10（X1-32/34），联调无 RX 响应，已改回 P15.0/P15.1。注意 X1 上印着 `RXD1/TXD0` 的 P11.9/P11.3 是片上以太网 MII 信号，**不是**串口，勿混用；P11.10 还是 Shield2Go 2 的 CS 复用位，插 S2G 板时会冲突。

> J1-1 的 3V3 是板载 LDO 的**输出**脚：采用 5V 供电方案时请勿再从外部向 3V3 灌电。

烧录 / 日志：**无需外接 USB-UART 线**。DevKitC-1 V1.2 板载两个 Type-C 口：

| 接口 | 内部连接 | 用途 |
|---|---|---|
| USB-to-UART 桥口 | 桥接芯片 → UART0（GPIO16/17），支持自动下载 | 烧录（`idf.py flash` / esptool）、esp-at 日志 |
| ESP32-C6 USB 口 | 原生 USB（D+=GPIO13、D-=GPIO12，经 J3） | USB-Serial-JTAG 烧录/控制台 |

手动进下载模式：按住 BOOT（GPIO9）→ 点按 RST → 松开 BOOT。正常运行时 GPIO9/GPIO8 保持板载状态即可。

板载资源速查（避免误用）：

| 板载器件 | 占用引脚 | 本项目注意事项 |
|---|---|---|
| BOOT 按键 | GPIO9（strapping） | 不接外部电路；上电为低会进下载模式 |
| 地址彩灯 | GPIO8（strapping） | 已占用，勿作普通 IO、勿外接下拉 |
| RST 按键 / RST 脚 | EN（J1-2） | 可选：后续由 TC275 GPIO 引出做硬件复位/急停扩展 |
| J5 电流测量跳线 | 3V3 供电路径 | 用板载 LDO 给模组供电时保持短接 |
| USB 选择 J3 | GPIO12/13 | 使用原生 USB 口时保持默认连接 |

---

## 3. TC275 ↔ D24A 控制接线（J4 = 电机 A/B，同侧两轮；代码 motor.c）

驱动板为轮趣 **D24A**（双 TB6612 四通道 + 板载稳压，原理图 REV1.0 2023-03-21）：逻辑供电**板载自产**（VIN→5V/3V3，无需外接 VCC）；控制排针 **J4**（电机 A/B + STBY + 3V3 + 编码器 E1/E2）、**J6**（电机 C/D + 编码器 E3/E4 + ADC 电池分压）。

| D24A 信号 | J4 脚 | TC275 引脚 | X1 脚位 | 功能 |
|---|---|---|---|---|
| PWMA | J4-4 | P21.0 | X1-15 | 电机A PWM，20 kHz（ATOM2_4/TOUT51）|
| AIN1 | J4-8 | P21.4 | X1-19 | 电机A 方向 1 |
| AIN2 | J4-6 | P21.5 | X1-22 | 电机A 方向 2 |
| PWMB | J4-3 | P21.3 | X1-20 | 电机B PWM，20 kHz（ATOM4_1/TOUT54）|
| BIN1 | J4-7 | P21.2 | X1-17 | 电机B 方向 1 |
| BIN2 | J4-5 | P22.3 | X1-18 | 电机B 方向 2 |
| STBY | J4-2 | **P22.2** | **X1-16** | 总使能，高有效；**一片 GPIO 管四个电机**（两片 TB6612 的 STBY 在板内是同一网络，J6 无独立 STBY 脚）。V1.23 起由 GPIO 受控，**原 J4-1↔J4-2 跳线帽必须拔掉** |
| 3V3 | J4-1 | —（本地）| — | 编码器参考电平/逻辑，勿外部灌电；STBY 曾跳此处，现不跳 |

电机 A/B 线圈接 D24A 对应电机座的 AO1/AO2、BO1/BO2。

> **X1 丝印复用说明（已核对，无冲突）**：X1-17（MDC）、X1-18（SCLK）、X1-20（MDIO）丝印是 TC275 **片上以太网 ESC** 的 MII 复用位置，板上**无外部驱动电路**，作电机线安全（实车已验证）。

### 3.1 D24A 驱动板原理图详解（REV1.0，立创 EDA，2023-03-21）

> 本节把驱动板原理图（TB6612 带稳压 4 路驱动，REV1.0）的**板内电路**登记为真源，供选电池/排查供电/理解"逻辑板载自产"这些接线前提。§3/§4 的排针脚位表仍是对外接线真源；本节只补板内部分。**板与板之间仍是杜邦线直连、无外部元件（见 §9.3）——本节描述的元件全在 D24A 板内。**

**板内功能框（按原理图分区）：**

| 分区 | 关键器件 | 功能 | 关键点 |
|---|---|---|---|
| 12V 电源输入 | 连接器 `VIN_SW`（VIN/SW）+ KEY 轻触开关 `KEY1`(K2-3.6×6.1) + 220 µF/25 V 输入电容 | 电池经拨/按开关引入 VIN | **VIN 是唯一动力入口**；开关切 `VIN_SW→VIN`，关机即断动力 |
| 5V 电源 | **TB6288GSP** 同步降压（U1）+ 电感 6.8 µH + 输入 22 µF×2 / 输出 22 µF + FB1/FB 反馈分压 + SS54 肖特基 D3 | VIN→5V，给 TB6612 的 VM/逻辑上游与 LDO 供电 | 板载自产 5V，**无需外接 5V 给驱动板逻辑** |
| 5V→3.3V | **RT9013-33GB** LDO（U4，33=3.3 V 版）+ 1 µF 输入/输出 + LED1(0603) 电源指示 | 5V→3V3，供逻辑/编码器参考电平 | 编码器 VCC 参考即此 3V3（§8.1，**禁改 5V**）；LED1 亮=3V3 正常 |
| 过温保护 | `P_EN` 使能网络 + 6.8 kΩ NTC(R3) + 100 nF + R5(0 Ω) | 温升拉低 `P_EN` 关断输出 | 原理图注 **"过温保护"**；正常上电 `P_EN` 拉高使能 |
| 过流/使能 | `IP_EN`/`I_EN` 使能网络 + 10 kΩ 采样 + 3.3 kΩ | 电流异常参与使能门控 | 与 `P_EN` 共同决定输出级是否使能 |
| 电机驱动 | **TB6612FNG ×2**（U8=电机A/B，U2=电机C/D），每片 VM/VCC + 0.1 µF×3 + 220 µF/25 V VM 储能 | 双 H 桥 ×2 = 4 路电机 | **VCC 接板载 5V** ⇒ `VIH(STB)=VCC×0.7=3.5V`；**全部控制输入（含 STBY）内部 200 kΩ 下拉**（浮空=低=关断）。STBY 是**两片共用的一根网络**，只从 J4-2 引出，板内**无上下拉、无跳线帽座**——使能方式见 §3/§3.2 |
| 逻辑排针 | `J7`(HDR 2×6)、`J8`(HDR 2×6)：3V3/PWM×/xIN×/STBY/ADC/GND | 引出全部控制信号（即 §3/§4 的 J4/J6 对外脚） | 3V3/GND 也在这两排引出 |
| 5V/3V3 输出 | `J5`(HDR 1×4)：3V3×3 + GND；另一组 5V/3V3/GND 引出 | 给外部逻辑（如编码器上拉参考）取电 | **只取逻辑电，动力一律走 VIN** |
| 电机座 | `Motor_A~D`（HDR-F 2.54 1×6 各一）：xOUT1/xOUT2 + E?A/E?B + 5V/GND | 每座 = 一路电机线圈 + 该电机编码器 | 编码器 A/B 相从这里引到 §8.2 的 X2 脚 |

**从原理图能确认、且对使用有影响的三条事实：**
1. **逻辑电全板载自产**：VIN→(TB6288GSP)→5V→(RT9013-33)→3V3。所以接线时**不要**从 TC275 kit 或外部给 D24A 灌 5V/3V3 逻辑电（呼应 §5.2 的"不再从 kit 取"）。
2. **编码器参考电平就是这块 RT9013 的 3V3**：实测 E1A 静态 3.3V 可直连 TC275（§8.1）；若把电机座的编码器 VCC 误接到 5V，摆幅抬到 5V 会超 TC275 IO 耐压。
3. **动力与逻辑同源不同轨**：VIN 直供两片 TB6612 的 VM（带 220 µF 储能），逻辑经两级稳压——电机堵转/换向的大电流走 VM 粗线，不经过 3V3，符合 §5 的"电机功率一律走 D24A VIN"。

> 原理图图元清单（便于对照实物丝印）：U1=TB6288GSP(5V 降压)、U4=RT9013-33GB(3V3 LDO)、U8/U2=TB6612FNG(电机驱动)、D3=SS54(肖特基)、KEY1=电源开关、J7/J8=控制排针(即对外 J4/J6)、J5=5V/3V3 输出、Motor_A~D=电机+编码器座；REV 1.0 / Sheet 1/1 / 2023-03-21。

### 3.2 STBY 受控化（V1.23，2026-10-04）：选脚依据与三条电气事实

**改线动作（与刷固件必须同批）**：① 拔掉 **J4-1↔J4-2 的跳线帽**；② 加一根杜邦线 **TC275 X1-16（P22.2）→ D24A J4-2**；③ 刷入含 `MOTOR_setEnabled` 的固件。**只刷固件不改线 ⇒ STBY 仍由跳线帽常拉高，GPIO 形同虚设（无害但受控性没生效）；只改线不刷固件 ⇒ 没人拉高 STBY，四轮不动。** 断电操作。

**选 P22.2（X1-16，丝印 `SS`）的判据**（kit 手册 V1.1 Figure 4 X1 全表逐脚比对）：① 全仓 `bsp/ rt/ com/ mw/` 无引用，与电机/SPI/编码器/IMU/ToF 五组线束零交集；② 无板载负载（同口的 P00.5=LED1、P00.7=Button1、P00.0=CAN TXD 都带东西，已避开）；③ 非 boot/reset/调试脚（避开 X1-30 PORST_N、X1-26/27 ESR、P14.3(HWCFG/R31)、P10.5/6、P21.7(/TRST，DAP 6 号脚)）；④ **不与 S2G/mikroBUS/Arduino 共享**（手册第 10~11 页三张扩展表里 P22 一颗都没出现，而 P20.0/P20.3/P20.9/P20.10/P32.2/P32.3/P11.2 那些"看着空闲其实共享"的脚全被排除）；⑤ X1-16 正夹在 X1-15(PWMA) 与 X1-17(BIN1) 之间，可与 6 根电机线走同一把排线。备选（同样干净）：P22.0=X1-14、P22.1=X1-13、P23.1=X1-7、P23.2/3/5=X1-10/9/11。

**① 内部 200 kΩ 下拉 ⇒ "没有固件"天然等于"驱动未解锁"，无需外部电阻。** TB6612FNG 手册引脚表写明 AIN1/AIN2/PWMA/BIN1/BIN2/PWMB/**STBY** 每颗控制输入**内部都有 200 kΩ 下拉**。所以：MCU 复位/锁死/未烧录 → GPIO 高阻 → STBY 被片内拉到 0 → standby，输出关断；即使 STBY 为高，浮空的 IN 脚也各自被 200 k 拉低，真值表 `L L / PWM=L / STBY=H` = **OFF（高阻）**。这条**回答了 21 §7.1 挂着的"复位期间 TB6612 输入行为未逐项核实"**：纸面答案是"滑行，不会乱转"，实测仍按 21 §7.2 记入验证日志。§9.3 的"板间杜邦线无外部元件"口径**因此不用破**。

**② 3.3 V 驱动在手册判据下不达标，但这不是本次改动新引入的缺陷。** 电气特性表：`VIH(STB) = VCC × 0.7`、`VIL(STB) = VCC × 0.3`，而 D24A 把两片 TB6612 的 VCC 接在板载 **5 V**（§3.1 原理图 U8/U2 的 VCC 网络标 `5V`）⇒ **保证门限 3.5 V**。板载 3V3（RT9013-33，≈3.23~3.37 V）**在其之下**——原来跳 J4-1 的接法同样在之下，且实车验证可用（阈值是设计保证值，实测翻转点通常更低）。换成 GPIO 是**同级裕量、零新增元件**。输入电流不是问题：`IIH(STB) @ VIN=3V = 5/15/25 µA`（≈3 V ÷ 200 k，与内部下拉自洽）。**要真正 spec-clean 只能把 STBY 抬到板载 5 V**（PMOS 高边 + 栅极电阻，2 个元件，会破 §9.3 口径）——本批不做，登记为备选。

**③ 与 21 号"安全态"定义有冲突，本批只走无争议的一半。** 21 号术语表定义安全态 = "**STBY 拉低** + PWM 0% + 方向脚释放（电机电气隔离）"，§5.2 还要求"任何 `ERR_STALL/ERR_BATT_CRIT/急停/看门狗复位路径` 直接拉低"。但当前实现的急停是 `rt/motor_algo.c:MOTOR_ALGO_brakeAll()` = IN1=IN2=H 的**短接刹车**；**STBY 一拉低，短接刹车就退化成高阻滑行，急停刹车距离会变长**。所以本批 `MOTOR_setEnabled()` 只用于"上电使能 + 未跑固件即断电"这一条，**急停/故障路径不碰 STBY**；是否按 21 号叠加（并相应接受滑行换电气隔离）属安全语义决策，待用户放行后与 `motor_guard` 同批做（21 §17 未做项）。

**固件落点**：`bsp/motor.c` 的 `MOTOR_STBY_PORT/PIN` + `MOTOR_setEnabled(boolean)`（拉低前先 `MOTOR_stopAll()`）；`MOTOR_init()` 在 8 根 IN/PWM 全部置低、duty=0 之后**最后一步**拉高。属主 **CPU1**（`Cpu1_Main.c` 调 `MOTOR_init()`）。

## 4. TC275 ↔ D24A 控制接线（J6 = 电机 C/D，另一侧两轮）

| D24A 信号 | J6 脚 | TC275 引脚 | X2 脚位 | 功能 |
|---|---|---|---|---|
| PWMC | J6-4 | P00.0 | X2-3 | 电机C PWM，20 kHz（ATOM1_0/TOUT9）|
| CIN1 | J6-8 | P00.2 | X2-5 | 电机C 方向 1 |
| CIN2 | J6-6 | P00.6 | X2-7 | 电机C 方向 2（兼驱动板载 **LED2**）|
| PWMD | J6-3 | P00.8 | X2-9 | 电机D PWM，20 kHz（ATOM0_7/TOUT17）|
| DIN1 | J6-7 | P00.10 | X2-11 | 电机D 方向 1 |
| DIN2 | J6-5 | P00.12 | X2-13 | 电机D 方向 2 |
| ADC | J6-1 | 专用模拟脚 **AN4**（VADC G0 CH4） | **X2-23** | 电池电压分压输出（R13 10 k 串 + R15 1 k 对地 = **VIN/11**，§3.1 板内 5V 电源区），**已接**（V1.13）：固件 `bsp/adc.c` 100 Hz 采样 + EMA，详见 §5.3 |

> **⚠ P00.0 双重身份（本次核对新发现）**：X2-3 丝印 `TXDCAN`——P00.0 同时接在板载 CAN 收发器 TLE9251 的 TXD 输入上。它现在是电机 C 的 PWM 输出：电气上是"输出→输入"并联，**不影响电机运行**，但板载 CAN 连接器会随 PWM 发出随机帧——**运行期间不要将外部 CAN 总线/设备接入板载 CAN 口**（也解释了为何该脚未被 iLLD ETH/CAN 示例占用）。X2-4（RXDCAN，收发器输出）未被工程使用，勿作普通输入用。
>
> **P00.6 兼 LED2**：电机 C 方向 2 翻转时板载 LED2 会亮/灭，属预期现象（输出同时驱动板载 LED 与 J6-6），无需处理。

> 电机 B、C 在软件中做了方向翻转（motor.c `g_dirInvert`），接线按本表即可，无需交换电机线。

## 5. 电源与接地

### 5.1 整车供电架构

```
电池(2S~3S, D24A VIN 建议 6.5~12V)
 ├──► D24A VIN（电机电源，粗线；逻辑 5V/3V3 由 D24A 板载稳压自产）
 ├──► DC-DC 降压 5V ≥2A ──┬──► TC275 LITE kit  X302(+5V)（见 §5.2）
 │                        └──► ESP32-C6-DevKitC-1 J1-14(5V)
 │                              └─ 板载 5V→3.3V LDO 给模组供电（J5 跳线保持短接）
 └──► GND（全系统共地）
```

### 5.2 TC275 LITE kit 供电详解（依据官方 User Manual V1.1 §2.1）

板载电源结构：输入 5V → **LDO G1** 产生 3.3V（板上称 **VEXT**，最大输出 1A）；绿色电源指示灯 **D5** 亮表示 3.3V 正常。另有一路 **VDD_USB**（X4 的 VBUS）。

官方提供 4 种供电方式，**同一时刻只允许一种**：

| 方式 | 入口 | 说明 |
|---|---|---|
| ① USB（桌面推荐） | **X4 micro-AB USB** 接 PC | 同时完成供电 + DAS 调试 + ASCLIN0 虚拟串口；USB2.0 口最多 500 mA，建议用 USB3.0 口（900 mA）或带高电流供电能力的外部 USB 电源 |
| ② 车载 5V（本项目采用） | **X302 Arduino 电源排针的 +5V 脚** | 来自 DC-DC 5V ≥2A（与 C6 共用一路） |
| ③ 车载 5V（备用入口） | **X1-39 或 X2-2 的 VDD_USB 脚** | 与 ② 等效 |
| ④ 外部 3.3V 直灌（特殊场景） | **X1-2 / X2-39 的 VEXT 脚** 或 X302 +3V3 脚 | 必须先**拆掉电阻 R27**（0Ω，0805）；副作用：**CAN 收发器失效**（TLE9251 需要 5V）。本项目不用 |

硬性警告（手册原文要点）：

- **X4 插着 USB 时，禁止**再从 ②③④ 任何电源脚输入电压——板上**没有反向电流保护**，会倒灌损坏 USB 主机/PC；反过来用车载 5V 上电时，也不要再把 X4 接到 PC（调试时拔掉 X4 或只保证二者不同时带电，DAS 调试需 X4 时须先断开车载 5V 的判断交给使用者，官方明确要求“ensure X4 is not supplied by any power source or PC”用于方式②③④）。
- 禁止多个电源脚同时施加电源，否则可能烧毁板子。
- **VEXT 就是 LDO G1 的输出轨**：向其灌电压会直接损坏 LDO（方式④拆 R27 是唯一合法例外）。
- 板卡逻辑电平为 **3.3V，不兼容 5V 电平外设**（官方手册 §3.3 明确）。

电流预算（LDO G1 上限 1A）：

| 负载 | 典型电流 |
|---|---|
| TC275 + FT2232（板载） | ~200–300 mA |
| ~~TB6612 逻辑 VCC~~ | D24A 板载稳压自供，**不再从 kit 取**（历史方案，仅当外接裸 TB6612 模块时才需 X1-2 VEXT 供逻辑） |
| 六轴 IMU LSM6DSV16BX | <5 mA（§10） |
| ToF VL53L5CX 连续 8×8（§11，方案定稿待接线） | 典型 **95 mA**（AVDD 45 + IOVDD 50；峰值各轨再 +10 mA，手册 max ≈130 mA） |
| 余量给扩展（编码器上拉参考等） | ~600 mA（扣去 ToF 典型值后） |

> 结论：**电机功率一律走 D24A VIN**，绝不允许从 kit 3.3V 轨取；ESP32-C6 **不要**从 kit 取电（它自己 5V→板载 LDO 独立供电），避免把 C6 的开关噪声和 1A 预算冲突压到 LDO G1 上。

### 5.3 ESP32-C6-DevKitC-1 供电要点

- 推荐从车载 DC-DC 的 **5V** 接入 J1-14（单板最低 ≥1A；与 TC275 kit 共用一路时整轨 ≥2A，见 §5.1），由板载 LDO 产生 3.3V 供模组；Wi-Fi 发射瞬时电流峰值 ~350–500 mA，5V 轨裕量不足会导致 Brownout 复位。
- 5V 入水口旁加 **≥470 µF 大电容 + 0.1 µF**；远离电机驱动走线，星型接地，避免电机电流纹波耦合。
- 也可用独立 3.3V ≥1A LDO 接 J1-1(3V3)，但此时须断开板载 LDO 供电路径（拔 J5 跳线），二选一，**禁止两路 3.3V 并联通电**。
- 调试阶段可临时用 PC USB 给 DevKitC-1 供电，但电机全速运行时 USB 供电电流不足，必须切换为车载 5V。

### 5.4 接地与上电顺序

```
全系统共地：电池负极 = D24A GND = kit X1-40/X2-40(GND) = DevKitC-1 GND(J1-15)
上电顺序：先整车 DC-DC 5V（逻辑上电）→ 电池 VIN（动力）；断电顺序相反。
电机线、编码器线(接线见 §8)远离 C6 天线端（WROOM-1 板载天线在 J1 对侧），减少扰动。
```

### 5.5 电池电压采集（D24A J6-1 → kit X2-23/AN4，**V1.13 已接**）

| 项 | 值 | 依据/说明 |
|---|---|---|
| 信号链 | D24A VIN →(R13 10 k 串)→ **J6-1 "ADC"** →(R15 1 k 对地)→ kit **X2-23** | 分压比 = **VIN/11**（§3.1 板内 5V 电源区原理图；VIN 2S~3S = 6.5~12.6 V → 引脚 0.59~1.15 V） |
| TC275 侧 | **X2-23 = AN4 = VADC G0 CH4**（kit 手册 Figure 4） | X2-16~27 整列是空闲模拟脚（X2-15=VAREF1 基准勿占、X2-27=AN0 板载电位器）；AN4 为纯模拟垫，无数字复用冲突；与编码器线束同在 X2，走线最短 |
| 地 | 与 J6 的 GND 同排（共地已由 §5.4 覆盖） | 无需额外地线 |
| 基准 | **VAREF1 = X2-15**，本 kit 模拟轨 = VEXT 3.3 V | 固件换算常数 `ADC_BATT_VAREF_MV=3300`（`bsp/adc.h`）——**台架先用万用表量 X2-15 核对一次**；若模拟轨改 5 V，须同批改该常数与 `LOSUP`（`supplyVoltage`） |
| 固件 | `bsp/adc.c`（CPU1 属主）：iLLD 询问式单发转换（12 bit、采样 1 µs，足够 909 Ω 源阻）、100 Hz、1/16 EMA，经 xcore 出 `batteryMv`；`batteryPct` 按 `ADC_BATT_CELLS=3` 估算（**2S/3S 确认后改**，SDD §16 Q1 配置化待做） | `.cproject` 已解除 `Vadc/{,Std,Adc}` 排除（与当年 Qspi/Dma 同款动作） |
| 验收 | 遥测 `batteryMv` ≈ 万用表读的电池电压 ×1000，误差 <2% | 台架动作：量 J6-1 应 ≈ VIN/11，量 X2-15 应 ≈3300 mV |

## 6. 调试串口（TC275 侧，免外接 USB-UART）

kit 板载 **FT2232HL**，X4 micro-USB 一根线三件事：供电（桌面）、DAS 下载调试、**虚拟 COM 口**。

| PC 侧 | 内部连接 | 说明 |
|---|---|---|
| 虚拟 COM 口 TX/RX | FT2232 ⇄ **P14.0 / P14.1（ASCLIN0）** | 115200 8N1，本工程日志/回显通道 |

> P14.0/P14.1 **没有**引到任何外接排针（X1/X2/mikroBUS/Shield2Go/Arduino 均无），想脱离 X4 用外接 USB-UART 接 ASCLIN0 是做不到的；改用其他 ASCLIN 或走板载 DAP 10 针调试口另议。

## 7. 与原 ESP8266 方案的差异摘要

| 项 | ESP8266（旧） | ESP32-C6 esp-at（新） |
|---|---|---|
| AT 串口 | UART0（TX=GPIO1/RX=GPIO3） | **UART1（TX=GPIO7/RX=GPIO6）** |
| 下载/烧录 | UART0 复用，需外接 USB-UART | 板载双 Type-C（USB-UART 桥 + 原生 USB），免外接 |
| 波特率 | 115200 | 115200（不变） |
| AT 指令集 | 原生 | 兼容（CWMODE/CWSAP/CIPMUX/CIPSERVER/CIPSEND/+IPD/CIPCLOSE 均可用） |
| 流控 | 无 | 默认 RTS 使能，需按 §2 关闭或接线 |
| 供电 | 3.3V ≥500mA | DevKitC-1 车载 5V（板载 LDO），与 kit 共用 ≥2A 轨，见 §5 |
| 特有功能 | — | BLE 5 / 802.15.4 / Wi-Fi 6 TWT，为 V2.0 后扩展留余地 |
| TC275 侧引脚 | P15.0/P15.1（旧） | P15.0（TX）/ P15.1（RX），不变（V1.1 曾迁到 P11.12/P11.10 后又改回） |

## 8. 编码器接线（MG310 ×4，V1.1 闭环测速方案 —— 固件已实现，待接线 + 台架判向）

### 8.1 信号源

四个 **轮趣 MG310** 减速电机内置 **13 PPR 霍尔 AB 正交编码器**（×4 解码 = 52 计数/电机转），减速比 **1:20.409**；电机额定 7.4 V（推荐 7–13 V），空载转速 500 ±13% rpm、额定 400 rpm，额定转矩 0.4 kgf·cm、堵转 1.5 kgf·cm。编码器为开漏输出、内部上拉到编码器自身 VCC；当前 VCC 取自板上 3V3 轨，实测 E1A 静态电平 **3.3V**，可直连 TC275，无需分压电阻。

> ⚠️ 约束：编码器供电（D24A 电机 6pin 座的 5/6 脚）**不得改接 5V**，否则编码器输出摆幅抬到 5V，超出 TC275 IO 耐压（见 §5.2 板卡逻辑 3.3V 的警告）。

刻度换算：轮轴每转脉冲 13 × 20.409 ≈ **265.3**，×4 正交解码 ≈ **1061.27 计数/轮转**（48 mm 橡胶胎周长 150.8 mm → **0.1421 mm/计数**）；额定轮速 19.6 rpm ≈ 49.3 mm/s、空载轮速 24.5 rpm ≈ 61.6 mm/s。电机空载 500 rpm 时每编码器 ≈ 433 边沿/s，四路合计 ≈ 1.7k 中断/s（13 V 推荐上限 ≈880 rpm 时 ≈3k/s）。**解码方案**：GTM TIM0 八通道 TIEM（输入事件模式）双边沿中断 + 软件正交 ×4 解码（硬件计数边沿、软件判向）——**不能**用本芯片 GTM 做 "UDC 硬件正交"，原因见 §8.3。换算式（×4 解码下）：`轮轴rpm ≈ Δ计数/ms × 56.5`。

### 8.2 TC275 ↔ 编码器（GTM0 TIM 组 0，A 相进偶数通道 / B 相进奇数通道，全部落在 X2 连续 8 脚）

D24A 板编码器引出（原理图已核对）：**J4**（电机 1/2）= E1A:J4-10、E1B:J4-12、E2A:J4-9、E2B:J4-11；**J6**（电机 3/4）= E3A:J6-10、E3B:J6-12、E4A:J6-9、E4B:J6-11。编码器 VCC 参考 = J4-1 的板载 3V3（禁 5V，见 §8.1）。

| 电机 | 信号 | TC275 引脚 | X2 脚位 | GTM 通道（TIEM 中断）|
|---|---|---|---|---|
| 1（A）| E1A | P33.4 | X2-32 | TIM0_0（A 相，边沿中断）/ TIM0_1（B 相）|
| 1（A）| E1B | P33.5 | X2-33 | ↑ |
| 2（B）| E2A | P33.6 | X2-34 | TIM0_2 / TIM0_3 |
| 2（B）| E2B | P33.7 | X2-35 | ↑ |
| 3（C）| E3A | P33.0 | X2-28 | TIM0_4 / TIM0_5 |
| 3（C）| E3B | P33.1 | X2-29 | ↑ |
| 4（D）| E4A | P33.2 | X2-30 | TIM0_6 / TIM0_7 |
| 4（D）| E4B | P33.3 | X2-31 | ↑ |

依据：iLLD `IfxGtm_PinMap.h` 的 `IfxGtm_TIM0_{0..7}_TIN{22..29}_P33_{0..7}_IN` 符号；X2-27 为板载电位器 AN0、X2-36~38 为 P33.8/9/10（Shield2Go 共享），28~35 恰好完整空闲。共地按 §5.4。

配对规则：偶数通道接 A 相、奇数通道接 B 相，四对同属 GTM0 TIM 组 0。八通道统一配置 **TIEM 输入事件模式 + 双边沿**（`CTRL.TIM_MODE=TIEM, DSL=0, ISL=1`，与 iLLD `IfxGtm_Tim_In` 驱动的 both-edge 配置一致），各通道 NEWVAL 中断优先级 **16~23**、`TOS=CPU1`，`IFX_INTERRUPT(fn, 0, prio)` 声明在 0 号向量表（SDD §18 C1）；2 µs 去毛刺滤波（开漏上拉边沿较缓）。ISR 内读本相 + 对相电平做 ×4 正交解码（对相电平直接读 P33 IN 寄存器，与 TIM 路由互不影响）。

### 8.3 方案选型依据（为何不用 GPT12、也不用 "TIM UDC"）

`21-software-design.md` 早期设想 GPT12 增量编码块 ×4，但本工程只经 X1/X2 排针取信号，实测 pinmap：GPT12 各块增量口的 INA/INB 落在 **P02.x / P10.x / P20.x**（T3INA=P02.6、T4INA=P02.8、T5INB=P10.3、T6INB=P10.2），LITE kit 未引出这几组口；T5INA=P21.7 与 /TRST 复用；T2 虽有 P00.7/P33.7 引脚但 T2 不支持增量接口模式。ERU 边沿中断同样不可用：TC275 **有** ERU（iLLD `IfxScuEru.c`），但其输入仅落在 P15/P10/P14/P02/P11/P20 等固定脚，**P33.x 无 ERU 通路**。故编码器信号只能走 GTM TIM。

**重要纠错（2026-09-26 实现时核实）**：早期方案写的 "GTM TIM UDC 硬件正交（`UDCCTRL/CLS/DUTC` 寄存器）" 是 **GTM gen2** 的寄存器组；本芯片 TC27D 的 GTM 是 **gen3**，`IfxGtm_regdef.h` 中 TIM 通道**没有 UDC 寄存器**，通道模式只有 TPWM/TPIM/TIEM/TIPM/TBCM/TGPS。GTM gen3 上正交解码没有硬件通路，故最终实现为 **TIEM 双边沿中断 + 软件 ×4 正交**（`rt/encoder.c`，当时位于 `Bsp/encoder.c`）：硬件只负责"每个边沿都进 ISR 不丢计数"（空载 500 rpm 四路合计 ≈1.7k 中断/s、13 V 上限 ≈3k/s，≪1% CPU1；V1.17 按 13 PPR = 52 边沿/电机转重算，原 260 线口径的 139k/s 作废），方向与 ×4 细分在 ISR 里按电平表完成。

### 8.4 台架判向与验证（接线后一次做完）

1. **静态**：不转轮子，控制台读 `ENCODER_getRawCounts`（经日志环加一条临时打印即可），四个计数 60 s 内应保持 0（2 µs 滤波应滤掉漂移）。
2. **手转判向**：每个轮子沿"车头向前"方向手转 ≥1 圈，对应编码器计数应**增加**；若有减少，把 `encoder.c` 的 `g_encInvert[]` 对应项改 `-1`（这就是产测"自动判向"的手动版，`21 §15.3`）。**2026-09-27 起首选自动版**：发 `0x70`（SF CMD/DPT 通道，`PROTO_CMD_DPT_CAL_DIR`），CPU1 逐轮打 +12% duty 脉冲 250 ms 并按计数符号自动翻转 `g_encInvert`（`ENCODER_setInvert` 运行时生效，无需重编），结果看控制台 `ENCCAL=` 行（8 个数 = 判向后 invert[0..3] + 各轮脉冲计数 delta[0..3]；delta=0 = 该编码器没接好/不计数）。**执行前提：四轮必须离地**（全程 ≈1.4 s，急停会立即中止）。
3. **倍频验证**：手转一整圈，计数增量应 ≈ **1061**（±轮打滑误差）。若 ≈ 265，说明某相没接上（×4 退化成 ×1）；若数值抖动大，查 3V3 供电与共地。
4. **对侧一致性**：左侧 A/B 两编码器（E1/E2）同转同向时计数应同号同速；右侧（E3/E4）同理。电机算法把每侧两轮并成一路侧速（求和），符号不一致会在这一步暴露。
5. 通电低速（SET_SPEED ±10）跑 5 s，遥测 `leftSpeed/rightSpeed` 应显示实测值（alive 后 CPU0 用编码器实测覆盖指令回显）。

**§8.4 的持久化与台架命令（2026-09-27 起，V1.16，真源 [34 §8/§9/§13](../30-tc275/34-calib-dpt.md)）**

- **判向结果自动落盘**：`0x70` 正常跑完（`ENCCAL=` 行出现）即由 CPU0 把 invert 写进 **DFlash0 扇区 15（0xAF01E000）** 的 `CalibRecord`，`src=1`；写只在**车辆静止**后发生（目标/jog/实测全为 0 且静默 500 ms），写入序列 ~几十 ms 关本核中断、期间喂狗。**掉电保持**，上电由 CPU0 读回并广播，CPU1 在 1 kHz 环应用——**不必每次开机重跑判向**；校验失败则整体回落默认（`src=0`、`crcOk=0`）并按开环等价行为运行，不阻塞启动。**V1.16 起"开环等价"由固件强制执行**（34 §13 闭环使能门 `g_closedLoopOk`）：src=0 时 CPU1 把 SERVO `measValid` 钳 FALSE，duty 恒等于目标、清积分——编码器已接线但方向未标定的车**不可能再因闭环正反馈跑飞**（原点回中电机仍转动现象的根治）；门随记录 version 边沿翻转，开/关各打一行 `SERVO open-loop (record src=0; calibrate via 0x70)` / `SERVO closed-loop enabled`。
- **结果经 UI 显示**：EVT `0x22`（23 B：`op/status/invert×4/delta i32×4/saved`）由 CPU0 组帧、CPU2 发送，`saved=1` 才表示"这次标定真的存下了"（0 未持久化 / 2 写失败）。
- **单轮手动验证 = 步骤 2 的替代手段**：`0x71 MOTOR_JOG {motor, duty}`（duty=percent×10，钳 **±500**，即 ±50%）逐轮通电，纯开环、**故障锁存时拒收**、300 ms 不刷新自动停——用来手验"这一轮的正接线/正反转"而不必跑整轮标定；**同样要求轮子离地**。
- **参数读取/写入/清空**：`0x72 REC_GET` / `0x73 REC_SET`（12 B：`pos×4, invert×4, fullScaleMmS i16, wheelDiaMm i16`）/ `0x74 REC_CLEAR`，回执都是 EVT `0x23`（15 B）。`fullScaleMmS`（默认 1000）与 `wheelDiaMm`（默认 48）就是本节步骤 3 的"计数应 ≈1061"与遥测 mm/s 的两个换算常数——**改它们不再需要重编固件**，但**换算公式没变**，所以 §8.1 的 13 PPR / 1:20.409 gear 仍是唯一硬件真源（34 §8.2 红线）。

## 9. SPI 链路接线（V1.0 选定主链路：TC275 QSPI3 主机 ↔ C6 SPI2 从机，**实物已接线**）

背景：C6 改自研固件（`esp32c6_car`）后不再受 esp-at 约束，板间主链路从 UART 换向 **SPI**。拓扑与安全模型沿用量产 SDD §3.7：TC275 = 唯一时序主人（提供 SCLK 与硬件 CS），C6 = `spi_slave_hd` 从机 + 1 根 IRQ 握手线；C6 死机只会导致"主机事务超时 → 判失联 → 受控停车"，不可能导致失控。链路层帧为**新定 SF 帧**（4 字节对齐、段内多帧、FRAG 位），事务模型/寄存器映射/验证门禁见 [22-link-spi-design.md](../20-design/22-link-spi-design.md)。

### 9.1 接线表（TC275 QSPI3 主 ↔ ESP32-C6 SPI2 从机 HD）—— **已按本表完成实物接线（2026-09-26）**

| 信号 | TC275 引脚 | X1 脚位 | 方向 | ESP32-C6 | DevKitC-1 位置 |
|---|---|---|---|---|---|
| SCLK | P33.11 | X1-3 | 主→从 | GPIO19 | J3-9 |
| MOSI（主发 MTSR） | P33.12 | X1-4 | 主→从 | GPIO18 | J3-10 |
| MISO（主收 MRST） | P33.13 | X1-5 | 从→主 | GPIO20 | J3-8 |
| CS（SLSO5） | P23.4 | X1-12 | 主→从 | GPIO23 | J3-5 |
| HANDSHAKE（从忙/数据就绪） | P23.0 | X1-8 | 从→主 | GPIO21 | J3-7 |
| GND | GND | X1-40/X2-40 | — | GND | J3-1/12/15 |

```
 TC275 (QSPI3 主, X1 侧)                ESP32-C6-DevKitC-1 (SPI 从, J3 侧)
 X1-3  P33.11 SCLK    ────────────────►  GPIO19 SCLK   J3-9
 X1-4  P33.12 MTSR    ────────────────►  GPIO18 MOSI   J3-10
 X1-5  P33.13 MRST    ◄────────────────  GPIO20 MISO   J3-8
 X1-12 P23.4  SLSO5   ────────────────►  GPIO23 CS     J3-5
 X1-8  P23.0  电平握手◄────────────────  GPIO21 HS     J3-7（轮询，非中断，见 §9.2）
 GND    ──────────────────────────────────  GND（必须共地）
 （实物已按上表接好：X1-3/4/5/12/8 ↔ J3-9/10/8/5/7 + 共地；TC275 侧代码已实现，且 `USE_SPI_LINK` 已定义进 Debug/Release 两个 TASKING 配置，日常构建产出的就是本链路，见 §1 状态一览）
```

依据与冲突检查：
- TC275 侧符号（`IfxQspi_PinMap.h:160,194,226,287`）：`IfxQspi3_SCLK_P33_11_OUT`、`IfxQspi3_MTSR_P33_12_OUT`、`IfxQspi3_MRST_P33_13_OUT`、`IfxQspi3_SLSO5_P23_4_OUT`；P33.11/12/13、P23.0/P23.4 均在 X1 空闲清单（§8 之外），**与编码器 8 线（P33.0~7）零交集**。注意 QSPI3 另有 `SLSO7_P33_7`、`SLSO2_P33_8`、`SLSO11_P33_10` 等备选 CS 脚，**不得改用 P33.7**（已被编码器 E1B 占用），本表固定用 P23.4。
- C6 侧脚位取自 `esp-at/main/interface/spi/Kconfig` 的 C6 分支默认值（该工程实测可用），自研固件经 GPIO 矩阵同样可用；GPIO18~23 无板载复用、非 strapping 脚。C6 从机半双工能力已核：`soc/esp32c6/include/soc/soc_caps.h:352` `SOC_SPI_SUPPORT_SLAVE_HD_VER2 = 1`。
- **孔位号仍为文档值**：本表 X1-3/4/5/8/12 与 J3-5/7/8/9/10 是按手册 Figure 4 推得的**孔位编号**，接线者实际是按引脚名（P33.11 / GPIO19 等）插的。若实物丝印编号与本表不符，请回报以修正本表（脚位本身无冲突，纯文档标注问题）。
- **IRQ 上拉（2026-09-26 已确认为"无外部电阻"，详见 §9.3）**：GPIO21 为开漏握手，实物**没有**外接 10 kΩ 上拉，这条线的高电平完全由 **TC275 片内上拉**提供（`com/spi_hal_pins.c` 的 `IfxPort_setPinModeInput(..., IfxPort_InputMode_pullUp)`；C6 侧显式关掉了自己的内部上拉）。握手是**电平**语义（见 §9.2 "谁发起"），片内上拉驱动阻抗高、边沿慢，主机可能读到毛刺高 → 多开一次空读事务（只浪费轮询带宽，不影响正确性），但 R11 的"丢 IRQ"判据失真。
- 3.3V 逻辑两端一致，直连；线尽量短（≤20 cm）、SCLK 就近共地回流；**时钟档位 1 MHz（G1 波形门禁）→ 2 → 5（量产基线）→ 10/20（探索）**，每档 30 min CRC 误码判据，不做运行时自适应降速（C6 `spi_slave_hd` 上限 20 MHz）。
- IRQ 电气与上拉要求见上一条；TC275 侧 P23.0 按**输入+内部上拉、电平轮询**配置（`IfxPort_setPinModeInput(..., pullUp)`）。**不要**配 IOM 边沿中断：TC275 **有** SCU ERU（V1.21 口径修正——旧稿写"TC275 无 ERU"是错的，IMU 的 INT1 正在用它，见 §10.1/§11.2），但 **P23.x 一颗都不在 ERU 的 17 路 REQ 里**、也不在 IOM 监视输入内，所以边沿中断在这组脚上做不出来（22 号文档 E11 结论不变）。
- UART 通道（§2）**保留接线，但已不是板间链路**（2026-09-26 弃用，SDD §18 C15）：自研固件里继续起一个 115200 **调试控制台**即可，二者不冲突（GPIO6/7 与 GPIO18~23 无重叠）。

### 9.2 实施要点（对应改动清单见 22-link-spi-design.md §7）

> **当前进度（V1.8，口径随 V1.11 更新）**：实物接线已完成（§9.1）；**两侧固件代码均已落地**——TC275 侧 `com/` + `mw/sf/` + `Cpu2_Main.c`（22 号文档 §7.2），C6 侧 `esp32c6_car` `spi_slave_hd` 从机（提交 `22e15f2`，22 号文档 §7.1）。**TASKING IDE 构建链接闭合已达成（2026-09-26，Debug 0 错误）**。**UART 板间链路已弃用**：`USE_SPI_LINK` 定义进 Debug 与 Release 两个 TASKING 配置，构建产出的就是 SPI 路径（§2）。但**从未通电联调过**，G1 波形门禁未过。以下"事务模型/帧"两条是**两侧代码共同遵循的契约**，"验证"一项是**唯一未完成的主线**。

- **事务模型**：半双工定长事务，前导相位 `CMD(8)+ADDR(8)+DUMMY(8)`，数据相位长度取 4 的倍数（从机硬约束）。C6 用 `spi_slave_hd_write_buffer()` 发布 **6 个 u32 读寄存器**（`SF_READY/SF_TX_PENDING/SF_RX_ROOM/SF_ALIVE/SF_ERRSTAT/SF_CMDRSP` = 偏移 0/4/8/12/16/20），另有偏移 **24 的 `SF_GEN` 是唯一由主机写的寄存器**（`WRBUF` 写 4 B `{cmd,p0,p1,p2}`，用于 `RESET_LINK/SILENCE_ON·OFF/CLOCK_SET`，22 号文档 §4.3 + E14）；从机地址空间共 28 B，主机每次 `RDBUF` 只读前 24 B 前缀。主机轮询寄存器后决定读/写；**寄存器读非原子（22 号文档 E5 仍是事实）→ 主机单读快照 + 消费端钳位容错**（2026-09-27 起，22 号文档 V1.6 §4.2：原"连读两次取相同值"继承规范在从机每段完成/10 ms 都改写寄存器的实况下会"越忙越误判失联"，已废弃；判失联只看 `SF_ALIVE`）。**线上命令字节以 `spi_ll.h` 的 `SPI_LL_BASE_CMD_HD_*` 为准**（`WRBUF 0x01 / RDBUF 0x02 / WRDMA 0x03 / RDDMA 0x04 / SEG_END 0x05 / WR_END 0x07 / INT0 0x08`）：一次 `RDDMA` 突发必须由**额外的 `INT0` 事务**收尾、`WRDMA` 突发由 `WR_END` 收尾，否则从机永不释放缓冲（22 号文档 E12；`spi_types.h` 里的 `BIT(n)` 是内部枚举，照抄到线上必错）。
- **谁发起**：TC275 主机是唯一发起方。C6 有帧待出 → 更新寄存器并拉 IRQ → TC275 泵**每圈采样 P23.0 电平**，线为高即开读事务；线为低时 2 ms 保活轮询。注：**P23.0 做不出边沿中断**（**P23.x 不在 SCU ERU 的 17 路 REQ 里**、也不在 IOM 监视输入内；ERU 模块本身是有的，IMU 正在用，见 §10.1 与 §11.2 矩阵，见 22 号文档 E11），所以电平轮询是主路径而非兜底。遥测方向由 TC275 按 20 ms 周期主动写。代价：命令下行最坏时延 = 轮询周期 + 事务 ≈ 2.3 ms（50 ms 预算内）。
- **帧**：LINK 段用新定 **SF 帧**（`0x5A | VER | TYPE | SEQ | FLAGS | LEN(u16LE) | CID | 载荷 | CRC16`，段末补 0 到 4 倍数）；`FLAGS` 只有 `bit0=FRAG / bit1=FRAG_END`，**bit2..7 保留必须发 0**，且 **ACK 不是 flag**（它是 `TYPE=0x03`）。V1.0 因 `LEN≤248` → 整帧 padded **≤260 B = 单段上限刚好**（8 头 + 248 载荷 + 2 CRC = 258 → 补齐 260），一帧必然落在一个段内，**一定不分片**，两个位恒为 0；代价是最长帧独占一段（段内多帧只在短帧时才凑得下）。手机 WS 段仍是 v2 帧，C6 bridge 做字段级映射；OTA CHUNK 上限 62 B → 240 B。遥测方向 `TYPE=0x02/CID=0x10` 是**固定 38 B**、与 v2 `0x41` 逐字节相同（从机复用 v2 解码器）——**短一个字节就从机整帧丢弃，手机页面全无数据**。
- **TC275 代码（V1.5 已落地，2026-09-26 第二轮按已烧录 C6 固件契约完善；现位于 SDD §3.4 目标态目录）**：`com/spi_hal_pins.c`（QSPI3 主机 + P23.0 电平采样 + 定长事务）、`com/link.c`（握手寄存器 + 事务泵 + **按 TYPE/CID 白名单的命令下行** + 38 B 遥测上行 + `LINK_gen/LINK_setClock` 控制面；**2026-09-27 泵简化**：单读快照 + 消费端钳位、失联只由 `SF_ALIVE` 500 ms 判定、READY 沿仅重锁 RX）、`mw/sf/sf_frame.c`（SF 编解码，含 SEQ 越窗 8 帧重锁）、`mw/sf/sf_telemetry.c`（38 B 遥测 codec）；主机单测两份都在 `test/host/`（帧层 2948 断言、遥测层 154 断言且编译从机解码器交叉验证）。挂载在 `Cpu2_Main.c` 的 `#ifdef USE_SPI_LINK` 分支。**QSPI3 的 TX/RX/ER 三个 ISR 声明在 0 号向量表、优先级 6/9/10**（SDD §18 C1/C2）。**构建默认口径（2026-09-26 起）**：`USE_SPI_LINK` 已定义进 `TriCore Debug (TASKING)` 与 `TriCore Release (TASKING)` 两个配置，日常构建产出的就是上面这条 SPI 路径；`com/wifi_at.c` 的 AT/UART 分支只在手动删掉该符号时才参与编译，定位是 G1 失败的应急返修 + C6 调试控制台（SDD §5.6 末条、§18 C15、本文 §2）。开关极性翻正（默认 SPI、UART 需显式 `-D USE_WIFI_AT`）排在 G1 之后。**G1 未过不因弃用 UART 而消失**：SPI 波形兼容性仍未台架证明。
- **C6 代码（已完成，`esp32c6_car` `22e15f2`）**：`components/c6_link/link.c` 传输层 UART → `spi_slave_hd`，`components/c6_sf/` 承担 SF 编解码（v2↔SF 映射落在 c6_link 内部而非 bridge，差异记录见 `esp32c6_car/doc/14-sf-link.md` D1）；0x44 波特率协商状态机与 `C6_LINK_TX/RX_GPIO` 已删除，`link.h` 对外 API 签名不变。**两侧常量核对结论（重要）**：偏移/magic/上限/段长一致，但主机侧初版有三处同名不同义（`FLAGS bit1`、OTA CID 缺 `0x35`、`ERRSTAT` 整张位表）+ 两处行为级缺陷（分派不看 CID、遥测只发 6 B），**已全部按从机更正**，证据与教训见 22 号文档 §2 E13/E14 与 SDD §18 C11~C13。
- **唯一硬风险（R7）**：AURIX QSPI 没有命令/地址相位概念、iLLD 主驱动亦无封装，前导相位只能用数据字节模拟；Espressif HD 从机是否接受该波形**必须台架先验**（G1：两台 ESP32 跑官方例程抓参考波形逐位比对）。退路：① C6 自写寄存器级从机驱动（纯数据相位 + 固定段长）；② 回退 §2 的 UART 链路——**该链路已于 2026-09-26 弃用**，走这条退路要删 `USE_SPI_LINK` 重编 + 两侧重刷镜像，不再是一行 `#ifdef`（SDD §18 C15）。
- 若后续要双/四线提速，还需补 WP/HOLD 两脚（C6 GPIO14/15，TC275 需 QSPI3 备用数据线方案），本版不考虑。

### 9.3 板间连线的电气形态：**杜邦线直连，全程无外部元件**（2026-09-26 用户确认；写代码前读这一节）

**事实**：KIT-AURIX-TC275-LITE ↔ ESP32-C6-DevKitC-1 V1.2 之间**所有**连线——§9.1 的 SPI 五线（SCLK/MTSR/MRST/CS/IRQ）、§2 的调试 UART 两线、以及共地——都是**杜邦线一对一直连**。两板之间**没有任何外部元件**：无外部上拉/下拉电阻、无串联端接电阻、无电平转换、无磁珠/屏蔽层处理。唯一例外是共地本身必须接（§5.4）。

这一条决定了下面每一行代码该怎么写，按后果列：

| # | 后果 | 代码上的硬性要求 |
|---|---|---|
| 1 | **IRQ 的高电平只由 TC275 片内上拉撑起来**：`com/spi_hal_pins.c` 里 `IfxPort_setPinModeInput(SPIHAL_IRQ_PORT, SPIHAL_IRQ_PIN, IfxPort_InputMode_pullUp)`；C6 侧 `esp32c6_car/components/c6_link/link.c` 反而显式写了 `GPIO_PULLUP_DISABLE`（其注释假设"external 10k"，**与实物不符**，属该仓库待更正的注释）。也就是说这根线是"开漏 + 片内弱上拉"，不是被电阻硬拉到 3V3。 | 驱动阻抗高 → 边沿慢、抗扰弱。该脚**只做静态电平判读**（泵每圈 `IfxPort_getPinState`），**不得**在其上加任何时序假设、边沿计数或"跳变即事件"的逻辑（22 号文档 E11/C9 已经说明边沿中断在 P23.x 上做不出来）。 |
| 2 | 读到毛刺高是**可能的**，代价只是多开一次空读事务 | 这是可接受路径，不要为此加去抖/确认轮次的复杂度；但要接受"IRQ 为高 ≠ 一定有帧"，读事务仍必须由 `SF_TX_PENDING` 决定读多少（22 §4.2 序 2）。 |
| 3 | C6 复位/未启动期间 GPIO21 的态取决于该脚复位默认值（**未逐项核过**）：线可能被内部下拉拉低，也可能被 TC275 片内上拉保持为高 | 两种情况的后果都是无害的（读高 → 空读事务 + 寄存器读回 0x00/0xFF → 事务超时；读低 → 退化为 2 ms 保活轮询）。因此**判活只看 `SF_ALIVE` 是否推进，绝不能用 IRQ 电平当"从机在不在"的判据**。 |
| 4 | MISO（P33.13 / `IfxQspi3_MRSTD_P33_13_IN`）同样配成 `IfxPort_InputMode_pullUp`，从机未驱动期间读回的是**片内上拉出来的电平**，不是数据 | 不得把"全 0xFF"解释成从机在位的证据（0xFF 在这里是电气默认态而不是应答）。判定按 22 号文档 V1.6 §4.2/§5.4 的新口径（2026-09-27 起）：快照单读、撕裂值消费端钳位，`READY` 魔数错静默 `LINK_DOWN` 自愈，**判死只由 `SF_ALIVE` 500 ms 判定**，而不是靠单一魔数。 |
| 5 | SCLK/MTSR/CS **无串联端接**，线长就是杜邦线长度 → 反射与振铃没有硬件抑制手段 | 只能靠时钟档位收敛：1 → 2 → 5 MHz，每档 30 min CRC 误码判据（22 §8 G5）。构建默认与 `LINK_init()` 实参不得预设 >5 MHz；`LINK_setClock()` 改档必须与 G5 实测数据同批提交。 |
| 6 | 调试 UART（P15.0/P15.1 ↔ GPIO6/7）也无端接、无外部上拉 | 固定 115200、不追求带宽（21 §16 R4）；该通道**不承担板间业务流量**——UART 作为板间链路已于 2026-09-26 弃用（§2、SDD §18 C15），只出 C6 控制台日志。 |
| 7 | 两端均 3.3 V 逻辑，**直连无转换**；kit 不兼容 5 V 电平（§5.2） | 任何"接个分压电阻去读 5 V 信号"的想法都是硬件变更，须先回写本文并升版，再改 `bsp/` 与引脚配置。 |

**待办（本节因此成立的前提）**：量产线束若改为定长屏蔽、或给 IRQ 补外部上拉，本节与 21 §16 R11、22 §3.2/§9 R11 必须同步升版；台架上量到的任何"电平读错"现象，在补上外部上拉之前都不能归因到 C6 侧驱动能力。

## 10. TC275 ↔ LSM6DSV16BX 六轴 IMU（QSPI1 主机，✅ 已接线、首验 ① 通过 2026-10-03）

模块：**LSM6DSV16BX** 六轴 IMU（3D 加速度计 + 3D 陀螺仪），**3.3 V 供电、3.3 V 数字接口**（裸芯 VDD 1.71~3.6 V，3.3 V 直连合法，禁 5 V——kit 逻辑电平 3.3 V，§5.2）。需求定位 **F13（11-requirements V1.2，V2.0 感知层）**：本节提前把脚位占用锁进真源、防止后续接线撞位，软件设计待另立文档。

**为什么独立走 QSPI1、不挂 QSPI3**：QSPI3 是板间主链路专用（§9），事务/段长被 C6 `spi_slave_hd` 契约锁死、只挂 C6 一个从机；IMU 落在 QSPI1 的空闲成组引脚上，两条总线互不影响。

### 10.1 接线表

| 六轴模块引脚 | TC275 引脚 | X1 脚位 | 方向 | 功能 |
|---|---|---|---|---|
| VCC / 3V3 | VEXT（3.3 V） | X1-2 | — | TC275 板向模块供电（LDO G1 输出轨，§5.2） |
| GND | GND | X1-40 | — | 共地（§5.4） |
| SCL / SCK / SPC | P11.6 | X1-36 | 主→IMU | QSPI1 SCLK |
| SDA / SDI / MOSI | P11.9 | X1-35 | 主→IMU | QSPI1 MTSR |
| SDO / MISO | P11.3 | X1-37 | IMU→主 | QSPI1 MRST |
| CS / NSS | P11.10 | X1-34 | 主→IMU | QSPI1 SLSO3，低电平选中 |
| INT1 | P15.4 | X1-31 | IMU→主 | 数据就绪 / FIFO 通知，**推荐接** |
| INT2 | P15.5 | **X1-29**（丝印 SDA0；V1.21 更正，原记 X1-30 有误） | IMU→主 | 运动事件通知，可选。**⚠ X1-30 是 PORST_N 复位网，不是 P15.5——INT2 线若插在 30 号孔等于把模块输出踩在复位网络上，必须改插 29** |

依据与冲突检查（iLLD 符号与全工程占用已核对，2026-10-03）：

- QSPI1 符号（`IfxQspi_PinMap.h:213,182,133,254`）：`IfxQspi1_SCLK_P11_6_OUT`、`IfxQspi1_MTSR_P11_9_OUT`、`IfxQspi1_MRST_P11_3_IN`、`IfxQspi1_SLSO3_P11_10_OUT`。P11.3/6/9/10、P15.4/P15.5 当前**零应用占用**（`bsp/ com/ rt/ mw/` 无引用），与 QSPI3 五线（P33.11/12/13、P23.0/23.4）、编码器 8 线（P33.0~7）、电机 12 线（P21.x/P00.x/P22.3）零交集；与 ASCLIN1（P15.0/P15.1，§2 调试控制台）同端口不同脚，无冲突。
- **P11.x 丝印是以太网 MII 名（§2 已注），可安全复用**：P11.9=RXD1、P11.3=TXD0、P11.6=TXEN、P11.10=RXD0（`IfxEth_PinMap.h`）——kit 无以太网 PHY、板上无外部驱动电路，与 X1-17/18/20 作电机线同一结论（§3 注）。**勿按丝印当串口/以太网接。**
- **Shield2Go 2 号座冲突**：P11.10 同时是 Shield2Go 2 的 CS 复用位（§2 注）——使用 IMU 期间**不得在 2 号 Shield2Go 座插板**（本项目无此扩展计划）。
- **INT1/INT2 可以做边沿中断**：P15.4/P15.5 在 SCU ERU 通路内（`IfxScu_REQ0_P15_4_IN` / `IfxScu_REQ13_P15_5_IN`，`IfxScu_PinMap.h:128,132`）——与 P23.x 不同（P23.x 一颗都不在 ERU 的 REQ 清单里；§9.1 旧稿"TC275 无 ERU"的措辞已在 V1.21 更正）。**完整 8 通道 × 4 选择的占用矩阵见 §11.2**：P15.4=**ch0 选 a**、P15.5=**ch4 选 d**，二者互不干扰可同用；但 **ch0 的另一候选正是 mikroBUS 的 INT 孔 P10.7（ch0 选 c）** ⇒ IMU INT1 占着 ch0，ToF 的 INT 就**不能**再走 ERU。
- **供电在预算内**：VEXT = 板载 LDO G1 输出轨（上限 1 A，§5.2 电流预算），IMU 模块典型 <5 mA，§5.2 已单列一行（V1.21 起同表另有 ToF 典型 95 mA，扣后 VEXT 余量 ≈600 mA）。§5.2 方式④"拆 R27"仅针对**向 VEXT 灌入**外部 3.3 V 的特殊场景，从 VEXT **取电**不受此限。
- **孔位号口径同 §9.1**：X1-29/31/34/35/36/37 为手册 Figure 4 推得的孔位编号（**V1.21 更正**：原表把 INT2 记成 X1-30，官方 Figure 4 实为 **X1-29 = P15.5/SDA0**，X1-30 是 PORST_N），接线者实际按引脚名（P11.6 / P15.4 等）插线；实物丝印若与本表不符，请回报修正本表（脚位本身无冲突，纯文档标注问题）。

### 10.2 实施要点

- **SPI 协议（ST 惯例）**：SPI 模式 3（CPOL=1 / CPHA=1）、MSB first；首字节 = R/W 位（1=读）+ 7 位寄存器地址，多字节传输地址自动递增（IF_INC 默认开）。
- **时钟档位**：裸芯 SPI 上限 10 MHz（数据手册口径）；本组线同为杜邦线直连（§9.3 口径沿用到这组新线），起步 1 MHz，台架按寄存器读回/数据 CRC 逐档上探，纪律同 §9.1 档位表。
- **上电首验**：① 万用表量模块 VCC ≈ 3.3 V；② 读 `WHO_AM_I(0x0F)` 与模块数据手册核对（**LSM6DSV16BX = 0x71**，手册 0Fh 固定 71h；**0x70 是另一颗 LSM6DSV16X 的 ID**，2026-10-03 曾按 0x70 核对并把在位传感器判成失联，见 35 §2）；③ 配置 ODR 后示波器看 INT1 脉冲频率与 ODR 一致。
- **INT 电气**：INT1/INT2 默认推挽输出、高有效，可直连；若固件配成开漏，高电平由 TC275 片内上拉撑起（§9.3 第 1 条同款），**不得接 5 V 上拉**。
- **状态**：✅ **实物已接线，首验 ① 已过（2026-10-03 台架实测）**——上电打 `IMU ready (WHOAMI=0x71, ODR 240Hz, +-4g/+-500dps, 1MHz)`，静置 `IMU` 行六轴为 `595 479 -649`（模 **995 mg** ⇒ 供电、模式 3、小端与加计 Z,Y,X 轴序一并拿到实物证据），转动模块时陀螺跟动，`err` 恒 0。**此前 V1.2 的"首验 ① 未过（`id=0x00`＝MISO 未被驱动）"随接线修正而结案**（当时的 `IMUERR st/id/err/clk= 2 0 0 1000000` 与"期望 ID 写成 0x70"是两条独立缺陷，现两条都已闭合）。
  **仍开的三项（都在 35 §7 记档，未结案）**：
  ① **运行中静默**——跑几十秒到两分钟后 `IMU` 行变成六轴全 0 ＋ `tempC` 恰好 2500（＝raw 0x0000）＋ `drdy` 冻结，而 `err` 仍 0；`drdy` 同步冻结**排除了"SDO/MISO 单线断"**（INT1 是另一根线），病因收缩到公共路径（VCC/GND/SCL/CS）或器件自复位。35 V1.3 已把"14 B 全 0"判成读失败，接回 100 ms → `alive=FALSE` → 1 Hz 重探重配置的自愈链，判别口径按 35 §7.2 的 H1/H2 走（静默态按复位：不动线就恢复＝H1 掉电自复位，需重新供电/压线＝供电与接线）。
  ② **③ 的 `drdy` 增量实测 +399/行，期望 +480（-17%，且均匀性极好）**——候选是 ERU 事件标志在 ISR 延迟窗口吞沿（DRDY 优先级 24，低于编码器 16~23），或 **STIME 的 ms 时基偏慢 ~17%**（若时基偏，全部超时/时长一起偏，性质更严重）。未结前**不提时钟档**。
  ③ **示波器实测 SCLK 周期 5 µs（200 kHz）**，而 `clk` 字段报 1000000。分频比自洽，可疑的是"绝对 Hz"标签：`IMU_actualClockHz()` 走 iLLD 的 `IfxQspi_calcRealBaudrate()`，它**假设 QSPI 输入时钟 = fMAX**，而全仓没有任何 `IfxScuCcu_init()` 调用。判别：与 §9 的 QSPI3 链路同表计对照，若同倍率偏慢即为全局时钟模型问题，与本节无关。
  设计真源与完整判读表：[35-imu-driver.md](../30-tc275/35-imu-driver.md) §6/§7。

## 11. TC275 ↔ VL53L5CX 8×8 多区 ToF（I2C0 主机，mikroBUS 插座，🔌 方案定稿 · 待接线）

器件：**VL53L5CX**（ST，DS13754 Rev13）——8×8=64 区 ToF 测距，Optical LGA16、6.4×3.0×1.5 mm、**940 nm VCSEL**、每区 **2~400 cm**、最高 **60 Hz**、检测视场 **45°×45°（对角 65°）**、照明视场 50°×50°@75% 信号。I2C 从机，**8 位地址 0x52**（7 位 0x29），总线 400 kHz~1 MHz。

### 11.0 归属决策：挂 TC275，不挂 ESP32-C6

| 判据 | 结论 |
|---|---|
| 实时性 | 60 Hz 距离场要进 1 kHz 避障环。**C6→TC275 只有 SF 拉取模型**（主机轮询，命令下行 ≤2.3 ms、`SF_ALIVE` 500 ms 判失联，22 §4.2/§5.4）：传感数据多一跳就要多占一个 SF 事务，且失联判据把感知层和无线层绑死。挂 TC275 = 零链路跳数。 |
| 总线 | TC275 **有唯一的 I2C0 空闲**（`IFXI2C_PINMAP_NUM_MODULES 1`）：SCL 的三组脚位 P02.5/P13.1/P15.4、SDA 的 P02.4/P13.2/P15.5 中，P15.4/P15.5 已被 IMU 的 INT1/INT2 占（§10.1）；P02.4/P02.5 落在 Arduino 区（Figure 6 为位图，孔位↔脚位无法从文本可靠还原，且与 A4/A5 的模拟功能纠缠）⇒ **选 P13.1/P13.2**，它们正好在同一把 mikroBUS 插座的 12/11 号孔上，接线与判读都最干净。 |
| C6 侧余量 | C6 已占 GPIO6/7（调试台）、10/11（板载 ADXL345 SPI）、18/19/20/21/23（链路）、8（WS2812）、9（BOOT strapping）、12/13（USB），剩余脚不多，且 C6 的固件契约已锁在链路上；再加一条 I2C 从机-主控职责会稀释它的唯一职责（Wi-Fi + 无线协议）。 |
| 功耗 | 95 mA 典型落在 kit LDO G1（1 A）余量内（§5.2），不需要为 ToF 单独开一路电源。 |

**结论**：**TC275 I2C0 主机 + mikroBUS 单插座接线**。C6 侧本批零改动。

### 11.1 原接线表（历史：mikroBUS；当前复测方案见 §11.6）

| VL53L5CX 引脚（DS Table 3） | 类型 | TC275 | mikroBUS 孔 | 方向 | 必需外部元件 |
|---|---|---|---|---|---|
| **C4 SCL** | 数字入 | **P13.1** = I2C0_SCL | **12** | 主→器件 | **2.2 kΩ 上拉至 3.3 V**（手册：上拉在 host 侧） |
| **C3 SDA** | 数字双向 | **P13.2** = I2C0_SDA | **11** | 双向 | **2.2 kΩ 上拉至 3.3 V** |
| **A3 INT** | 数字 I/O（默认**开漏三态**） | **P10.7** = mikroBUS 孔 15 "INT"（**只能电平轮询，做不了边沿中断**，见 §11.2 的 ERU 通道撞车） | **15** | 器件→主 | **47 kΩ 上拉至 IOVDD**（DS Table 3 硬要求；器件默认开漏 ⇒ 片内上拉不能替代外部电阻，见 §11.3） |
| **A5 LPn** | 数字入（休眠/通信使能，低有效） | **不占 MCU 脚（方案 A）** | — | — | **47 kΩ 上拉至 IOVDD**（DS 硬要求："A 47 k pullup resistor to IOVDD is required"），电阻另一端接 **孔 7 VEXT** |
| **A1 I2C_RST** | 数字入（**高有效**，仅复位 I2C 目标，不复位传感器本体） | — | — | — | **47 kΩ 至 GND**（DS 原文 "Connect to GND via a 47 k resistor"，**不要直接短 GND、不要悬空**） |
| **B1 / B7 AVDD** | 电源（2.8 或 3.3 V 模拟 + VCSEL） | **VEXT 3.3 V** | **7** | 供电 | 4.7 µF/6.3 V + 100 nF，**贴着器件放**（DS Figure 5 Note） |
| **A4 IOVDD** | 电源（1.8/2.8/3.3 V 数字 I/O） | **VEXT 3.3 V**（与 AVDD 同轨 ⇒ 3.3 V 配置窗口 3.0~3.6 V 合法） | **7** | 供电 | 100 nF |
| **C1 / C7 GND**、**B4 THERMALPAD** | 地 | GND | **8**（或 9） | 地 | THERMALPAD **必须接地平面**（DS Note + AN5657），裸 LGA 不焊地平面 = 热阻不达标 |
| A2 RSVD4 / A6 RSVD1 / A7 RSVD2 / C6 RSVD3 | 保留 | — | — | — | **全部接地** |
| C5 RSVD5 | 保留 | — | — | — | **不接**（悬空） |
| C2 RSVD6 | 保留（通用 I/O，默认开漏） | 本版不用 | — | — | 按 DS：47 kΩ 上拉至 IOVDD |

**接线形态（与 §9.3 的本质区别，coding 前必读）**：这**不是**"杜邦线直连、无外部元件"的一组。SDA/SCL 2.2 k + INT/LPn 47 k + I2C_RST 47 k 是数据手册硬要求；缺上拉的症状是"地址无 ACK""波形只见下降沿不见上升沿"，此时先查电阻再查固件。裸 LGA16 器件**无法杜邦直插**，实际接入形态为**现成 3.3 V 模块/转接板**（§11.3 有模块选型红线）。

> **⚠ INT 口径修正（2026-10-03，写进代码前必须读到）**：**P10.7 与 IMU 的 INT1（P15.4）共用同一条 ERU 输入通道（channel 0），二者不能同时做边沿中断。** 本节据此把 INT 的**消费方式定为 CPU0 电平轮询**（孔位仍按用户批准的 P10.7 不变）。依据、代价与换脚备选见 §11.2 第一条。

### 11.2 依据与冲突检查（2026-10-03 全部核过）

- **I2C0 脚位真源**：`IfxI2c_PinMap.h:74-79` —— 全工程只有 **1 个 I2C 模块**（`:82` `IFXI2C_PINMAP_NUM_MODULES 1`），SCL/SDA 各三组候选：SCL = P02.5(`:74`) / **P13.1(`:75`)** / P15.4(`:76`)，SDA = P02.4(`:77`) / **P13.2(`:78`)** / P15.5(`:79`)。P15.4/P15.5 已被 IMU 的 INT1/INT2 占（§10.1）；P02.4/P02.5 **不用**——它们出现在 Arduino X301/X303 的丝印区里（Figure 6 是位图，孔位↔脚位的对应无法从文本可靠还原），与 A4/A5 的模拟功能纠缠，且不在 mikroBUS 上。**⇒ 设计点 = P13.1/P13.2**。
- **孔位真源**：kit 手册 §3.1 Figure 5 —— mikroBUS 左列 1 AN=**AN26（即 P40.2，纯模拟脚，不能当数字 I/O 用）**、2 RST=**P10.6**、3 CS=P10.0、4 SCK=P10.2、5 MISO=P10.1、6 MOSI=P10.3、**7 3V3=VEXT**、8 GND；右列 9 GND、10 +5V、**11 SDA=P13.2**、**12 SCL=P13.1**、13 TX=**P15.0**、14 RX=**P15.1**、**15 INT=P10.7**、16 PWM=**P2.8**。AN 序号→脚位的对应见 `IfxVadc_PinMap.h:136-140`（AN24=P40.0 / AN25=P40.1 / AN26=P40.2，VADC 组 3）。
- **⚠⚠ P10.7 做不了边沿中断——ERU 输入通道与 IMU 撞车（本节的硬约束，iLLD 逐条核过）**：TC275 的 ERU 只有 **8 条输入通道**（`IfxScu_PinMap.h:152` `IFXSCU_PINMAP_NUM_REQUESTS 8`），每条通道带 4 选 1 的输入选择器（`ExternalInputSelection_0~3` = RxSel a/b/c/d），**同一时刻一条通道只能选中一个脚**。而 `IfxScu_REQ4_P10_7_IN = {&MODULE_SCU, `**`0`**`, {&MODULE_P10, 7}, Ifx_RxSel_`**`c`**`}`（`IfxScu_PinMap.c:73`，第二个字段就是 `channelId`）与 IMU 在用的 `IfxScu_REQ0_P15_4_IN = {..., `**`0`**`, {&MODULE_P15, 4}, Ifx_RxSel_a}`（`:61`）**同属 channel 0**。IMU 已把 channel 0 配成"选 a = P15.4、上升沿、INP0→OGU0→`SRC_SCUERU0`"（`bsp/imu.c:221-233`）⇒ ToF 若也走 ERU 就必须把 channel 0 改选 c，**代价是 IMU 的 DRDY 计数当场归零**。
  - **本节的处置**：**孔位保持 P10.7 不动**（用户已批准的 mikroBUS INT 孔），**消费方式 = CPU0 周期轮询电平**。VL53L5CX 的 INT 是"帧结束置位、读清"的**电平语义**（DS Table 3：默认开漏三态输出），轮询完全够用（最高 60 Hz 帧率 ⇒ 16.7 ms 一帧，CPU0 的 FreeRTOS 任务周期远快于此），且这与 §9.1 对 P23.0 的"电平轮询"是同一套判读纪律。
  - **确实要边沿中断时的备选（本批不做，仅登记）**：换到**未被 IMU 占用的 ERU 通道**，四处可选（孔位号按 kit 手册 Figure 5，且都**不在这把 mikroBUS 上**）——**P10.8**（`REQ5`，ch1 选 c）= Shield2Go **2 号座 8 号孔**（丝印 INT/GPIO3）、**P00.4**（`REQ7`，ch2 选 c）= Shield2Go **1 号座 8 号孔**（同名 INT/GPIO3，电机线用的是 P00.0/1/2/6，这颗空闲）、**P20.0**（`REQ9`，ch6 选 a）= S2G2 **11 号孔**（丝印 AN2/TX）、**P20.9**（`REQ11`，ch7 选 a）= S2G1 **12 号孔**（丝印 RST/GPIO2）。**排除项**：ch3 系（P10.3=mikroBUS MOSI、**P14.1=ASCLIN0 RX——§6 唯一调试串口，绝不可占**、P02.0 孔位未核实）；ch4 的 a 选项 P33.7 已是编码器 E4B、只剩 P15.5（IMU INT2）；ch6 的 d 选项 P11.10 是 IMU 的 CS 输出；**P23.x 整组与 mikroBUS 的 1 号 AN 孔（P40.2）、16 号 PWM 孔（P2.8）都不在 ERU 的 17 路 REQ 清单里**。换脚 = 放弃"一把插座接完"，须回写本节并升版。
- **ERU 输入通道占用矩阵（V1.21 建，一次查清防止再撞；来源 = `IfxScu_PinMap.c:61-77` 的 `channelId` + `select` 两字段，孔位对照 kit Figure 5）**：TC275 只有 **8 条 ERU 输入通道 × 每通道 4 选 1**，17 路 REQ 全在这张表里；**一条通道同一时刻只能选中一个脚**，所以"两个脚各自都合法"不代表"能同时用"。

| ch | 选 a | 选 b | 选 c | 选 d | 通道现状（本工程） |
|---|---|---|---|---|---|
| **0** | **P15.4**＝IMU INT1（X1-31） | — | **P10.7**＝ToF INT（mikroBUS 15） | — | **已被 IMU 占用** ⇒ ToF 的 INT 走不了 ERU，改电平轮询 |
| **1** | **P14.3**＝boot/HWCFG 配置脚（R31，见 §11.2 方案 B 条） | — | **P10.8**＝S2G2 孔 8（INT/GPIO3） | — | 空闲（要用只能选 c=P10.8）——**ToF INT 边沿中断的首选备选** |
| 2 | P10.2＝mikroBUS SCK（未用） | P02.1（孔位未核实） | **P00.4**＝S2G1 孔 8（INT/GPIO3，电机用 P00.0/1/2/6，这颗空） | — | **空闲**——c=P00.4 可作 ToF INT 边沿中断的备选 |
| 3 | P10.3＝mikroBUS MOSI（未用） | **P14.1＝ASCLIN0 RX（§6 唯一调试串口，绝不可占）** | P02.0（孔位未核实） | — | 候选全被别处指定，**视同不可用** |
| 4 | **P33.7**＝编码器 E4B（§8.2） | — | — | **P15.5**＝IMU INT2（X1-29，v1 未配） | 空闲（a 选项已被编码器用作 TIM 输入，实际只剩 d 可用） |
| 5 | **P15.8**（是否引到排针**未核实**） | — | — | — | 空闲，唯一候选的孔位待查 |
| 6 | **P20.0**＝S2G2 孔 11（AN2/TX） | — | — | **P11.10**＝IMU CS（输出，不可作 ERU 入） | 空闲（实际只有 a=P20.0 可用） |
| 7 | **P20.9**＝S2G1 孔 12（RST/GPIO2） | — | REQ16 **P15.1**＝ASCLIN1 RX（§2 调试台） | — | 空闲（a=P20.9 可用） |

  口径修正（随本矩阵）：**①§9.1 两处旧稿写"TC275 无 ERU"，本版已就地更正**为"P23.x 一颗都不在 ERU 的 REQ 清单里"——ERU 模块是有的（IMU 的 INT1 正在用），22 号 E11 与 §9.1 的结论不变；**②§8.3 的"P33.x 无 ERU 通路"要收窄**——P33.x 里 **P33.7 就是 REQ8（ch4 选 a）**，只是它已归编码器、且编码器走 GTM TIM 而不走 ERU，所以那节的结论同样照旧成立。
- **不新增中断优先级**：轮询方案不占 ISR，21 §18 C2 的优先级表（4/8/12=ASCLIN0、6/9/10=QSPI3、11/14/15=QSPI1、16~23=编码器、24=IMU DRDY）**本批零改动**。若日后改用 ch1=P10.8 做边沿中断，才需要新登记一个优先级（下一空档是 **25**）与 OGU/SRC 通道。
- **P13.1/P13.2 当前零应用占用**（`bsp/ com/ rt/ mw/` grep 无引用）；P10.7 同理。与本节以外任何已登记线束零交集。
- **⚠ 同网复用（Note 2 原文）**："The I2C buses SCL and SDA are shared on the Shield2GOs, mikroBUS and Arduino connectors and are additionally connected with analog Inputs AN24 and AN25. You can not use I2C and analog reading functions of AN24/AN25 simultaneously." ⇒ ① S2G1/S2G2 的 **5/4 号位**（SCL/SDA）与 Arduino X303 的 **A4/A5**（原理图网络名 `ADC4/SDA0`、`ADC5/SCL0`）与 ToF **同网**；手册点名的"AN24/AN25"按 iLLD 就是 **P40.0（VADC G3 CH0）/ P40.1（G3 CH1）**（`IfxVadc_PinMap.h:136-139`）⇒ **接了 ToF 之后，这些孔只能当同一条 I2C 用，不得再当模拟输入**；② **电池电压采集走 X2-23/AN4，是另一张网络、另一个 VADC 组，不受影响**（§5.5 结论不变）。
- **⚠ 插座共享纪律**：同一把 mikroBUS 上，**13/14 号孔就是 §2 的 ASCLIN1 调试控制台（P15.0/P15.1）**，4/5/6/3 号孔的 SPI 与 S2G、Arduino 共享（Note 1）。⇒ **禁止往该座整块插 Click 板**；ToF 只能按本表**逐孔飞线**，或插一块只用到 11/12/15/7/8 孔的自制载板。
- **⚠ 方案 B（LPn 占 P10.6=mikroBUS 孔 2）为什么放弃**：Table 2 记 **R31（1 k，出厂未焊）连接 P14.3，"Assemble if needed, but overboots then P10.5/P10.6"** —— P10.6 与 boot 配置网络有牵连，用它当 LPn 要把 R31 的空焊状态当成常规约束记住。方案 A 完全不碰这两个脚，**R31 保持出厂空焊**即可。
- **AVDD 与 IOVDD 同取 VEXT 的副作用（必须登记）**：好处——DS §3.3 要求"IOVDD 与 AVDD 同时或后于 AVDD 上电"，同源单轨天然满足，摆率下限（AVDD 0.001 V/µs、IOVDD 0.012 V/µs）由 LDO 上电斜坡保证；代价——① VCSEL 每帧的 50 mA 级脉冲电流直接压到与 IMU（§10）、与 **VAREF1 同轨**（§5.5）的 VEXT 上，可能污染电池 ADC 与 IMU 供电；② 二者不能分别断电。**判据**：台架开连续测距前后对比 `batteryMv` 抖动幅度，若明显变大，**ToF 改独立 3.3 V LDO**，**绝不许动 VAREF**。

### 11.3 电气与速率纪律

- **绝对最大 3.6 V**（DS Table 11：AVDD/IOVDD 与 SCL/SDA/LPn/INT/I2C_RST 全为 −0.5~3.6 V）⇒ **本器件与本 kit 都禁 5 V**。选现成模块时的红线：模块必须是 **3.3 V 电平**，**若模块带 5 V 电平转换或把上拉拉到 5 V，一律不能用**（会同时超 TC275 与器件的耐压）。
- **模块自带 2.2 k 上拉时不要再并**：DS 的 2.2 k 要求已由模块满足；再并在电气上不会损坏器件（拉低时每支路灌 (3.3−0.4)/2.2 k ≈ **1.3 mA**，两支路 2.6 mA，器件与开漏驱动都吃得下），但只是浪费、且让总线电容预算变紧。接线前**先断电量孔 11/12 对 3V3 的阻值**确认。
- **INT 默认开漏三态** ⇒ 必须外部 47 k 上拉；这与 §10 IMU 的"推挽默认、可靠片内上拉"不同，**不能沿用 IMU 的接线习惯**。MCU 侧按**普通输入**配置：`IfxPort_setPinModeInput(&MODULE_P10, 7, IfxPort_InputMode_noPull)`（外部已有 47 k，不必再开片内上拉；开了也无害，只是把高电平抬得更实）。**不要**调用 `IfxScuEru_*` 去配这颗脚的边沿中断——ERU 输入通道 0 归 IMU（§11.2 第一条）。
- **速率纪律：400 kHz 起步**。FM+（1 MHz）要求 SCL/SDA **tR ≤ 120 ns**（DS Table 7，CL typ 140 pF/max 550 pF）；2.2 kΩ × 杜邦线 + 模块寄生电容的量级就到 µs 了，**1 MHz 在没有示波器实测 tR 之前不许写进代码**。这也符合 §9.1 的档位纪律。
- **总线读时长不能压到 1 kHz 环上**：8×8 距离矩阵 = 64 × 2 B = **128 B**，加寄存器地址开销，400 kHz 下约 **3 ms**、1 MHz 下约 1.4 ms。⇒ **ToF 属主不得是 CPU1（1 kHz 电机环）**；建议 **CPU0（FreeRTOS 服务核）**做 I2C 读写，结果经 `mw/xcore` 出块供 CPU1 的 `motor_guard` 消费（块定义与消费判据未设计，见 §11.5）。
- **SF 链路口径**：128 B 距离场**可进单个 SF 帧**（`LEN ≤ 248`、整帧 ≤ 260 B = 单段上限，22 §3）；15 Hz × 128 B ≈ 1.9 KB/s。若连 RSSI/环境光一起上报（估 ~320 B）**超单段上限，必须先实现 FRAG 分片**（V1.0 恒不分片）。
- **上电与 IO 顺序**：DS §3.3.2 —— I2C 访问前提是电源已到 1.62 V；I2C_RST 只复位通信不复位传感器本体，传感器本体复位走 UM2884 流程 ⇒ **不要指望拉 I2C_RST 来做故障恢复**。

### 11.4 台架首验规程（接线后按序执行，失败即停在本步回报）

1. 断电核阻值：孔 11/12 对 3V3 各 ≈2.2 k（模块自带则同上，没有则补）；INT 对 3V3 ≈47 k；LPn 对 3V3 ≈47 k；I2C_RST 对 GND ≈47 k。
2. 上电量 **mikroBUS 孔 7 ≈3.3 V**；静态下 SCL/SDA/INT/LPn **均为高**（任何一个为低就是线短了或器件没上电）。
3. 总线扫描：`0x52`（8 位）**必须有 ACK**。无 ACK 的排查顺序：上拉 → LPn 是否为高 → SCL/SDA 是否插反（12/11 相邻，插反是本节最可能的错）→ I2C_RST 是否被误接到高。
4. 读器件 ID 寄存器：**地址一律从 ST API 头文件取，不手抄本表**（IMU 那次"期望 ID 写成 0x70"的教训，§10.2）。
5. 示波器看 SCL 实测频率与 tR，与代码里的 `baudRate` 对表（IMU 的 `clk` 字段虚报 1 MHz 而实测 200 kHz，§10.2 ③ ——I2C0 是另一个模块，不能沿用那个反算结论）。
6. 先跑 **4×4 / 5 ms 积分时间**，手掌在 **10~30 cm** 内移动，看距离跟动、无 `err`；再开 8×8。
7. 连续测距态下对比 `batteryMv` 与 IMU 六轴噪声（§11.2 的 VEXT 同轨判据），并复量表 THERMALPAD 一侧是否温热。
8. **INT 未接也不影响功能**：退化为主机轮询（每 `ranging_phase` 读一次），只是白耗 CPU0 时间。接好后按 §11.2 的**轮询**口径验证：帧结束时 INT 变高并保持，I2C 读结果后转低；**不要在示波器以外的地方期待它产生中断计数**（ERU 通道 0 归 IMU）。

### 11.5 明确不做 / 明确欠的

**本批明确不做（等用户另行放行，且必须与真实代码同批以保零告警）**：
- **不动 `.cproject`**：`Libraries/iLLD/TC27D/Tricore/I2c`、`I2c/Std`、`I2c/I2c`、`Port/Io` 仍在 Debug/Release 排除清单里（`:110`、`:204`）。解除排除会把 iLLD 源码引入编译，**必须与新增的 `bsp/tof.c` 同批构建、同一轮看告警数**，否则无法验证 0 err/0 warn。
- 不写 `bsp/tof.c`、不引入 ST 的 `vl53l5cx_api`（含其固件 blob：许可条款、Flash/RAM 占用、与 TASKING 的适配都还没评估）。
- 不登记 21 §18 C2 的 I2C0 / ERU OGU / 中断优先级占用：**轮询方案本来就不新增 ISR**；若日后改用 §11.2 备选脚做边沿中断，才需要连同 OGU/SRC/优先级一起登记。
- 不改 C6 侧任何文件；不在 11-requirements 里追加 ToF 需求条目（需求先行于接线，本节只锁脚位）。

**明确欠的（驱动/算法批次必须补）**：
- 需求依据缺口：ToF 在 11-requirements V1.2 中**尚无条目**，本节属于"提前锁脚位防撞位"（与 §10 IMU 的 F13 同类动作）。
- 消费路径：ToF → xcore 块 → `motor_guard` 避障判据未设计；8×8 六十四区如何压成方向代价（前/左/右三区？）、阈值、失效安全（失联后按什么策略减速）全部待定。
- 光学与标定：红外窗口/盖板（AN5657）、安装高度与俯仰、标定流程未定——**65° 照明视场装车头低位会直接打到地面**。
- I2C 模块能力：TC275 I2C0 能否在软件上做到 FM+ 1 MHz（以及是否需要 DMA）未查，400 kHz 为设计点。
- **跨文档同错待同步（本批只改了 23 与 35/00-index）**：`21-software-design.md:383` 与 `:716` 的 **C9** 仍写着"TC275/TC27D 无 ERU 模块"，`22-link-spi-design.md:42` 的 **E11** 沿同一条理由——**结论（P23.x 做不出边沿中断）都对，前提是错的**。这两篇正被另一条工作线改（21 已到 V1.14），本批不动它们，等下一批随代码同批更正。
- 形态：裸 LGA16 需载板/模块，具体模块选型未定稿（§11.3 的 3.3 V 红线是选型唯一硬条件）。

### 11.6 当前复测接线：P02.5 / P02.4（2026-10-04）

用户要求另换一组 IIC。仍为同一个 I2C0，切换至 input select A 和 ALT5 输出，不是换第二个 I2C 外设。应用 bsp/rt/app/com 未占用这两脚；P15.4/P15.5 与 IMU INT 共用，不选。原 §11.2 的“P02.4/P02.5 孔位不确定且与 A4/A5 纠缠”判断更正：官方手册 Figure 6/原理图确认它们是 X304-8/-7；X301-5/-6 与 X303-9/-10 的 SDA0/SCL0 是旧组共享网络，不能用这些孔当作新组。

| ToF 信号 | 新位置 | 连接要求 |
|---|---|---|
| SCL | P02.5，Arduino X304 第 7 孔 | 2.2 kΩ 上拉至 IOVDD（3.3 V） |
| SDA | P02.4，Arduino X304 第 8 孔 | 2.2 kΩ 上拉至 IOVDD（3.3 V） |
| AVDD、IOVDD / 模块 3V3 | VEXT 3.3 V；可沿用原供电位置 | 保持模块现有合规供电 |
| GND | 主控 GND | 与模块、逻辑分析仪共地 |
| INT | P10.7，原 mikroBUS 15 孔 | 原接法，47 kΩ 上拉 |
| LPn | IOVDD | 原 47 kΩ 上拉 |
| I2C_RST | GND | 原下拉接法 |

孔位依据 [Infineon TC275 Lite Kit User Manual Figure 6 / Schematics](https://www.infineon.com/dgdl/Infineon-AURIX_TC275_Lite_Kit-UserManual-v01_02-EN.pdf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)，并与本仓库 iLLD `IfxI2c0_SCL_P02_5_INOUT` / `IfxI2c0_SDA_P02_4_INOUT` 对照。以板端 X304 孔号/脚名确认位置，不用照片左右方向猜孔。X304-7/-8 是相邻两孔。

断电后拆掉原 P13.1/P13.2 的 SCL/SDA 信号线，再接新组。上拉随新信号网连接，原孔上留电阻不会自动上拉新组；若模块已带上拉，核对其确实接到 3.3 V。供电、INT 和 LPn 无需换位置。新固件硬件 I2C、GPIO 总线释放、GPIO 地址探测、故障引脚采样全部改为 P02.5/P02.4，100 kHz 起步。换线后由 COM16 的 TOFGPIO、TOFBUS、TOF 行复测，不以烧录成功替代测距成功。
