lilicqyu-ship-it/smartcar/tc275_car/doc/30-tc275/32-tc275-dev-guide.md

# 32 · TC275 开发指南（怎么做，不是为什么）

| 项 | 内容 |
|---|---|
| 文档编号 | 32 |
| 域 | TC275（本仓库固件工程） |
| 版本 | V1.11（2026-10-03：**IMU 驱动落地随 35 号 V1.0 同步**——§1 单测命令加 ③ `test_imu`（55 断言）与 ④ `test_xcore`（1095→1109，含 IMU 信箱）；§3 CPU1 行补 `bsp/imu.c`（QSPI1 11/14/15 + ERU 24）；§4 步骤 5 补 **SCU ERU 例外**（P15.4/P15.5 可边沿中断，IMU INT1 即此路径）。V1.10（2026-10-03：**看门狗假死根治随 tc275_car v1.1.2 / 21 V1.13 同步**——§3 调试约定补"超时反应已闭合"（WDT 到期=NMI→软复位，`Ifx_Cfg.h` 钩子；旧固件到期即假死）、窗口数字全文更正 0.3~0.5 s→**~1.4 s**、§8 排障表新增"整车冻结假死"一行。V1.9（2026-09-30：§8 排障表"手转一圈计数"一行按新刻度更正——实物编码器 13 PPR，×4×20.409 ≈ 1061 计数/轮转，半相退化判据 ≈265，随 23 V1.17 / 34 V1.4。V1.8（2026-09-27：**台架标定/DPT 落地随 34/21 V1.10 同步**——§1 单测命令 ① 的源列表加 `mw/calib/calib_record.c`（`.github/workflows/ci.yml` 同改，否则 CI 链接失败）、断言数 2873→**2948**；§8 排障表新增三行：开机 `CALIBREC` 一行怎么看、`0x71` jog 不动、DFlash 保存失败/`SAVED=2`；§5 补"写 DFlash 只允许 CPU0 且必须喂狗+关中断"。V1.7（2026-09-27）= **电池电压采集随 21 V1.9 同步**——§8 排障表新增 `batteryMv` 读数异常一行，验收动作=万用表量 X2-15 基准与电池电压（`23 §5.5`）。V1.6 = 2026-09-27：**CPU0/CPU1 硬件看门狗启用随 21 V1.8 同步**——§3 调试期约定从"看门狗已关"翻转为"现在是开的，跑着复位先查喂狗断流"，§8 排障表"跑一段时间后复位"改口径并新增"打印 `FATAL: stack overflow in task:` 后复位"一行；栈溢出钩子不再静默空转。V1.5 = 2026-09-27：**CPU1 速度闭环 + 判向自动化随 21 V1.7 同步**——§8 排障表新增 `SRV=`/`ENCCAL` 两行与"闭环不振荡"口径；判向首选 `0x70` 自动版。V1.4 = 2026-09-27：**链路泵简化随 `com/link.c` `ae10aac` 同步**——§1 单测断言数 2855→2873（`test_seq_relock`）并补 GitHub Actions 一句；§8 排障表"寄存器读回不稳"行改按单读快照新口径（`regUnstable` 计数器已随泵简化移除），新增"满载断连"历史故障行。V1.3 = 2026-09-26：**UART 板间链路弃用的构建口径**——§1 改为"两个 TASKING 配置都已定义 `USE_SPI_LINK`，构建只产出 SPI；GCC 配置无此符号"，§3 CPU2 行同步；§4 步骤 5 补 IRQ 无外部上拉、判活只看 `SF_ALIVE`（`23 §9.3`）。V1.2 = 目录重排同步：仓库已按 SDD §3.4 目标态布局组织（`app/ rt/ com/ mw/ bsp/`），include 为工程根限定路径；§1 主机单测命令、§3 任务地图、§5/§7/§8 路径同步；TC275 IDE 构建链接闭合已达成（Debug 0 错误）。V1.1 = SPI 链路契约回写（主机单测命令与排障表）） |
| 前置阅读 | `21 §18`（工程级实现约束，**动手前必读**）、`23`（接线真源） |
| 与 31 的分工 | 31 描述"现在代码是什么样"，本文描述"要加东西该按什么步骤动、去哪验证" |

---

## 1. 环境与构建

| 项 | 值 |
|---|---|
| IDE / 工具链 | AURIX Development Studio + **TASKING TriCore 编译器**（工程为 IDE 工作区工程：`.cproject` / `.project`） |
| 构建配置 | `TriCore Debug (TASKING)`，产物 `.elf` 在该配置目录下 |
| 链接脚本 | `Lcf_Gnuc_Tricore_Tc.lsl`（Gnuc）/ `Lcf_Tasking_Tricore_Tc.lsl`（TASKING，实际用这份） |
| 依赖 | `Libraries/`（Infineon iLLD，随仓库）、`FreeRtos/` + `Configurations/FreeRTOSConfig.h`（TriCore 移植，仅 CPU0） |
| 命令行构建 | **本工程无独立 CLI 构建脚本**，只能走 IDE；出现"能编不能刷"先确认用的是 TASKING 配置 |

导入：`File > Import > General > Existing Projects into Workspace` → 选仓库根目录。

常见编译错误：`FreeRTOS.h not found` = `FreeRtos/` 或 `Configurations/` 未完整检出（它们是工程的一部分，不需要另外安装）。

**切换链路固件（SPI ↔ 已弃用的 UART）**：`Cpu2_Main.c` 用 `USE_SPI_LINK` 分流。**当前状态（2026-09-26 决策：UART 板间链路弃用）**：`TriCore Debug (TASKING)` 与 `TriCore Release (TASKING)` 两个配置的 `-D` 列表里**都已经有** `USE_SPI_LINK`，所以日常构建只会产出 SF-over-SPI 路径（`com/link.c` 泵）；AT/UART 分支**不再是任何配置的默认**，只在手动删掉该符号时才参与编译。删除/恢复入口：`Project > Properties > C/C++ Build > Settings > TASKING C/C++ Compiler > Preprocessor > Defined symbols (-D)`。两个 **GCC 配置没有这个符号**，本工程不以 GCC 构建——若有人用 GCC 出镜像，拿到的是已弃用的 UART 分支，别据此判断链路行为。开关极性翻正（默认 SPI、UART 需显式 `-D USE_WIFI_AT`）仍排在 G1 之后（`22 §7.2`、`21 §5.6`）。**G1 未过这件事不因弃用 UART 而消失**：SPI 波形兼容性还没被台架证明，而回退现在要"删符号重编 + C6 重刷 esp-at"两侧都动（`21 §18 C15`）。

**SF 层的主机单测**（不需要 TriCore 工具链，**改过 `mw/sf/` 或 `esp32c6_car/components/c6_sf|c6_proto` 必须跑**）。本机用 MSYS2/MinGW gcc（若在 Git Bash 里报共享库错误，先 `export PATH="/c/msys64/mingw64/bin:$PATH"`），在**仓库根目录**执行：

```bash
# ① 帧编解码（2948 断言，含 400 万随机字节风暴、SEQ 越窗重锁 test_seq_relock，
#    以及 34 号标定/DPT 的 0x22/0x23 事件与 20 B 记录 blob 往返）
gcc -std=c99 -Wall -Wextra -Werror -O2 -I . \
    test/host/test_sf.c mw/sf/sf_frame.c mw/calib/calib_record.c \
    -o test/host/out/test_sf.exe && ./test/host/out/test_sf.exe

# ② 38 B 遥测布局（跨侧模式 154 断言；不带交叉为 116 项）—— 加 -DC6_CROSS_CHECK 会把**从机自己的**
#    proto_frames.c 编进同一个可执行文件做双向交叉，这才是跨侧证据
gcc -std=c99 -Wall -Wextra -O2 -DC6_CROSS_CHECK -I . \
    -I ../esp32c6_car/components/c6_proto -I ../esp32c6_car/components/c6_sf \
    test/host/test_sf_telemetry.c mw/sf/sf_telemetry.c \
    mw/sf/sf_frame.c ../esp32c6_car/components/c6_proto/proto_frames.c \
    -o test/host/out/test_sf_telemetry.exe && ./test/host/out/test_sf_telemetry.exe

# ③ IMU 换算链（55 断言；LSM6DSV16BX mg/mdps/温度换算 + SPI 命令字节，
#    纯函数在 bsp/imu.h——改灵敏度/FS 码/舍入后必跑；驱动主体 bsp/imu.c 无单测）
gcc -std=c99 -Wall -Wextra -Werror -O2 -I . -I test/host/stub \
    test/host/test_imu.c -o test/host/out/test_imu.exe && ./test/host/out/test_imu.exe

# ④ xcore 队列/日志/IMU 信箱纪律（1109 断言；stub 目录必须排 -I 首位）
gcc -std=c99 -Wall -Wextra -Werror -O2 -I test/host/stub -I . \
    test/host/test_xcore.c mw/xcore/xcore.c \
    -o test/host/out/test_xcore.exe && ./test/host/out/test_xcore.exe
```

①的判据见 `22 §7.2` 首行；②是 `21 §18 C11/C12` 那条铁律的落地手段——**文档写"两侧一致"不算验证，编译对方源码才算**。②不带 `-DC6_CROSS_CHECK` 也能跑，但那只测自己，退化成同义反复。

**CI 也跑这两份单测**（2026-09-27 起）：`.github/workflows/ci.yml` 在 push/PR 时用 gcc 跑 ①②（交叉模式直接编译公有仓 `esp32c6_car` 的 `proto_frames.c` 锁跨侧布局）并校验交互图 JSON；`release.yml` 推 `v*` tag 时先复用 CI 再发 Release。**改协议一侧必须让 CI 在这红**，不能只靠本机记得跑。TASKING 固件构建是专有工具链，不在 CI 范围。

## 2. 烧录与观测

| 通道 | 位置 | 用途 |
|---|---|---|
| 调试 | TC275 kit X4 micro-USB（一根线：供电 + DAS 调试 + 虚拟 COM） | `Debug As > tc275_car TriCore Debug (TASKING)` |
| 控制台串口 | kit 板载 FT2232 虚拟 COM，**115200 8N1** | ASCLIN0（P14.0/P14.1 **板内互连，没有引到外接排针**，想外接打印是不可能的） |
| 存活指示 | LED1 = P00.5（blinky 250 ms 翻转） | 三核调度是否活着 |
| C6 调试控制台口 | mikroBUS pin13(TX=P15.0)/pin14(RX=P15.1) ↔ DevKitC-1 J1-5/6 | **不是板间链路**（UART 已于 2026-09-26 弃用，`21 §18 C15`）；只出 C6 控制台日志，也是"删 `USE_SPI_LINK` 重编"时的应急返修口 |

调试期约定（2026-09-27 起已变更；**2026-10-03 补超时反应**）：**CPU0/CPU1 的 CPU 看门狗现在是开着的**（`bsp/wdg.h`，窗口 ≈**1.4 s**——`REL=0xF800` 按官方锚点 0xE000≈1.3 s 线性外推，旧稿"0.3~0.5 s"算术有误；喂狗点 = CPU1 的 1 kHz 环、CPU0 的 robot 任务 10 ms 循环）。SM(安全)与 CPU2 看门狗仍关闭。**超时反应已闭合（tc275_car v1.1.2，`21 §7.2`）**：TC27x 的 CPU WDT 到期只发 NMI、不自行复位，`Configurations/Ifx_Cfg.h` 的 NMI 钩子直接软复位——没有它，看门狗到期 = 整车假死（2026-10-03 台架复现的故障形态）。因此**任何"跑着跑着复位"的现象，第一嫌疑是这条核的喂狗点断了流**（任务被阻塞/优先级被饿死/死循环），而不是"忘了关看门狗"；新起的常驻循环必须自带 `WDG_serviceCpu()`。详见 `21 §7.2` 与 `21 §18 C8`。

## 3. 任务地图（谁在哪核上）

| 核 | 形态 | 代码 | 加东西时的落点 |
|---|---|---|---|
| CPU0 | FreeRTOS | `Cpu0_Main.c` + `app/robot.c` | 新任务 = 在 `Cpu0_Main.c` 建任务；控制类逻辑进 `robot.c` 的 10 ms 拍。**CPU0 看门狗已开**：常驻任务若会长期占住 CPU，需自行喂狗或提高 robot 任务优先级，否则 ~1.4 s 内 NMI→整机软复位 |
| CPU1 | 裸机 1 kHz | `Cpu1_Main.c` + `rt/motor_algo.c` + `rt/servo.c` + `rt/encoder.c` + `bsp/imu.c` | 算法进 `motor_algo.c`（斜坡/闭环/失联看门狗/判向 `0x70`/直驱 jog `0x71`）+ `servo.c`（速度 PI），**不许阻塞、不许打印**（打印走日志环，§6）；`rt/encoder.c` 的满量程/轮径是**运行时变量**（`g_fullScaleMmS`/`g_wheelDiaMm`，由 `mw/calib` 生效记录写入，公式不许动，`34 §8.2`）；编码器 ISR 属 `encoder.c`，优先级 16~23 见 `21 §18 C2`；IMU 采样/重探属 `imu.c`（QSPI1 11/14/15 + ERU 24，同表）。**CPU1 看门狗已开**，喂狗点在 `MOTOR_ALGO_run()` 环内 |
| CPU2 | 裸机超循环 | **构建只产出 SPI**：`Cpu2_Main.c` + `com/{link,spi_hal_pins}.c` + `mw/sf/`（`USE_SPI_LINK` 已在两个 TASKING 配置定义，§1）；UART 分支（`Cpu2_Main.c` + `com/wifi_at.c`）已弃用，删符号才编 | 链路层改动进 `com/`；SF 帧格式改动要同时改 `21 §6.1a`、`22 §5` 与 C6 侧 `c6_sf`（两处独立实现，靠文档对齐） |

命名与风格（照现有代码，勿另立）：文件名小写下划线、模块前缀大写 `MODULE_`（`ROBOT_task` / `MOTOR_ALGO_run` / `PROTO_feedByte` / `XCORE_estopRequest` / `WIFI_sendRaw`）；头文件守卫 `MODULE_H`；**代码注释用英文，文档与 commit message 用中文**。

## 4. 新增一个中断（最常踩、代价最高）

步骤，一条都不能省：

1. **查引脚与外设符号**：在本仓库 `Libraries/iLLD/TC27D/Tricore/_PinMap/` 下找 `Ifx<模块>_PinMap.h` 里的符号名（例如 `IfxQspi3_SLSO5_P23_4_OUT`、`IfxGtm_TIM0_0_TIN26_P33_4_IN`）。**不要凭记忆写引脚**。
2. **查冲突**：与 `23` 的接线状态一览和各表对一遍（尤其 P33.0~7 编码器、P00.0 CAN、P00.5/P00.6 LED、P15.0/P15.1 WiFi、P2x 组 JTAG/Shield2Go）。
3. **声明 ISR**：`IFX_INTERRUPT(myIsr, 0, prio)` —— **向量表参数固定写 0**，不论这个中断属于哪个核；目标核由 SRC 的 `typeOfService = IfxSrc_Tos_cpu0|cpu1|cpu2` 决定。原因见 `21 §18 C1`。
4. **挑优先级**：按 `21 §18 C2` 的已占用表（CPU0 用了 1/2/4/8/12，CPU2 用了 5/7/13 + **6/9/10 = QSPI3 TX/RX/ER**）取空闲档，并在该表登记。
5. **想给排针 GPIO 加边沿中断？TC275 上分脚**：P23.x/P33.x 这类 GPIO 既没有 ERU 通路也不在 IOM 监视输入内，配不出"电平跳变触发 ISR"（`21 §18 C9`）。握手/就绪类信号一律**输入+内部上拉 + 主循环采电平**（SPI 链路就是这么做的，`22 §2 E11`）。注意"内部上拉"在实物上是**唯一**的上拉：两板之间全是杜邦线直连、没有任何外部电阻，所以这条线驱动能力弱、边沿慢，采到的电平不能用来判从机在位（判活只看 `SF_ALIVE`），详见 `23 §9.3` 与 `21 §18 C14`。**例外 = SCU ERU 通路内的脚**：P15.4/P15.5（`IfxScu_REQ0/REQ13`）**可以**做边沿中断——IMU INT1 就走这条路（P15.4 → 输入通道 0 → OGU0 → `MODULE_SRC.SCU.SCU.ERU[0]` = UM 名 `SRC_SCUERU0`，**ISR 必须清 `SCU_FMR` 的事件标志**否则请求线常挂=中断洪水，`bsp/imu.c`，35 §3）；选脚前先查 `Libraries/iLLD/TC27D/Tricore/_PinMap/IfxScu_PinMap.h`。
6. **验证真的进表了**：构建后打开 `.map`，在 **Removed Sections** 里搜 `Isr`。出现你的 ISR 名 = 表号写错了，中断永远不会进、且编译链接全程无报错。
7. 上板验证：在 ISR 里累加计数器，经日志环（§6）或状态字段出到控制台，不要靠"感觉它在跑"。

## 5. 新增一条跨核消息（xcore）

现状模式（`31 §4`）：共享数据落在默认数据段（CPU0 DSPR）；TC275 **无数据 Cache**，不需要任何 Cache 维护；所有块由**同一把自旋锁**保护（`IfxCpu_acquireMutex` = cmpAndSwap），临界区只做几字节拷贝，**写后 `__dsync()`**。

加一条通道的步骤：

1. 在 `mw/xcore/xcore.h` 定义消息结构体（**定长、无指针**）与 `XCORE_xxxPublish()` / `XCORE_xxxTake()` 接口。
2. 实现里：`acquireMutex` → 拷贝 → `releaseMutex` → `__dsync()`；队列满时的策略要么"丢弃 + 记日志"，要么"覆盖最新"，**不允许阻塞**（CPU1 是 1 kHz 硬节拍）。
3. 需要"失联可判"的通道带 `seq` 计数（参考电机目标通道：CPU1 用它做 150 ms 失联看门狗）。
4. 同步更新：`31 §4` 通道表 + `21 §5.5`（量产 xcore v2 目标态）。

**"发布过没有"要判边沿的通道用版本计数，不靠数据本身**：`XCORE_init()` 会把共享 RAM 整片清零，而"全零"常常是一组**合法值**（清零的 `CalibRecord` 看着就是合理参数），于是"从未发布"与"发布了默认值"不可区分——参考 `XcoreRecordLive{version, rec}` 与 `XcoreJog{jogSeq}`，消费者按边沿取用（`MOTOR_ALGO_applyRecord`，`34 §9.4`）。纯**信箱**（`CalibResult.pending`，取走即清）用 0/1 标志没这个问题，它的零态就是"没有结果"。

**擦写 Flash 只允许 CPU0、且只在控制任务里**：三核共抢一个 FMU，序列必须 `WDG_serviceCpu()` → `__disable()` → 擦/逐页写 → 回读 → `__enable()` → 再喂一次（`mw/calib/calib_store.c`，`34 §8.2`）。**禁止**用 `IfxScuWdt_serviceCpuWatchdog`（它带 ENDINIT 保护动作，绕过 `bsp/wdg.h` 的统一封装）。CPU1/CPU2 在这几十毫秒里只是 stall，不会复位——前提是链接脚本没把任何代码/常量放进 DF0（当前 `Lcf_*.lsl` 只在 memory 段声明 `dfls0`，属实，改链接脚本要复核）。

**急停类语义不要走普通队列**：需要"不等控制拍"的动作，参考 `XCORE_estopRequest()` 的旁路位模式（`21 §5.3`、`31 §10`）。

## 6. 加一条打印（跨核日志）

ASCLIN0 属主是 CPU0，iLLD ASC 的软件 FIFO 与临界区**只在属主核内互斥**，两个核直接 `printf` 会踩状态（乱码/偶发卡死）。

CPU1/CPU2 打印 = 整行拷进日志环（1 KB，满则整行丢弃），由 CPU0 的 robot 控制任务 `XCORE_logService()` 出环落串口。新代码在 CPU1/CPU2 里**不要**直接调 `uart.c` 的接口。

## 7. 时基

| 需求 | 用什么 |
|---|---|
| CPU0 | FreeRTOS tick（STM0，优先级 2）与任务延时 |
| CPU1 / CPU2 | `bsp/stime.c`：直读 STM0 自由计数，unsigned 减法天然回绕安全；**禁止调 FreeRTOS API**（移植层只绑 CPU0，见 `21 §18 C4`） |

## 8. 排障速查

| 现象 | 第一嫌疑 | 怎么确认 |
|---|---|---|
| 某个核的外设"完全不响应"，无任何报错 | ISR 声明在非 0 号表 → 被链接器删了 | `.map` 的 Removed Sections 搜 `Isr`（§4 步骤 6） |
| 中断进了表但打到错的核 | SRC 的 `TOS` 位没设 / 优先级与别的核撞了 | 读对应 `SRC*` 寄存器；对照 `21 §18 C2` 占用表 |
| AT 链路全超时、三核启动正常 | CPU2 的 ASCLIN1 中断从未触发 | 同第 1 行；再看日志环有没有 RX 计数 |
| 控制台乱码、偶发卡死 | 跨核直接 printf | 全量搜非 CPU0 代码里的 `IfxAsclin`/`UART_` 调用 |
| 跑一段时间后复位 | 该核喂狗断流（robot 任务/1 kHz 环被阻塞或饿死），~1.4 s 后 NMI→软复位（v1.1.2+） | 先看复位前最后一条日志，再确认 `WDG_serviceCpu()` 所在循环是否还在跑（`21 §18 C8`） |
| 打印 `FATAL: stack overflow in task:<名字>` 后复位 | 该任务栈越界（`configCHECK_FOR_STACK_OVERFLOW=1`，上下文切换时检出），钩子已主动断喂自恢复 | 调大该任务 `xTaskCreate` 的栈字数，或把局部大数组移成静态/heap；不要改成忽略 |
| 上电后 ~1.4 s 一到就复位、反复循环 | 该核启了看门狗却没有喂狗点（新加了 `WDG_enableCpu()` 却没在常驻循环里 `WDG_serviceCpu()`；或 `core*_main` 初始化里有超过窗口的长阻塞） | 数复位周期是否≈窗口值；查该核是否已有喂狗循环（`21 §18 C8`）。**不要用"再关掉看门狗"解决**，那是把底线撤了 |
| 整车冻结、不复位也不响应（假死） | **tc275_car < v1.1.2 的固件**：CPU WDT 到期只发 NMI、iLLD 默认空钩子直接返回，复位链未闭合（`21 §7.2` V1.13） | 烧 v1.1.2+（`Configurations/Ifx_Cfg.h` NMI 钩子已接 `IfxCpu_triggerSwReset`）；复现手段 = 台架拔喂狗点/加死循环 |
| C6 一加速就重启 | 5V 供电裕量不足（brownout） | `23 §5`；并加 ≥470 µF |
| 电机一侧转向相反 | `motor.c` 的 `g_dirInvert` 表 vs 实际线序 | `23 §4`，**查表，不要交叉猜测** |
| 遥测速度一直等于指令值（不显示实测） | 编码器 8 线未接/未动过 → `alive=FALSE`，CPU0 回退指令回显 | 手转轮子 ≥1 圈（alive 窗口 500 ms）；台架判向步骤见 `23 §8.4` |
| 手转一圈计数 ≈ 265 而非 ≈ 1061 | 编码器某相未接好，×4 退化成 ×1；或 `g_encInvert` 未按台架结论修正 | 按 `23 §8.4` 步骤 2/3 复测两相计数 |
| SPI 链路"通一帧后就再也不动" | 漏发突发收尾事务（`RDDMA` 后没补 `INT0`、`WRDMA` 后没补 `WR_END`）→ 从机槽位卡死 | 看 `Link_Health.stats` 的 `rdSegments/wrSegments` 是否停止增长；规则见 `21 §18 C10` |
| SPI 握手寄存器读回全 0 / 值不稳定 | ① 前导相位波形从机不认（G1 未过的预期现象）② 单读快照撕裂/魔数读错——**2026-09-27 起这是设计内常态**：泵静默 `LINK_DOWN`、下一好读自愈，不再有重试与 `regUnstable` 计数 | 看 `stats.spiErrors` 与 `state` 是否反复 DOWN↔READY（偶发可忽略）；持续 DOWN 才上逻辑分析仪比 `22 §4.4` 的事务表 |
| **负载越重越容易报失联急停**（"空载正常、满载断连"） | 旧固件双读比对把撕裂读升级成失联的历史根因，2026-09-27 已随泵简化移除（`22 §4.2` V1.6） | 若复现：先看 `SF_ALIVE` 是否真的 500 ms 停走（唯一失联判据）；`ALIVE` 在走而报 LOST 即为新缺陷，按 `22 §5.4` 排 |
| 手机页面能连上但**遥测一个字段都没有**（不是数值 0，是根本不刷新） | 遥测载荷短于 38 B → 从机**整帧丢弃**（`21 §18 C12`）。短载荷的表现是"全无"，不是"部分" | 看 `stats.txFrames` 在涨（说明主机发了）而 C6 侧无 TEL 计数；跑 `test/host/test_sf_telemetry.c`（§1），布局真源是 `mw/sf/sf_telemetry.h` |
| 发了配置/配对命令，车却**动了或停了** | 分派没看 CID，把 `CFG` 的键号 / `PAIR` 的 token 首字节当成命令码执行（`21 §18 C13`） | 看 `stats.cmdUnsupportedCid` 是否在涨（白名单生效的证据）；对照 `22 §5.2` 的五条通道载荷形状 |
| 摇杆推了没反应，但链路"健康" | `DRIVE 0x50` 被**有意拒收**（mm/s→两轮要 §11 运动学 + 编码器闭环，本构建没有） | `stats.cmdUnsupportedOp` 涨即为此因。验链路请改用**离散方向命令**（`0x02` 前进等，只带 op）或 `SET_SPEED 0x10`（±100 百分比，已支持窄化） |
| 链路错误位读出来"时对时错" | `SF_ERRSTAT` 位表与从机不一致（历史上主机侧是臆造值，`22 §2 E13`） | 只认 `22 §4.3` 列出的七位；改过任一侧常量必须重跑 §1 的两份单测 |
| `LINK_gen()`/`LINK_setClock()` 返回 `LINK_GEN_ERR_NOACK` | 回执要跨**两次从机任务调度**才可见（`22 §2 E14`），20 ms 超时偏紧或从机任务被占 | 看 `stats.genWrites` vs `stats.genNoAck`；台架上先确认链路是 `LINK_UP` 再调 `GEN` |
| 想看 SPI 链路状态但没打印 | CPU2 不允许 printf（`21 §18 C3`） | 调试器 Watch 表达式 `g_health`（`com/link.c` 的静态 `Link_Health`，每圈刷新） |
| 闭环行为不对（震荡/响应弱/爬行） | `rt/servo` 增益是**待标定初值**（Kp=0.8 / Ki=0.01/ms / FF=1.0，`21 §5.2`） | 看 CPU0 控制台 1 Hz `SRV=` 行（左/右各 目标/实测/duty，percent×10），按 §15.3 台架整定；**禁止无数据拍脑袋改**。电机不转先看 `SRV=` 里 duty 是否非 0（0 = 目标为 0，或编码器无效时的开环回退路径没把 duty 送出） |
| 某轮"前进却倒转"、闭环越推越快（正反馈） | 该轮 `g_encInvert` 符号与实际相反——闭环的正反馈形态，**先停**再判向 | 四轮离地，发 `0x70` 自动判向：CPU1 逐轮脉冲并翻转符号表，控制台看 `ENCCAL=` 行（invert[0..3] + delta[0..3]，delta=0 = 编码器没计数，查接线）；手动版见 `23 §8.4` 步骤 2 |
| 遥测 `batteryMv` 恒 0 / 读数与万用表对不上 | ① D24A J6-1 → X2-23 线未接（mV 停在 0，块初值）② 基准不符：`ADC_BATT_VAREF_MV=3300` 与 X2-15 实测不符 ③ 节数假设错（`batteryPct` 偏差大但 mV 对） | 万用表三步：量电池 VIN、量 J6-1（应 ≈ VIN/11）、量 kit X2-15（应 ≈3300 mV）；常数集中在 `bsp/adc.h`，改完只重编（`23 §5.5`） |
| 开机没有 `CALIBREC loaded from DFLASH`，而是 `CALIBREC invalid, defaults` | 扇区 15 是空的（首次/擦过）或 blob 的 magic/CRC/范围三关没过（`34 §8.1`）——**这不是故障**，固件按默认值继续跑 | 发 `0x72`，看 EVT `0x23` 的 `src` 与 `crcOk`：默认态 `src=0,crcOk=0`；再发一次 `0x70`（判向成功会自动持久化）或 `0x73`，静止后重启，应当变成 `loaded from DFLASH` |
| `0x70`/`0x73` 之后参数**当场生效但重启就没了** | DFlash 写是**延后**的：目标速度、jog duty、实测轮速三者全为 0 且静止 500 ms 后才真正擦写（`34 §8.3`）；或写入失败——EVT `0x22` 的 `saved` 字节（payload[22]）才是判据：`0` 无需保存 / `1` 已写入 / `2` 失败并会安静重试 | 台架把轮子停稳再等 ≥1 s，看 `0x22` 的 `saved`；持续 `2` 时先怀疑扇区地址与 FMU 状态（`CALIB_SECTOR_ADDR`，`34 §11.4 C1/C2`——DF0 容量 16 扇区还是 48 扇区未定论，且 `Libraries/iLLD/Flash` 在 `.cproject` 里被排除） |
| 发 `0x71` jog 电机不转 | ① 只在 300 ms 内有效，单发一帧必然立刻超时（控制台有 `JOG timeout`，需**持续续约**）② FAULT 或急停生效会拒收 ③ duty 被钳到 ±500（percent×10 = ±50%） | 看 CPU0 控制台 `JOG timeout` 是否刷屏；`SRV=` 行的 duty 列就是实际施加的 jog 值（目标列为 0）；`22 §5.5` 的 DPT 白名单没放行也表现为"发了没反应" |

## 9. 提交前自检（文档同步义务）

- [ ] 改了引脚 → `23` 的表与接线状态一览同步；确认没和 `21 §18 C7` 的固定片选冲突
- [ ] 改了帧/命令/超时数值 → `21 §6` 与（涉及链路时）`22 §5` 同步；**涉及 `mw/sf/` 或 `esp32c6_car/components/c6_sf|c6_proto` 常量/布局的，必须重跑 §1 两份主机单测并贴出断言数**（`21 §18 C11`：文档写"两侧一致"不算验证）
- [ ] 加了 ISR → `21 §18 C2` 优先级表登记
- [ ] 加了**常驻循环 / 长期占核的任务** → 该核看门狗已开（CPU0、CPU1），必须带上 `WDG_serviceCpu()` 喂狗点，且只能用 `bsp/wdg.h` 的那对 clear+set（`21 §18 C8`）
- [ ] 加了跨核通道 → `31 §4` + `21 §5.5`
- [ ] 改了构建/烧录方式 → 本文 §1/§2
- [ ] commit message 用中文（`type:` 前缀可保留英文）
