lilicqyu-ship-it/smartcar/esp32c6_car/doc/13-verification.md

# 13 验证与测试状态汇总

| 项 | 内容 |
|---|---|
| 代码位置 | `test/host/`（Makefile、minunit.h、4 个测试程序） |
| 上游需求 | LLDD §9（测试设计）、编码计划 §5（G1–G4 门） |
| 状态 | 🟡 — **G1 ✅（33/33）/ G2 ✅ / G3 ✅（走查）/ 22 §8 台架门禁 🔴 / G4 🔴** |

## 1. 验证门总览

| 门 | 内容 | 通过标准 | 状态 | 结果 |
|---|---|---|---|---|
| G1 | 主机单测 | 全绿，proto/SF 100% 分支 | ✅ | 33/33（见 §2） |
| G2 | 目标编译 | 0 error / 自研组件 0 新增 warning | ✅ | `idf.py build` exit=0，`esp32c6_car.bin` 1,072,624 B |
| G3 | 静态走查 | 无回调内耗时/无未校验 memcpy/ISR 禁锁 | ✅ | 随编码完成；本轮文档梳理另修 2 缺陷（07 文档 §8） |
| G4 | HIL 台架 | LLDD §9 集成/压力/老化 | 🔴 | 未开始（需双板台架） |

## 2. G1 主机单测清单（test/host，`make check`）

### test_proto（12 项，覆盖 c6_proto 100% 分支）
CRC check 值 0x29B1 · NULL 防护 · 编码回环（4B/0B/64B）· LEN 越界 FMT_ERR ·
VER 错 VER_ERR · CRC 篡改 CRC_ERR · 垃圾再同步 · encode/build 参数校验 ·
遥测编解码回环 · **10⁷ 随机字节模糊** · **5 万轮随机帧+单比特篡改（无误收）**

### test_sha512（4 项）
"abc"（FIPS 例）· 空串 · FIPS 长消息 · 流式 vs 一次性一致（向量经 Python
hashlib 生成核对）

### test_ed25519（4 项）
RFC 8032 向量 1（空消息）· 向量 2（0x72）· dev 密钥端到端（tools/ed25519_ref.py
签名 ⇄ C 验签）· 坏公钥/非规范 s 拒绝

### test_bundle（6 项）
真实签名头逐字节流 · 坏 magic · 坏签名 · 错公钥 · 尺寸不符 · 截断检测

### test_sf（7 项，SF 帧 = SPI 链路容器，tc275_car doc 22 §5）
编解码回环 · 段内多帧 + 4B 补零 · 错误分支（CRC/VER/LEN 越界/垃圾再同步）·
SEQ 严格前进窗口（1..32 含回绕）· 10⁷ 随机字节模糊 · v2↔SF 映射回环
（DRIVE/LINK_STATE/未映射命令）· OTA CHUNK 242B 帧布局（4B 对齐）

## 3. 未实施的单测（LLDD §9 差距）

| 项 | 原因 | 计划 |
|---|---|---|
| 会话表状态机主机测（LLDD §9 层 1） | ws_sessions 依赖 FreeRTOS 互斥，未做抽象 | 抽出无锁核心或上 POSIX 桩 |
| IDF pytest-embedded 目标单测（c6_link 装配/健康、pair 窗口、遥测降频） | 需目标机/模拟环境 | 与 HIL 台架同批 |
| 压力（4 客户端 + 慢客户端 + WS 洪泛 + 上传反复断连） | 同上 | G4 |
| 老化（72h 遥测 + 周期配对 + 30min OTA） | 同上 | G4 |

## 4. G4 HIL 用例清单（从 LLDD §9 与模块文档汇总）

| 用例 | 出处 | 通过标准 |
|---|---|---|
| **22 §8 G1 波形兼容**（TC275 数据字节模拟 CMD/ADDR/DUMMY） | doc 22 R7 | C6 侧 RD_REG/WRDMA 拿到正确字节、事件按预期触发（失败退路：自写从机驱动 / 回退 UART） |
| 22 §8 G3 链路时延 | doc 22 | 触屏→TC275 收到命令最坏 ≤5 ms（含 IRQ 丢失走 2ms 兜底） |
| 22 §8 G4 安全语义 | doc 22 | 拔 C6 电源/断 IRQ/GEN 静默 → ERR_LINK_LOST ≤520 ms、受控停车 ≤100 ms |
| 22 §8 G5 提速阶梯 1→2→5→10→20 MHz | doc 22 | 每档 30 min CRC 误码 0；OTA 1 MB ≤3 s @5 MHz |
| 22 §8 G6 老化 | doc 22 | 72 h 0 意外复位、链路错误计数不增长 |
| 断链 LINK_STATE 时序（拔线） | 08-bridge / FR-5 | ≤10 ms 发出 0x42 |
| 命令端到端时延 | FR-2 | WS→轮 ≤50 ms（SDD 预算） |
| OTA 中继全流程 + 每阶段断电注入 | 08/09 | 回滚 100/100 |
| 自身 OTA 全流程 + PENDING_VERIFY 断电 | 09/01 | 回滚成功、/api/health 可见槽位 |
| 配对窗口/宽限/重连 | 06-pair | LLDD §4.4 时序 |
| Portal 弹窗 + mycar.local 解析 | 05-net | iOS/Android 实机 |
| 4 客户端并发 + 慢客户端降频 | 07-http | 控制端时延不劣化、无堆耗尽 |
| 72 h 老化 | LLDD §9 | 0 泄漏（水位不降）、0 复位 |

## 5. 复现步骤

```bash
# G1（任意 C99 编译器；MSYS2 mingw64 gcc 实测通过）
cd esp32c6_car/test/host && make check

# G2（ESP-IDF v6.1-beta1）
cd esp32c6_car && idf.py build
```

## 6. 台架弱电源缓解（真机 bring-up 记录，2026-09）

台架电源在 Wi-Fi 上电（PHY 校准电流峰，约开机 1 s 处）会瞬间跌落到
ESP32-C6 最低欠压阈值（SEL_7 = 2.51 V）以下，触发 brownout 复位循环。
`main/Kconfig.projbuild` 提供三个台架专用缓解项（生产构建全部保持默认值）：

| Kconfig | 默认 | 作用 |
|---|---|---|
| `C6_BENCH_BOD_DISABLE` | n | app_main 最早处调用 `esp_brownout_disable()`（闪写/RF 校准脱离保证电压窗口，仅台架） |
| `C6_NET_START_DELAY_MS` | 0 | Wi-Fi 启动前延时，让电源从开机浪涌恢复（台架取 300） |
| `C6_WIFI_TX_POWER_QDBM` | 0 | 封顶 TX 功率压低 PA 电流峰，0.25 dBm 单位（台架取 48 = 12 dBm） |
| `C6_BENCH_CTRL` | n | 控制旁路（台架取 y）：①所有 WS 会话免配对直接提升 CTRL——tc275_car 尚无 PAIR 通道消费者，token 流程永远无法完成；②v2 0x50 DRIVE 在 `c6_link` 内翻译为 0x10 SET_SPEED `{left,right}%`（600 mm/s/300 deg/s ≙ ±100%，ω>0=左转）——tc275_car 旧构建对 0x50 计 `cmdUnsupportedOp` 丢弃；③bridge 在链路在线时每 60 ms 注入 0x21 HEARTBEAT——CPU0 100 ms 无心跳即清零轮速，而页面按 21 §6.2 依赖 0x50 兼作心跳。生产构建必须保持 n（tc275_car 落地 0x50 消费后此开关可退役） |

注意：ESP32-C6 的欠压阈值阶梯是**降序**的（SEL_7 = 2.51 V 最低，
SEL_2 = 3.27 V 最高），`sdkconfig.defaults` 中不要写 `..._SEL_2_5V`
（那是 C3/S 系的写法，对 C6 无效）。

串口抓取辅助工具：`tools/serial_sniff.py`（pyserial，复位 + 带时间戳
打印启动日志）：

```bash
idf.py -p COM14 flash
python tools/serial_sniff.py COM14 30
```

## 7. 真机验证记录（手机端，2026-09-26）

台架：C6(COM14) + iPhone，无 TC275（LINK down 为预期，`rollback check`
45 s 告警按设计不动作）。

| 项 | 结果 | 证据 |
|---|---|---|
| assets 分区烧入正式控制页 | ✅ | `build_assets.py` → parttool 写入；启动日志 `c6_assets: assets partition: 3 entries`（替代 embedded fallback） |
| softAP 接入 + DHCP | ✅ | `STA joined (count=1)`、`DHCP server assigned IP ... 192.168.4.2` |
| **captive portal 弹窗** | ✅ | 手机弹 Portal 并加载控制页（修复前探测 URL 返回 404/405，无弹窗） |
| WS 观察态（spectator） | ✅ | `ws fd=47 spectator`，页面 WS 建立并收 hello/0x42 |
| 并发抗压 | ✅（修复后） | captive DNS 劫持手机全部 App 后台探测 → 16 socket 池 ENFILE（`accept(23)` 风暴）→ 池扩 24 + httpd 10 后消失 |

弹窗关闭瞬间页面全部连接被手机 RST（`recv : 104`）为正常现象。
**待 TC275 上电后联调**：配对开窗（车侧键 3 s → PAIR_NOTIFY）→ CTRL
角色 → 摇杆驾驶/遥测端到端（本文档 §4 HIL 项覆盖）。

## 8. 第二控制端联调（S3 遥控器 smartcar_remote，2026-09-29 登记）

🔴 **未开始**。S3 遥控器固件已编译通过（协议自检 CRC check 0x29B1、DRIVE 帧
回环 OK；见其仓库 README），C6 侧经协议面审计**无需任何代码修改**（hello/tc/
pong/err、`?token=` 握手、`/api/pair`、DRIVE 0x50@30 Hz 心跳、TELEMETRY 0x41
全部按 02/06/07 文档既有口径对接）。待两仓同台架联调：配对 → DRIVE/遥测 →
失联停机 → 手机与 S3 双端控制权切换（单 CTRL 互斥）。

## 2026-10-04 · v1.1.2：握手与本地传感器移除回归

- `test/host/test_ws_hello.py`：生产函数的在线广播先于 hello、真实离线、未注册提供者三种路径通过；模拟 iOS applyHello 后在线状态不被固定 down 覆盖。
- `test/host/test_diag.py`：生产 /api/diag 格式化函数输出可解析 JSON，link 状态保留、imu 字段删除；嵌入诊断页 JS 通过 Node --check，ADXL345 UI 删除。两个脚本已纳入 host Makefile check。
- C6 SF 编解码原有 8 项测试（含 1000 万字节随机输入）全部通过；沿用原 Makefile 警告策略，旧测试第 272 行存在带符号比较编译警告。
- ESP-IDF 6.1 完整构建通过，v1.1.2 最终应用大小 0x10dab0；ADXL345 组件和生成 Kconfig 引用均移除。
- v1.1.1 中间镜像曾采集双串口 45 秒：C6 up=1，收发持续增长、crc/format/sequence 计数全 0；TC275 ready，主机 SPI 超时/硬件/事务错误全 0；TC275 旧 CRC/SEQ/队列满是跨 C6 烧录保留的累计值，不能称为当前新错。最终 v1.1.2 实机结果另附。
- 最终 v1.1.2 通过 COM8 烧录，镜像哈希校验通过；双串口再采集 45 秒。C6 四次 10 秒摘要均 up=1，rx_frames_total 从 1116 增至 2778，tx_enqueued_total 从 1506 增至 2921，CRC/格式/序列错误累计计数均为 0；没有 ADXL345 重试或 GPIO 自占用告警。
- TC275 在采集开头出现一次 no SF_READY 的 down/up，随后状态摘要为 ready、1 MHz、error_bits=0，SPI 超时/硬件/事务错误累计均为 0。CRC=13、SEQ=22、队列满=5332 是该主机保留的累计值，本次只获得一个完整摘要，未据此宣称这些计数增量为零。原始记录：C6 build/com8-after-v112.log、TC275 build/diagnostics/com16-after-c6-v112.log。
- 用户重新连接 iOS App 后确认“已恢复在线”。握手状态问题完成真机验证。
