lilicqyu-ship-it/smartcar/tc275_car/rt/encoder.h

#ifndef ENCODER_H
#define ENCODER_H

#include "Ifx_Types.h"

/* MG310 wheel Hall encoders (doc/20-design/23-wiring.md section 8):
 * 13 PPR Hall A/B quadrature, x4 decode here (both edges of both phases)
 * = 52 counts per motor rev; gear 1:20.409 -> 1061.27 counts per wheel rev.
 * 48 mm tyre = 150.8 mm circumference = 0.1421 mm per count.
 * Pins P33.0..P33.7 = X2-28..35. */
#define ENCODER_COUNT              4      /* E1..E4, one per motor */
#define ENCODER_PPR                13u    /* Hall pulses per motor rev */
#define ENCODER_GEAR_NUM           20409u /* gear 1:20.409 */
#define ENCODER_GEAR_DEN           1000u
/* 13 * 4 * 20.409 = 1061.268; the integer math truncates to 1061 (-0.03%,
 * noise next to the 8 ms mean window). */
#define ENCODER_COUNTS_WHEEL_REV   ((uint32)((uint32)(ENCODER_PPR * 4u) * ENCODER_GEAR_NUM / ENCODER_GEAR_DEN))

/* Measured wheel speed that maps to percent*10 = 1000 in the telemetry domain.
 * Default assumes ~1000 mm/s at full command; recalibrate on the bench
 * (doc/20-design/21-software-design.md section 15.3 speed calibration). Since
 * doc 34 SS8.2 this is a runtime variable (0x73 REC_SET / DFlash record), the
 * macro is only its default - the conversion formulas stay untouched. */
#define ENCODER_FULL_SCALE_MM_S    1000

/* Wheel tyre diameter in mm, second runtime speed-conversion parameter
 * (doc 34 SS8.2). MG310 kit tyre is 48 mm (150.8 mm circumference,
 * 0.1421 mm/count); the placeholder this macro replaced was 65. */
#define ENCODER_WHEEL_DIA_MM       48

/* A side is E1+E2 (motors A+B), right side is E3+E4 (motors C+D) - same split
 * as the motor algorithm. */
#define ENCODER_SIDE_LEFT_0        0u
#define ENCODER_SIDE_LEFT_1        1u
#define ENCODER_SIDE_RIGHT_0       2u
#define ENCODER_SIDE_RIGHT_1       3u

/* Per-side health threshold on the published edge ages: an age at or under
 * this still counts as live feedback. One wheel edge is ~0.007 counts per
 * ms per mm/s, so a side creeping at ~1.5 mm/s edges every ~100 ms; anything
 * slower is indistinguishable from standstill anyway. Consumers must demand
 * edges only from a side that is being driven - a parked side has nothing
 * to produce (doc 51). */
#define ENCODER_EDGE_FRESH_MS      100u

void    ENCODER_init(void);                   /* CPU1, after MOTOR_init (GTM CLK0) */
void    ENCODER_task(void);                   /* CPU1 1 kHz step: window, publish  */
void    ENCODER_publish(void);                /* push snapshot through xcore       */
void    ENCODER_getSpeedsMmS(sint32 v[2]);     /* left/right side, mm/s            */
void    ENCODER_getRawCounts(sint32 c[4]);     /* E1..E4 signed x4 counts           */
void    ENCODER_getOdometer(uint32 m[2]);     /* left/right side, mm               */
boolean ENCODER_isAlive(void);                /* edges seen within the alive window */
void    ENCODER_getEdgeAgeMs(uint16 age[2]);  /* left/right side, ms since last
                                                * edge, saturated 0xFFFF (= none
                                                * since boot); per-side health
                                                * primitive, doc 51                */

/* Direction calibration of one wheel's count sign (doc 23 section 8.4):
 * +1 = counts increase when the wheel turns "chassis forward". Runtime-
 * writable so the bench pulse test (0x70 -> motor_algo) flips a wheel
 * without a rebuild; CPU1-only writer, applied by the ISRs immediately. */
void    ENCODER_setInvert(uint8 enc, sint8 sign);
sint8   ENCODER_getInvert(uint8 enc);

/* Speed-conversion parameters (doc 34 SS8.2): runtime-writable so the
 * calibration record can retune the percent and mm/s domains without a
 * rebuild. CPU1-only writer (the record apply path in motor_algo); setters
 * clamp illegal values back to the macro defaults - a DFlash bit flip must
 * never carry a zero divisor into the 1 kHz loop. */
void ENCODER_setFullScaleMmS(sint32 mmS);
sint32 ENCODER_getFullScaleMmS(void);
void ENCODER_setWheelDiaMm(sint32 mm);
sint32 ENCODER_getWheelDiaMm(void);

#endif /* ENCODER_H */
