lilicqyu-ship-it/smartcar/tc275_car/com/link.c

/*
 * link.c - SF-over-SPI link pump, TC275 (CPU2) master side
 *
 * Implements the cycle of doc/20-design/22-link-spi-design.md SS4.2 in the order
 * the document fixes it: register snapshot, then read (higher priority), then
 * write, then liveness. Owner core: CPU2, bare metal, superloop context only.
 */
#include "com/link.h"

#include "com/ota_app.h"
#include "mw/ota/ota_rx.h"
#include "mw/xcore/xcore.h"
#include "mw/diag/diag_wire.h"
#include "bsp/stime.h"

#include <string.h>

/* TX_PENDING above this cannot be a real buffer claim (the slave's whole buffer
 * is smaller), so it is treated as a bad register read and the drain loop is
 * shortened. 640 B is two and a half maximum segments. */
#define LINK_RX_BURST_MAX     640u

/* Rate limit of the "LINK cmdq full" console line: first rejection logs at
 * once, then at most one line per second carries the suppressed count. The
 * counter in Link_Stats stays one-for-one either way - the line is for the
 * human, the counter is for the tripwire. */
#define LINK_CMDQ_FULL_LOG_MS 5000u

typedef struct
{
    uint8 type;
    uint8 cid;
    uint8 len;
    uint8 payload[SF_MAX_PAYLOAD];
} Link_TxSlot;

static Link_TxSlot  g_txq[LINK_TXQ_DEPTH];
static uint8        g_txHead;
static uint8        g_txTail;
static uint8        g_txSeq;

static SF_Parser    g_rxParser;

static uint8        g_reg[LINK_REG_BYTES];
static uint8        g_seg[SPIHAL_MAX_DATA];

static Link_State   g_state = LINK_DOWN;
static uint32       g_aliveSeen;
static uint8        g_aliveValid;
static uint32       g_aliveMs;
static uint32       g_nextPollMs;
static uint32       g_telSeq;            /* E2E counter of the telemetry stream */
static Link_Stats   g_stats;
static Link_Health  g_health;           /* bench watch expression, see link_updateHealth */

static uint8 link_txNext(uint8 idx)
{
    return (uint8)((idx + 1u) % LINK_TXQ_DEPTH);
}

/* ---- register file --------------------------------------------------------- */

static uint32 link_reg(const uint8 *snap, uint8 ofs)
{
    return SF_getU32(&snap[ofs]);
}

static boolean link_readRegs(uint8 *snap)
{
    /* One transaction for the whole 24 byte window. Espressif's own master
     * driver only ever reads four bytes per RDBUF (essl_spi.c:essl_spi_rdbuf),
     * so a multi word block read is on the G1 measurement list; if the slave
     * answers that with garbage this function is where it shows up. */
    return (boolean)(SPIHAL_transaction(SPIHD_CMD_RDBUF, LINK_REG_READY, NULL_PTR,
                                        snap, LINK_REG_BYTES, TRUE) == SPIHAL_OK);
}

/* One RDBUF read per cycle, used defensively instead of being trusted blindly.
 *
 * The slave rewrites its register file whenever a segment completes or its
 * 10 ms ALIVE tick fires, so a value read here can legitimately be torn or a
 * few hundred microseconds stale. The previous double-read-and-compare turned
 * exactly that into regUnstable, and regUnstable into LINK_LOST + e-stop -
 * with a busy link the compared fields (TX_PENDING, RX_ROOM) change all the
 * time, so the faster the link ran, the more often the master declared it
 * lost: the "works idle, dies under load" field failure. The consumers now
 * tolerate what a single read can produce:
 *   READY      static while the slave is up; a wrong value reads as LINK_DOWN
 *              and the next good read recovers through the READY edge
 *   TX_PENDING clamped to LINK_RX_BURST_MAX in link_drainRx (pre-existing)
 *   RX_ROOM    clamped to LINK_RX_ROOM_MAX in link_cycle
 *   ALIVE      meaningful even when torn - and it is the only truth source
 *              for liveness (LINK_ALIVE_TIMEOUT_MS), never the snapshot */
static boolean link_snapshot(void)
{
    g_stats.polls++;
    if (!link_readRegs(g_reg))
    {
        g_stats.spiErrors++;
        return FALSE;
    }
    return TRUE;
}

/* ---- receive path ---------------------------------------------------------- */

/* CID first, payload byte second.
 *
 * c6_link puts the v2 command byte in payload[0] for the DRV/DIAG/DPT families,
 * but for CFG and PAIR it copies the v2 payload verbatim and lets the CID carry
 * the identity of the message (esp32c6_car components/c6_link/link.c:v2_to_sf). A
 * dispatch that assumed "payload[0] is always a command" would therefore execute
 * a configuration key or the first byte of a pairing token as if it were a drive
 * command - the one mistake on this link that can move the car.
 *
 * Of the three command-bearing channels, this build consumes one:
 *   SF_CID_DRIVE  {u8 op, i16 v, i16 w}      op is a v2 code, and doc 21 SS6.2
 *                                            keeps 0x01..0x32 identical to the
 *                                            demo command set, so op crosses
 *                                            over unchanged. v/w are only filled
 *                                            for 0x10 SET_SPEED (two +-100
 *                                            targets, doc 11 SS7: +100 is full
 *                                            speed, so the i16 narrows to the
 *                                            demo's sint8 with nothing lost) and
 *                                            for 0x50 DRIVE (v mm/s, omega deg/s
 *                                            per second), which link_driveSpeeds
 *                                            mixes into two wheel percents and
 *                                            forwards as SET_SPEED - CPU0's
 *                                            ROBOT_cmdSetSpeeds already accepts
 *                                            an arbitrary differential. The mix
 *                                            normalises at 600 mm/s / 300 deg/s
 *                                            (the joystick's full deflection,
 *                                            esp32c6_car assets_src/app.js) instead of
 *                                            waiting for the SS11 kinematics in
 *                                            physical units; the closed loop
 *                                            still lives on CPU1 (motor targets
 *                                            from CPU0 are percent x 10).
 *   SF_CID_DIAG   {u8 op, ...}               op 0x53 / 0x42; CPU0 consumes
 *                                            0x53 sub 0x24 (version request
 *                                            -> immediate EVT 0x24/0x25)
 *   SF_CID_DPT    {u8 op, ...}               op 0x70..0x79, the bench
 *                                            calibration/DFlash-record family
 *                                            (doc 34 SS9); results and record
 *                                            echoes come back as TYPE_EVT CIDs
 *                                            0x22 / 0x23 on the event outbox
 * The last two go to CPU0 as op + remaining bytes, which is what the demo path
 * did over UART; CPU0's switch ignores codes it does not know, and the counters
 * here say what was seen.
 */
#define LINK_DRV_PAYLOAD_LEN  5u   /* {u8 op, i16 v, i16 w}, 22 SS5.5 */

/* v2 code for the joystick stream (doc 21 SS6.2). It is not in protocol.h,
 * which is the demo's UART command table and stops at 0x32. */
#define LINK_OP_DRIVE           0x50u

/* Full-deflection anchors of the joystick mix: 600 mm/s and 300 deg/s both
 * normalise to 100 % (esp32c6_car assets_src/app.js joyMove). Sign convention:
 * w > 0 is CCW (left turn), so the right wheel gets the +w share. */
#define LINK_DRIVE_V_FULL       600
#define LINK_DRIVE_W_FULL       300

static sint8 link_narrowPercent(uint16 raw)
{
    sint16 value = (sint16)raw;

    if (value > 100)
    {
        value = 100;
    }
    else if (value < -100)
    {
        value = -100;
    }
    return (sint8)value;
}

/* 0x50 DRIVE {v mm/s, w deg/s} -> {left,right} percent, the payload shape of
 * SET_SPEED that CPU0 already executes. Arcade mix, clamped to +-100 per side
 * so a full-speed-full-turn command pivots instead of wrapping. */
static void link_driveSpeeds(sint16 v, sint16 w, uint8 *out)
{
    sint32 lPct;
    sint32 rPct;

    lPct = ((sint32)v * 100 / LINK_DRIVE_V_FULL) - ((sint32)w * 100 / LINK_DRIVE_W_FULL);
    rPct = ((sint32)v * 100 / LINK_DRIVE_V_FULL) + ((sint32)w * 100 / LINK_DRIVE_W_FULL);

    if (lPct > 100)
    {
        lPct = 100;
    }
    if (lPct < -100)
    {
        lPct = -100;
    }
    if (rPct > 100)
    {
        rPct = 100;
    }
    if (rPct < -100)
    {
        rPct = -100;
    }

    out[0] = (uint8)(sint8)lPct;
    out[1] = (uint8)(sint8)rPct;
}

/* Queue one command for CPU0, with the e-stop bypassed ahead of the queue.
 *
 * SET_SPEED rides XCORE_cmdPushLatest: it is the carrier of the 30 Hz
 * joystick/heartbeat stream, where each frame supersedes the previous one, so
 * a burst of stale copies (the C6 packs its whole backlog into one 512 B
 * segment after any pump stall) collapses into the latest position instead of
 * overflowing the queue. Every other command keeps strict FIFO - for one-shot
 * and safety commands the ordering is part of their meaning. */
static void link_forward(uint8 cmd, const uint8 *data, uint8 len)
{
    XcoreCmdMsg msg;
    boolean     queued;
    boolean diagnostic=(boolean)(cmd==PROTO_CMD_DIAG && len && data && data[0]==DT_SUB);

    if (len > LINK_CMD_DATA_MAX)
    {
        /* No truncation: a command wider than the CPU0 mailbox is a protocol
         * mismatch and must be visible, not quietly shortened. */
        g_stats.cmdOversize++;
        if(diagnostic) {
            uint8 reject[DT_FRAME_MAX];
            uint8 n=DT_rejection(reject,data,len,DT_BAD_LENGTH,STIME_nowMs());
            if(n) (void)LINK_send(SF_TYPE_EVT,DT_CONTROL_CID,reject,n);
        }
        return;
    }

    if (cmd == PROTO_CMD_EMERGENCY_STOP)
    {
        /* Bypass the queue depth and the CPU0 control period: the e-stop is
         * latched by CPU0 on the next read of the shared block either way. */
        XCORE_estopRequest();
    }

    msg.cmd = cmd;
    msg.len = len;
    if (len > 0u)
    {
        memcpy(msg.data, data, len);
    }

    queued = diagnostic ? XCORE_diagCmdPush(&msg) :
        ((cmd == PROTO_CMD_SET_SPEED) ? XCORE_cmdPushLatest(&msg) : XCORE_cmdPush(&msg));
    if (queued == FALSE)
    {
        /* Rejection is still counted one-for-one (the counter is the tripwire
         * the LINKDBG line carries), but the log line is rate limited: with
         * coalescing above this only fires on genuinely diverse traffic, and
         * one line per rejected command used to be its own congestion
         * amplifier - CPU0 burned a full ring drain printing the burst while
         * the queue it was complaining about stayed full. */
        static uint32 s_lastLogMs = 0u;
        static uint32 s_lastCount = 0u;
        static boolean s_everLogged = FALSE;
        uint32 nowMs = STIME_nowMs();

        g_stats.cmdRejectedQueue++;
        if(diagnostic) {
            uint8 reject[DT_FRAME_MAX];
            uint8 n=DT_rejection(reject,data,len,DT_BUSY,nowMs);
            if(n) (void)LINK_send(SF_TYPE_EVT,DT_CONTROL_CID,reject,n);
        }
        if ((s_everLogged == FALSE) ||
            ((uint32)(nowMs - s_lastLogMs) >= LINK_CMDQ_FULL_LOG_MS))
        {
            uint32 suppressed = g_stats.cmdRejectedQueue - s_lastCount;
            XCORE_LOG_FIELDS("[LINK_COMMAND]", XL_U("uptime_ms", nowMs),
                XL_U("rejected_since_last_log", suppressed),
                XL_U("rejected_total", g_stats.cmdRejectedQueue));
            s_everLogged = TRUE;
            s_lastLogMs  = nowMs;
            s_lastCount  = g_stats.cmdRejectedQueue;
        }
        return;
    }
    g_stats.cmdForwarded++;
}
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
