lilicqyu-ship-it/smartcar/(commit log)

2026-08-16 Add FreeRTOS support and configuration for AURIX TC275
    - Updated Ifx_Cfg.h to include FreeRTOS syscall handler configuration.
    - Implemented a blinky task in Cpu0_Main.c to toggle an LED using FreeRTOS.
    - Created FreeRTOSConfig.h with necessary configurations for FreeRTOS.
    - Added port.c and portmacro.h for FreeRTOS kernel support on AURIX TC275.
    - Introduced a launch configuration for debugging with TASKING.
    - Added .gitignore to exclude TASKING debug files.
    - Removed obsolete opencode.jsonc file.
2026-08-16 Add UART functionality and integrate with FreeRTOS for serial output
2026-09-25 Add WiFi car control modules and organize into layered structure
    - Bsp/: ASCLIN0 UART driver, GTM PWM + TB6612 motor driver
    - Middleware/: ESP8266 WiFi AT driver, binary protocol frame parser
    - App/: robot motion control logic driven by protocol commands
    - Cpu0_Main wires FreeRTOS tasks (blinky/echo/ESP8266) to all layers
    - Move requirement.md/wiring.md into doc/
    - Register App/Bsp/Middleware in .cproject include paths
2026-09-25 Replace esp8266 driver with wifi_at on CPU2, move AT UART to P11.12/P11.10 and update docs
    - Add Middleware/wifi_at (ESP32-C6 esp-at driver, ASCLIN1) running bare-metal
    on CPU2, plus xcore cross-core helpers, Bsp/stime and App/motor_algo
    - Move ASCLIN1 pins from P15.0/P15.1 to X1 header P11.12 (TX) / P11.10 (RX),
    confirmed against LITE kit manual and iLLD pin map
    - Add README, architecture and getting-started docs; update wiring.md with
    TC275 LITE kit power supply details and new AT UART wiring
    [Cpu0_Main.c, Cpu1_Main.c, Cpu2_Main.c, motor_algo.c, motor_algo.h, robot.c, stime.c, stime.h]
2026-09-25 fix(wifi): route CPU2 ASCLIN ISRs through shared vector table 0
    The Tasking lsl only collects inttab0 entries into the shared table at
    0x801F4000 (__INTTAB_CPUn are all the same address), so the inttab2
    entries of IFX_INTERRUPT(fn, 2, prio) were discarded as unreferenced by
    the linker. iLLD Asc pumps TX/RX inside its ISRs, so the ESP32-C6 AT
    link was completely dead (no TX, no RX, AT TIMEOUT on every command).
    Declaring the ISRs on table 0 still routes them to CPU2 via the SRC TOS
    bit; priorities 5/7/10 avoid CPU0's 1/2/4/8/12. Verified: all boot AT
    commands now answer OK. Also move the AT UART pins back to
    P15.0(TX)/P15.1(RX) from the short-lived P11.12/P11.10 assignment.
    [Cpu2_Main.c]
2026-09-25 docs: sync AT pins to P15.0/P15.1 and record vector-table pitfall
    architecture.md documents why CPU-owned ISRs must still be declared on
    vector table 0 with this lsl layout. requirement.md gains the F09
    hardware-watchdog caveat (SW watchdog only, HW WDT off during bring-up)
    and the 0x08/0x09 ROTATE_LEFT/RIGHT split that protocol.h already
    implements; wiring/getting-started/README follow the pin revert.
2026-09-25 fix(wifi): 冒号仅在 +IPD 帧头作为分隔符，事件行不再被截断
    esp-at 事件行本身带冒号（如 +STA_CONNECTED:"192.168.4.2"），原解析器
    把任意冒号当作 IPD 帧头结束符，会将事件行截断、尾字节泄漏成垃圾行。
    现改为先累积到换行，仅 "+IPD," 前缀行的冒号才结束帧头。
    同时跳过空 CR LF 保活行，不再打印空的 "ESP-C6<- " 前缀。
2026-09-26 docs(量产基线): 以 SDD V1.2 为唯一设计基准重建 doc 体系
    量产开发起点确立：production-software-design.md 升 V1.2 并成为 doc/ 基准，
    其余文档按"现状/需求/接线真源/问题基线"重新定位，消除 UART/esp-at 与
    SPI/SF 两套口径混写导致的歧义。
    - SDD V1.2：板间主链路 UART→SPI（QSPI3 主 ↔ C6 SPI2 从 + IRQ），LINK 段改
    新定 SF 帧、手机段保留 v2 帧；新增 §18 工程级实现约束（0 号向量表、ISR
    优先级全局分配、串口属主、SLSO5 唯一片选等 demo 实测铁律）；§3.7/§5.6/§6
    等 20 余节同步；上游文档行改写为文档定位表
    - spi-link-design.md：SF 帧详细设计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
2026-09-26 docs(基线清理): 删除被 SDD 与 c6_car/doc 取代的三份历史文档
    - ux-performance-plan.md：卡顿根因与 Track B（C6 网络协处理器 + 帧链路）结论
    已全部并入 SDD §3.5/§11/§14，独立文档不再维护，避免与基准双写漂移
    - esp32c6-fw-design.md / esp32c6-fw-coding-plan.md：C6 固件 LLDD 已随自研工程
    落到 c6_car/doc/，本仓库只保留板间接口侧（spi-link-design.md）
    三份内容上一提交已入历史，需要时可从 0046b4a 取回。
2026-09-26 docs(架构): doc 按域重编号并补齐索引/开发指南/C6 文档地图
    编号规则 NN-名称，十位=域：0x 入口、1x 产品、2x 设计与硬件（跨板）、
    3x TC275、4x ESP32-C6、5x+ 预留生产质量。git mv 保留历史。
    - 新增 00-index.md：文档地图、真源职责表、冲突裁决顺序（21>23>22>32/31>11>12）、
    五条阅读路线、防漂移维护规则、已知缺口 G1~G5
    - 新增 30-tc275/32-tc275-dev-guide.md：环境/构建/烧录、新增中断六步流程
    （含 .map Removed Sections 必查）、跨核消息步骤、排障速查、提交前自检
    - 新增 40-esp32c6/41-c6-docs-map.md：两仓库分工边界、c6_car/doc 00~13 索引与
    对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
2026-09-26 fix(wifi): HTTP keep-alive，回复固定到 +IPD 来源链路并降噪日志
    - HTTP 响应改为 Connection: keep-alive，手机 50ms 轮询心跳不再每请求
    重建 socket（也就不再逐请求刷 CONNECT/CLOSED 事件）
    - 记录最近 +IPD 的 esp-at link id，AT+CIPSEND 回到同一链路；换链路时
    主动关闭旧链路，避免连接堆积；自身替换产生的 CLOSED 不再误报掉线
    - AT 命令成功不再打日志，仅失败时输出；RX 帧日志复用行缓冲
2026-09-26 feat(link): CPU2 量产 SPI 链路（QSPI3 主机 + SF 帧）与 USE_SPI_LINK 双构建
    按 doc/20-design/22-link-spi-design.md 落地板间量产链路的 TC275 侧：
    - Middleware/sf：SF 帧编解码与 38 字节遥测载荷（对齐 C6 侧 v2 解码器），
    纯 C99、无 OS/iLLD 依赖、显式小端
    - Middleware/com：QSPI3 半双工事务的引脚/HAL 层与链路 pump（寄存器文件
    READY/TX_PENDING/RX_ROOM/ALIVE/ERRSTAT/CMDRSP/GEN，22 SS4）
    - Cpu2_Main.c：USE_SPI_LINK 编译开关挂载量产链路，默认仍走 AT 演示链路
    直到门禁 G1 过台架；SPI 模式 20ms 聚合遥测，字段与演示 0x40 应答一致
    - test/host：SF 帧编解码主机端单测（out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
2026-09-26 feat(encoder): CPU1 霍尔编码器 ×4 测速落地（GTM TIM0 TIEM 边沿中断 + 软件正交）
    参考 WHEELTEC TB6612 编码器教程（霍尔 A/B 相位差判向、固定窗口计数测速）
    实现 MG310 ×4 编码器解码，按 23-wiring §8 的引脚规划（P33.0~7 = X2-28~35）：
    - Bsp/encoder：八通道 GTM TIM0 TIEM 双边沿 + NEWVAL 中断（优先级 16~23，
    TOS=CPU1，0 号共享向量表），ISR 内按 4x 正交表解码并累加计数；
    1 kHz ENCODER_task 做 8 ms 中值滑窗 → mm/s（轮径 65 mm 待台架标定）、
    里程、alive 检测，经 xcore 出遥测
    - 原设计的 'TIM UDC 硬件正交' 无法实现：TC275 GTM 为 gen3，无 UDC 寄存器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
2026-09-26 fix(link): 按已烧录 C6 固件逐行对齐 SPI 契约
    C6 侧现在跑的是真从机，把主机侧"文档承诺的一致"换成"编译从机源码验证的一致"，
    纠正 3 处常量与 2 处行为缺陷：
    - sf_frame.h：删除从机没有、零引用的 SF_FLAG_RESYNC(0x04)。FLAGS 参与 CRC，
    主机私有个 bit 只会变成 CRC/FMT 不匹配；bit2..7 保留必须发 0。
    - 遥测改为完整 38 字节 SF_Telemetry + LINK_sendTelemetry()：从机 sf_to_v2 的
    接受条件是"CID 正确且长度 >= 38"，短载荷不是少几个字段而是整帧丢弃。
    原 6 字节正是这个故障形态。有真源的只填 uptime/state/faultCode/fwVer/
    linkErrRate，其余显式 0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
    [Cpu2_Main.c, test_sf_telemetry.c]
2026-09-26 docs(设计): 回写 C6 契约对齐结论，新增证据 E13/E14、风险 R12 与铁律 C11~C13
    - 22 号 V1.2：E13（两侧常量表三处不一致）、E14（GEN 回执跨两次从机任务 +
    CLOCK_SET 载荷单位是 MHz）；§4.3 补 SF_GEN 寄存器、ERRSTAT 位真值表、GEN 时序；
    §5.1 FLAGS 三位表；§5.2 五条 CMD 载荷形状表并修正 OTA CID——CFG(0x52)/PAIR(0x51)
    首字节是键号/token 而非命令码，不能假设首字节可派；§5.5 三层白名单、38 字节硬契约、
    急停在 38B 布局无独立槽位（读 state=0x0A）；§7.2 实施状态；§9 新增 R12
    - SDD V1.2b：§6.1a FLAGS 更正、§6.1c 事务表重写、§6.3 改为带偏移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
2026-09-26 refactor(目录): 按 SDD §3.4 目标态重排工程，include 改为工程根模块路径
    demo 布局 App/ + Middleware/ + Bsp/ 迁入 SDD §3.4 目标态（M1 的目录项）：
    - App/robot.* -> app/
    - App/motor_algo.* -> rt/ Bsp/encoder.* -> rt/
    - Middleware/com/* -> com/ Middleware/wifi_at.* -> com/
    - Middleware/protocol.* -> mw/proto/ Middleware/sf/* -> mw/sf/
    Middleware/xcore.* -> mw/xcore/
    - Bsp/{motor,uart,stime}.* -> bsp/
    - Cpu*_Main.c 与 Configurations/ 留在工程根
    配套改动：全部内部 include 改为工程根限定的模块路径（"com/link.h"、
    "mw/sf/sf_frame.h"），因此 .cproject 四个构建配置只需保证工程根在 include
    路径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
2026-09-26 docs(设计): 22 号升 V1.3，路径随目录重排同步并登记 IDE 构建闭合
    - §7.1/§7.2/E9/E14 的 TC275 侧路径写法由 Middleware/{com,sf}/ 改为 com/、mw/sf/
    - 交付状态：TASKING IDE Debug 配置构建链接闭合（0 错误），达成过程中修掉
    rt/encoder.c 的 int32→sint32（该文件此前从未被 TriCore 编译过）；
    原"未做：一次 IDE 构建确认链接闭合"销项，§11 第 1 问前置解除
    - 仍**未做**：G1 台架波形验证、整车通电联调
2026-09-26 feat(link): 默认启用 SPI 链路并同步无外部上拉文档
2026-09-26 fix(link): SPI 相位改为 trailing 边沿采样并降慢 CS/数据沿速率
    iLLD 默认 shiftTransmitDataOnLeadingEdge 实际映射 ECON.CPH=1，即从机侧
    mode 1，旧注释误认为等于 SPI mode 0。ESP32 GPSPI2 从机在 mode 0 于上升沿
    采样，主机须在 trailing 边沿移出数据；默认配置下整帧错位一个 bit，SF CRC
    全部拒绝，链路无法建立（实测）。
    同时 CS 沿 Speed4->Speed1、数据沿 Speed4->Speed3：跳线 + 单根地线的台架
    接线下，过快的 CS 沿曾导致从机计数幻影 bit。
    [spi_hal_pins.c]
2026-09-26 feat(link): 新增 CPU2 链路诊断输出 LINK_diagPrint 与 XCORE_logu
    - xcore 增加 XCORE_logu()：无 printf 的核（CPU1/CPU2）可用 label=v0 v1...
    格式输出一行十进制诊断值，放不下的整行丢弃，与 XCORE_log 一致
    - link 增加 LINK_diagPrint()：只读 LINK_main 维护的健康快照加实时 IRQ
    电平，不触碰总线和泵时序，按 500ms 周期经 xcore 日志桥打到 ASCLIN0，
    输出 LINKDBG= 状态/寄存器/错误计数 14 个字段，供台架观察链路状态
2026-09-26 chore(ide): 同步调试 launch 配置的会话/内存映射 ID
2026-09-26 link: robust SPI link diagnostics and reconnect SEQ resync
    - LINK_diagPrint: suppress steady-state spam, print on state/error change, tag error lines LINKERR=, add 4 TX-side counters (wrSeg/txFrames/txQFull/rdSeg)
    - xcore log ring/line limits raised to fit the 18-field diag line
    - link_cycle: on a fresh LINK_READY edge, hand the slave a GEN RESET_LINK and restart local TX SEQ so an independent power-up/reconnect re-locks the slave SEQ window instead of getting rejected
    [link.c, xcore.c, xcore.h]
2026-09-26 feat(link): 0x50 DRIVE 摇杆混控为轮速百分比并令驾驶命令兼作心跳
    link_dispatch 对 0x50 DRIVE 不再拒收：link_driveSpeeds 以摇杆满偏锚点
    (600 mm/s / 300 deg/s ≙ ±100%) 混控为左右轮百分比，按 SET_SPEED 的
    2 字节容器入队；protocol.c 对 STOP/方向档/SET_SPEED 一律喂
    ROBOT_cmdHeartbeat，避免 100 ms 看门狗在 30 Hz 摇杆流命令间隙清零轮速。
    21 §5.5 与 22 §5.5 文档同步。
2026-09-26 docs(design): 新增 TC275↔C6 SPI 链路交互图（archify 序列图）
    四段覆盖完整交互：启动/SEQ 重同步、命令下行、遥测上行、GEN 与判活。
    内容与两侧固件（com/link.c、c6_car c6_link/link.c）及 22 V1.5 逐项核对；
    HTML 为 archify showcase 校验产物，JSON 为可再生成的图源。
2026-09-26 ci: 新增 GitHub Actions——主机单测与 tag 驱动发布
    ci.yml：push/PR 触发，gcc 跑 SF 帧编解码单测与 38B 遥测交叉单测
    （直接编译公有仓 esp32c6_car 的 proto_frames.c 锁跨侧布局），
    并校验交互图 JSON；workflow_call 供发布复用。TASKING 固件构建
    是专有工具链，无法上托管 runner，不在 CI 范围。
    release.yml：推送 v* tag 触发，先复用 CI 测试再发布 GitHub
    Release；0.x 按仓库版本口径自动标 prerelease，不附固件二进制。
2026-09-26 fix(link): 链路泵简化——单读快照、LOST 只看 ALIVE、移除重同步活锁
    台架"无法连接"类故障的主机侧根因修复(配套 c6_car doc/14 V1.1 §9):
    - 寄存器快照从"双读比对 4 决策字段,3 次不一致即 LOST+急停"改为
    单次连读+钳位容错。从机段完成/10ms ALIVE 跳变都会即时改写寄存器,
    链路越忙比对越容易失败——负载越重越容易误判失联急停,是"空载
    正常、满载断连"的根因。READY 魔数不对改为静默 LINK_DOWN(下周期
    好读即恢复);RX_ROOM 新增 LINK_RX_ROOM_MAX=1024 钳位;LOST 只由
    ALIVE 500ms 停走判定,电机停止仍由 CPU0 的 100ms 心跳看门狗兜底。
    - 移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
    [link.c, link.h, test_sf.c]
2026-09-26 fix(test): test_seq_relock 移除未使用变量 f(-Werror 挂 CI)
    [test_sf.c]
2026-09-27 feat(telemetry): 遥测填 vMeas/odoSession——编码器物理域经 xcore 出车速显示(F03)
    F03"里程与速度显示"的缺口不在编码器也不在显示端:rt/encoder 早已算出
    mm/s 轮速与左右里程,但 xcore 只传 percent×10,物理单位出不了 CPU1,
    CPU2 遥测的 vMeasL/R、odoSession 只能按 SDD §6.3 填 0,手机页面因此
    一直没有实测车速。本次打通这最后一公里:
    - mw/xcore:编码器共享块改 XcoreEncoder 快照(百分比域 + 物理域 mm/s +
    左右侧里程 + alive),一次加锁整体发布/读取,XCORE_encoderPublish/Read
    取代 Set/Get;新增 XCORE_logi(XCORE_logu 带符号版,负轮速需要,
    幅值经 uint32 计算避免 INT32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
2026-09-27 docs: 同步链路泵简化口径，文档版本升至 SDD V1.6 / 22 V1.6 / 23 V1.11
    - 00-index 登记本轮口径变更：寄存器快照改单读+消费端钳位、失联判定只由 SF_ALIVE 500 ms 承担、SEQ 越窗 8 帧重锁，并登记 GitHub Actions CI 已建
    - 22 号文档回写 com/link.c ae10aac：§4.2 双读比对废弃、§4.3 RESET_LINK 降级、§5.3/§5.4 SEQ 重锁、断言数同步 2873
    - README/21/23/31/32/41 及时序图版本引用全量同步
2026-09-27 feat(wdg): 启用 CPU0/CPU1 硬件看门狗，栈溢出钩子改为上报后断喂复位
    关闭评估报告 §6 的两条 🔴（跑飞无自恢复、栈溢出被静默吞掉）：
    - 新增 bsp/wdg.h（header-only）：WDG_enableCpu/WDG_serviceCpu。窗口
    REL=0xF800，换算锚点是官方 Infineon Watchdog_1_KIT_TC275_LK 的
    0xE000≈1.3 s，实测约 0.3~0.5 s（待台架确认后收紧到 §7.1 的 ≤200 ms）。
    - 喂狗写成 ENDINIT clear+set 平衡对，不用 IfxScuWdt_serviceCpuWatchdog()：
    ENDINIT 是饱和计数器，纯 set 每次 +1，16 次后单次 clear 再也解不开，
    量产 Flash/OTA 解锁会静默卡死。
    - 喂狗点：CPU1 在 MOTOR_ALGO_run() 的 1 kHz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
2026-09-27 feat(rt): F02 速度闭环 servo + 0x70 台架自动判向（SDD §5.1/§5.2）
    - 新增 rt/servo：每侧 PI（前馈 FF_GAIN + Kp + 抗饱和积分限幅 ±30% duty
    + 输出钳位 ±1000 与输出死区），全链统一 percent*10 量纲，物理 mm/s 只经
    ENCODER_FULL_SCALE_MM_S 进入。编码器 alive 无效时整侧回退开环斜坡并清
    积分——这是 8 根编码器线未接也能安全上车的前提。
    增益 Kp=0.8/Ki=0.01/ms/FF=1.0 为待标定初值（§15.3 台架整定，无数据禁改）。
    - rt/motor_algo 演进为任务属主：目标斜坡 → servo 出 duty → BSP；急停、
    150 ms 失联看门狗、刹车语义不变；新增 1 Hz SRV= 台架行（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
2026-09-27 docs: 同步 F02 闭环与看门狗两拨改动，SDD 升至 V1.8
    设计基准（21）：
    - V1.7 口径：§5.2 rt/servo 控制结构与回退、§5.1 判向转正 + 0x70、
    §6.3 遥测 vTargetL/R 转 ✅、§17 motor_algo 拆分进度。
    - V1.8 新增：§7.2 补"demo 现状"四级表（CPU0/CPU1 已启用、SM/CPU2 有意
    关闭并各附理由、复位后安全态链路、复位窗口换算锚点与 OCD 挂起说明）；
    §18 C8 整条改写为看门狗铁律，含 ENDINIT 饱和计数陷阱（喂狗只许走
    bsp/wdg.h 的 clear+set 平衡对）；§7.1 表下新增口径更正——"复位期间
    STBY 上电默认拉低保证电机断电"与实物不符（D24A STBY 由跳线接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
2026-09-27 docs(ai): 新增 33 号 AI 协作指南并在 AGENTS/GEMINI 建立入口
    - doc/30-tc275/33-ai-codebase-guide.md：代码地图、跨核数据流与三段单位域
    （±100 / ±1000 / mm/s）、三条高频改动路径的正确改法、安全机制现状、
    验证命令与 9 条红线速查、硬件事实速查；现状口径已含 servo 闭环、
    CPU 看门狗、0x70 判向，并诚实标注与 50 号评估快照的差异。
    - AGENTS.md / GEMINI.md 增"AI 作业前必读"一节指向它，摘要五条最关键红线。
    - 00-index 的登记行（V1.6 / §2 表 33 号）已随上一 docs 提交入库。
2026-09-27 chore(gitignore): 50-tech-assessment.md 不入库
    第三方评估快照按外部文件保留在工作区（§6/§5 处置回执只作本地追溯），
    不进仓库，避免被当成设计基准引用；真源仍是 21（SDD）。
2026-09-27 feat(adc): F04 电池电压采集落地——VADC G0 CH4 采样经 xcore 出遥测
    - 新增 bsp/adc.c/.h（CPU1 属主）：D24A J6-1 电池分压（R13 10k/R15 1k =
    VIN/11）接 kit X2-23 = AN4 = VADC G0 CH4；iLLD 询问式单发转换（12 bit、
    右对齐、wait-for-read），1 kHz 环里每 10 tick 采一次（100 Hz，单次 ~3 µs）
    + 1/16 EMA，超时用有界自旋（2000 次）保证 VADC 死了也不会吊死电机环。
    上电先灌一个真实样本，避免首帧遥测是"从 0 爬上来"的尾巴。
    - 量程换算常数集中在 adc.h：VAREF=3300 mV（本 kit 模拟轨为 VEXT 3.3 V，
    故 LOSUP 同步选 3V）、分压比 x1000、节数 3S。**VAREF 需台架用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
2026-09-27 feat(calib): 34 号标定/DPT 落地——结果回传、DFlash 记录、0x71~0x74 与 EVT 0x22/0x23
    - xcore 新增四块（跨核仍只走 mw/xcore 单锁）：CalibResult 信箱（CPU1 发
    DONE/ABORT/BUSY，CPU0 单次 take）、per-motor jog（duty + jogSeq，CPU0 写、
    CPU1 消费并超时清零）、RecordLive（version 随整块自增，消费侧廉价轮询不漏更
    新）、EVT outbox 环形队列（CPU0 推、CPU2 peek+pop，TX 满时下一 tick 重试同
    一帧而非丢弃）。
    - 新增 mw/calib：calib_record 纯 C99 编解码（20 B DFlash blob + EVT 0x22/0x23
    构造，magic/版本/CRC16/量程三重校验，任一失败一律落默认值 src=0）；
    calib_store 为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
2026-09-29 Initial commit: smartcar remote controller firmware
    ESP32-S3-LCD-EV-Board based remote controller for smartcar,
    with LVGL UI (home/link/ctrl/settings screens), proto frame
    protocol, host-side proto tests and design docs.
    [partitions.csv]
2026-09-29 ci: add ESP-IDF build gate + firmware size/resource-margin report
    - .github/workflows/ci.yml: esp32s3 build in espressif/idf:v6.1
    container from sdkconfig.defaults (compile gate), firmware artifact
    upload, host proto tests (G1)
    - scripts/ci_size_report.py: markdown report of app image vs partition,
    total flash, DIRAM/IRAM/RTC used/free percentages into the job
    summary; fails past gates (app >90% partition, static DIRAM >95%)
    - README: CI badge + CI section
    [ui_joystick.c]
2026-09-29 fix(config): apply true 240 MHz + XIP-from-PSRAM for RGB bounce path (R-10)
    Root cause of boot-time + joystick-drag screen tearing: the RGB
    bounce-buffer ISR was starved of PSRAM bandwidth.
    - CONFIG_ESP_DEFAULT_CPU_FREQ_240 does not exist and was silently
    ignored - the chip ran at 160 MHz. Use CONFIG_ESP_DEFAULT_CPU_FREQ_MHZ_240
    (verified 'cpu freq: 240000000' in boot log).
    - Enable SPIRAM_XIP_FROM_PSRAM: flash writes (NVS, Wi-Fi PHY cal) no
    longer disable the cache, so the bounce ISR keeps reading the PSRAM
    framebuffer during flash ops.
    - 64 KB / 64 B-line data cache + -O2 (PERF) for PSRAM->bounce memcpy
    bandwidth, matching the official esp-dev-kits lvgl_demos config.
    - Keep 3 fra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
2026-09-29 fix(ui): give Settings root a header with back-to-Home
    The Settings root was the only page without a header - a dead end once
    entered. Put the SETTINGS title into the standard ui_header wired to
    nav_home_cb, with the scrollable item list below it; the header hides
    together with the list when a sub-page opens (each sub keeps its own
    back-to-list header).
    [ui_pages.c]
2026-09-29 fix(link): WebSocket 发送超时 0 改为 5/20 ms，消除 DRIVE 掉帧与 ping 丢失
    - send_bin 超时 5 ms：TX 锁每次只持有一个 ~20 B 帧的写入（ping 文本、
    库内 PING/PONG），短等待把 30 Hz DRIVE 与之的周期性锁冲突从
    "丢帧 + 错误日志"变成亚毫秒级延迟，且仍不会让控制任务停在卡死的
    socket 上。
    - send_text 超时 20 ms：仅 1 Hz 监视任务发文本（ping/配对），允许它
    等待 DRIVE 发送方持有几百 µs 的锁。超时 0 时 ping 每隔几秒就输掉
    锁竞争（"Could not lock ws-client within 0 timeout"），pong 不到、
    RTT/丢包读数跳变，且每次未命中都打印一条错误日志。20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
    [scr_link.c]
2026-09-29 fix(config): 关闭 Wi-Fi NVS 持久化，避免连接期 flash 写干扰 RGB 供帧
    Wi-Fi 驱动默认把配置写入 NVS：每次（重）连接都重写 flash，而每次
    flash 写都会短暂关闭 cache，扰动 RGB bounce-buffer 扫描输出——链路
    抖动期间面板出现花屏/粉帧。STA 配置本就由 scr_settings 每次开机
    写入，无需驱动再持久化（# CONFIG_ESP_WIFI_NVS_ENABLED is not set）。
2026-09-29 ui: HUD 风格整体改版——主页面板化 + 设置页指挥台
    - ui_theme: 换 HUD 色板（深蓝黑底、青色强调、新增 UI_COL_LINE 描边
    色）；卡片/标题栏/按钮改为 1 px 静态描边替代阴影（首帧后零渲染
    开销，不再逐帧模糊混合 RGB 供帧）；标题栏加青色下边线。
    - ui_home: 顶栏加强调色 tick + 字距标题 + REMOTE CONSOLE 副标题；
    油门/转向由文本行改为对称 HUD 进度条（-100..100，CAP|条|值 定宽
    布局）；遥测改为 3×2 定宽信息格（caption+值，超长省略号截断，
    修复原 space-between 三个自由宽度标签互相叠印）；MODE 整格作为
    触摸目标；状态词精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
    [ui_home.c, ui_joystick.c, ui_pages.c, ui_theme.c, ui_theme.h]
2026-09-29 chore(ide): 记录 ESP-IDF 扩展烧录串口与 flash 类型
    vscode 扩展本地状态（idf.port=/dev/tty.usbmodem11201、UART 烧录），
    与文件内已有的机器相关 clangd 路径同一性质；换 USB 口后该行会变化，
    属预期噪音。
2026-09-29 fix(ui): 修复 HUD 改版后真机上的三处标签布局溢出
    LVGL 的 DOTS 截断只在标签有固定高度时生效；自动高度下的长文本会
    换行成两行而不是打点截断，固定/底部对齐后向上顶入相邻元素。
    - ui_home 信息格：caption/值标签显式一行高，caption 不再压到值上
    - ui_pages 模块磁贴副标题：固定一行高，长值（"NORMAL - dead zone
    10%"）不再从底部向上生长叠进标题（01/04 磁贴重叠）；文案缩短
    （" / DZ"）
    - ui_pages 状态芯片行：三枚自由宽度芯片加内边距+字距后总和超过
    246 px 行宽，外侧两枚被裁掉——改为各占 32% 定宽 + CLIP 居中，
    行内 SP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
    [ui_home.c, ui_pages.c]
2026-09-29 feat(svc): 架构 v2 服务层基座——OTA 暂存分区 + core-0 服务任务
    按 doc/08-architecture-v2.md（§2/§3/§4-§6）新增 scr_svc：所有可能阻塞
    在网络或 flash 上的工作集中到 core-0 队列驱动任务，UI 只读快照
    （互斥锁下拷贝）：
    - 固件暂存区 fw_c6 / fw_tc 分区（4 KB SCFW 头 + 载荷），PC 端用
    tools/stage_fw.py 烧入（校验 CRC32、记录版本/构建时间，--clear 擦除）
    - 流式 HTTP OTA 上传到 C6（/ota/c6 签名 C6FW bundle ≤3 MiB、
    /ota/tc275 raw 镜像），上传前对暂存区重算 CRC 复核
    - GET /api/diag 轮询（C6 故障诊断）与标定/OTA 事件的 WS JSON 存储
    （cal/rec/otastatus/otaswa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
    [partitions.csv]
2026-09-29 feat(rt): 双核绑定与控制延迟路径（doc/08 §2）
    原则：core 1 只放确定性实时任务（ctrl 6 > LVGL 4），一切可能阻塞在
    网络/flash 上的工作移到 core 0。
    - lwIP tcpip 任务绑核 0（CONFIG_LWIP_TCPIP_TASK_AFFINITY_CPU0，原先
    no-affinity 会漂到 core 1 抢占 LVGL 供帧）；scr_link 监控任务显式
    绑核 0；scr_ctrl 绑核 1 并升到 prio 6。
    - 摇杆即发（scr_ctrl_kick）：摇杆值变化立即唤醒 ctrl 任务发送 DRIVE，
    不再等下一个 33 ms 节拍（对标手机页逐指针事件发送）；20 ms 内的
    kick 合并（≤50 帧/s），定时 30 Hz 仍作心跳。
    - TCP_NODELAY：浏览器 WS 默认关 Nagle，esp_webs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
2026-09-29 feat(ui): LVGL 堆迁入 PSRAM + FIRMWARE/CALIBRATE/DIAGNOSE 三个服务页面
    - lv_mem_psram（LV_USE_CUSTOM_MALLOC）：C 库分配器让每个小控件先占
    内部 RAM，服务页面加入后十余页控件把内部 RAM 耗到 0，Wi-Fi 驱动
    无缓冲可用（同 R 系列重启循环）。UI 树整体落 PSRAM（64 KB/64 B
    D-cache 保证遍历速度），内部 RAM 只作回退、专留 Wi-Fi/lwIP/DMA/
    任务栈。CMake 显式 -u lv_malloc_core 拉入对象（LVGL 晚于 main 链接）。
    - ui_service：三个页面只渲染快照、投递请求，全部 I/O 委托 scr_svc
    （core 0）/ scr_ctrl——
    FIRMWARE：C6/TC275 暂存镜像状态（EMPTY/BAD/OK + 原因）、按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
2026-09-29 docs: 架构 v2 说明与中文用户手册
    - doc/08-architecture-v2.md：双核规划、控制延迟路径、内存放置、
    flash 分区（fw_c6/fw_tc）、固件升级 / 标定 / 诊断设计与依据
    - doc/USER-MANUAL-CN.md：面向使用者的中文操作手册
2026-09-29 fix(link): WS 发送超时 5/20 ms 改为 150 ms（soak 09-30）
    esp_websocket_client 的超时同时作用于锁等待与 socket 写，写超时即
    判定传输错误并断链。5 ms 短于一次 Wi-Fi 重传突发，实测每几分钟一次
    "Poll timeout ... 5 ms" → RADIO LOST。等待只停住 ctrl 任务（睡眠，
    core 1 的 LVGL 不受影响），卡死超过 150 ms 的 socket 本就是死链。
    可写前置检查（select）仍在，缓冲暂满依旧跳帧不阻塞。
    [scr_link.c]
2026-09-30 fix(encoder): 编码器刻度按实物更正——13 PPR、1061.27 计数/轮转、默认轮径 48
    MG310 实物编码器为 13 PPR 霍尔 AB（此前误记 260 线）：×4 解码 = 52 计数/电机转，
    ×20.409 减速 = 1061.27 计数/轮转（48 mm 胎 = 150.8 mm 周长 = 0.1421 mm/计数）。
    - rt/encoder.h：ENCODER_LINES 260 → ENCODER_PPR 13、ENCODER_WHEEL_DIA_MM 65→48，
    ENCODER_COUNTS_WHEEL_REV 随宏得 1061；换算公式一字未动
    - mw/calib/calib_record.h：CALIB_WHEELDIA_DEF 65→48（默认记录经 RecordLive 会
    覆盖宏默认，必须同改；48 在既有合法域 [30,200] 内）
    - rt/encoder.c：ISR 负载注释按新刻度更正（空载 500 rpm 四路 ≈1.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
    [calib_record.h, encoder.c, encoder.h]
2026-09-30 Enhance pairing UI and settings functionality
    - Redesigned the pairing interface to visually represent the three-step handshake process with nodes and wires indicating status.
    - Added a back button to return to settings from the pairing screen.
    - Updated pairing status display to show whether the device is paired and to present the session token.
    - Improved the control settings UI for drive tuning, including a visual representation of the dead zone and response curve.
    - Enhanced radio link console to display live signal quality and connection status.
    - Adjusted the refresh logic for control and radio settings to ensure UI updates reflect the current state.
    - Configured LVGL rendering period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
    [app_main.c, ui_home.c, ui_joystick.c, ui_pages.c]
2026-10-01 适配 SBL：槽 A 构建 + OTA 接收接入 + 自检确认（doc 24）
    App 侧接入 OTA 双 bank 方案（设计见 doc/24-ota-sbl-dualbank.md，实现索引
    已同步；SBL 工程在 myCarSbl 仓库）：
    - linker 槽位化：Lcf_Tasking_Tricore_Tc.lsl 内容换为槽 A 布局
    [0x80008000,0x80200000)，入口 .start @0x80008020（SBL 跳转目标），
    BMHD 作惰性数据落槽基址；新增 Lcf_AppB.lsl（OTA 目标槽 B 版本，
    .start @0x80208020）。保持默认文件名，ADS 构建零配置切换。
    两版均以本工程原 lsl 为底变换，经 TASKING 冒烟链接验证（AppA hex 全
    落槽内、含 INTVEC@0x801F4000/TRAPVEC@0x801F62xx）。
    - OTA 协议栈同源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
2026-10-01 doc/24 同步：整包烧录说明（merge_hex.py 合成 SBL+AppA）
2026-10-01 .cproject：include 路径补 mw/ota、mw/crypto（SBL 接入后 IDE 自动登记）；调试配置会话更新
2026-10-01 chore(build): SCons 命令行构建入库——以 .cproject 为单一真源镜像 GCC 配置
    - SConstruct + build_tools/fw_sources.py：从 .cproject 解析参与编译的源、
    include 路径与宏，命令行构建 TriCore Debug/Release (GCC) 镜像到
    build/gcc/<mode>/（产出 ELF/hex/siz），与 IDE 构建不会漂移；
    TASKING 授权仅限 IDE 内运行（CLI 退出 F104），不在命令行构建范围
    - .cproject：include 路径补 mw/ota、mw/crypto（补齐 bf2d8ff OTA/SBL 落地
    的构建配置半截）
    - .gitignore：build/、.sconsign.dblite、__pycache__/ 为构建产物，不入库
    验证：主机单测 test_sf 2948 断言 0 失败（当前树含 OTA 适配后代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
2026-10-01 移除 scons 命令行构建脚手架（SConstruct/build_tools）与构建产物
    TASKING 恢复为唯一构建通道（ADS GUI/无头），GCC 镜像构建不再维护；
    删除 build/、.sconsign.dblite 产物目录。
2026-10-01 chore: smartcar 多仓库总控（submodule 清单 + contracts 共享接口 + 批量脚本）
2026-10-01 chore: 统一 LF 换行（.gitattributes），保证 contracts 跨平台逐字节校验一致
2026-10-01 feat(contracts): OTA 接口扩至 tc275_car，新增 crypto 三方验签契约与 ota_keys
2026-10-01 ci: contracts 门禁双平台跑（Linux+Windows），新增 doctor/repos 跨平台脚本，justfile 委托 repos.sh
2026-10-01 docs: 多仓库详细使用指南（概念/场景/命令/脚本/CI/FAQ）
2026-10-01 chore(rename): 工程名 myCar→tc275_car，统一仓库名/工程名/产物名
    - .project/.cproject：工程名与 buildPath 改为 tc275_car（产物随 ${ProjName} 变为 tc275_car.elf/hex）
    - launch 改名 tc275_car TriCore Debug (TASKING).launch，清除指向旧工作台的 12 条过期 MemoryMap 绝对路径
    - Libraries/myCar.OneEye → tc275_car.OneEye，elf-path 指向当前布局并修复缺失空格
    - CI：esp32c6_car 检出路径 c6_car→esp32c6_car（对齐 IDF 工程新名）
    - 契约副本 ota_layout.h 注释随 contracts 权威版下发（myCar→tc275_car）
    - 文档/注释全量统一：myCar→tc275_car、c6_car→esp32c6_car、myCarSbl→tc275_sbl
    - 主机单测（test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
    [calib_record.h, flash_ota.c, link.c, link.h, protocol.h]
2026-10-01 chore(rename): 文档/注释统一命名——c6_car→esp32c6_car、myCar→tc275_car
    - 码表故障表提示、stage_fw.py 示例镜像名（mycar.bin→tc275_car.bin）联动
    - 契约副本 proto_frames.h 注释随 contracts 权威版下发
    - host 单测（proto 编解码）验证通过
2026-10-01 fix: .gitignore 行内注释导致 *.exe 等规则失效；移除误提交的单测产物 test_proto.exe
    gitignore 不支持行内注释，'*.exe # ...' 整行被当作字面模式，
    主机单测产物因此被上一提交带入。拆正注释行并补齐同类失效规则
    （flasher_args.json/*.workspace/*.suo/*.sln.docstates）。
2026-10-01 fix: launch 的 SVD 路径对齐本机 ADS 1.10.40（1.10.36 未安装）
2026-10-01 chore(rename): myCarSbl 仓库改名 tc275_sbl，四仓命名统一 <平台>_<功能>
    - GitHub 仓库 myCarSbl→tc275_sbl（旧 URL 自动重定向）；.gitmodules/submodule 联动
    - 子仓库工程名/产物名与仓库名对齐（详见各仓 chore(rename) 提交）：
    tc275_car: IDE 工程 myCar→tc275_car；tc275_sbl: myCarSbl→tc275_sbl + Blinky 模板清理；
    esp32c6_car: IDF 工程 c6_car→esp32c6_car；smartcar_remote: 文档注释统一
    - contracts/ 注释同步（myCar→tc275_car、c6_car→esp32c6_car），四仓副本已闭环
    - scripts（repos/sync-gh/doctor/check-contracts）、justfile、README、doc/00-usage 全部换名
    - README：ADS 导入说明更新（工程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
2026-10-01 chore: ignore ADS 服务生成的 SConstruct/site_scons
2026-10-01 lock: bump submodule versions（tc275_car/tc275_sbl 增补 gitignore 提交）
2026-10-01 feat(firmware): fw.py 四工程固件统一管理（编译/烧录/归档/出厂整包）
2026-10-01 feat(meta): just fw-* 固件配方 + scons-car/scons-sbl TASKING 直编配方与文档；锁 tc275_sbl 指针
2026-10-01 fix(encoder): 测速 8 ms 窗由中值改均值；0x70 判向标定改为按当前符号取反
    - encoder：逐 ms 整数增量取中值会量化成 71 mm/s 台阶（1 计数/ms = 71 mm/s），
    低速恒读 0、斜坡大量读 0；窗内求和保留全部计数，分辨率 ≈8.9 mm/s。
    软解 x4 每真实边沿只产生 ±1、毛刺对 (+1/-1) 在求和中本就抵消，中值无收益。
    - motor_algo：标定末脉冲 delta 为负时若强置 -1，DFlash 旧记录残留 -1 的轮
    永远修不回来（重跑标定也无法修复，该轮 mm/s 持续抵消同侧伙伴 → 车体速度
    读 ~0 或负）；改为对当前符号取反。
    - 文档同批同步：21 §5.1、31 §9、33 代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
    [encoder.c, encoder.h, motor_algo.c]
2026-10-01 chore: 忽略本地 SCons 构建脚本（SConstruct / site_scons）
2026-10-01 feat(version): 固件版本号落地——mw/app_version.h 唯一真源，产物名携带版本
    - mw/app_version.[ch]：SemVer 宏（0.2.2）+ 内嵌 "APPFW tc275_car v0.2.2" 串
    - Cpu0_Main 启动横幅经 ASCLIN0 打印版本（引用即保证产物内存活）
    - SCons（本地）产物名自动带版本 tc275_car_vX.Y.Z.elf/.hex/.map
    - README 新增"固件版本"章节（发布流程：bump 宏 -> tag 同名）
    - 本提交含 fix/encoder-mean-window rebase 合入后的 IDE 会话状态文件
    - 验证：SCons 全量构建通过（ROM 67406，elf 内可检索版本串）；host 单测 2948 项 0 失败
    [Cpu0_Main.c]
2026-10-01 lock: bump tc275_car/tc275_sbl——fix 分支合入改名线 + 双仓固件版本号落地
2026-10-01 docs: doc/24 构建脚本行——build_sbl.sh 已删，命令行构建统一 SCons
2026-10-01 build(tc275): 命令行构建统一 SCons——删除 build_sbl.sh（tc275_sbl 6e8d62e/46cb75f）
    - tc275_sbl：build_sbl.sh 删除；SConstruct/site_scons 入库；flash.py 自动发现
    SCons 版本化 hex；README/doc/24 同步
    - tc275_car：doc/24 构建脚本行同步
    - meta doc/00-usage.md：fw.py 委托表与 SCons 说明更新
2026-10-01 build(fw.py): TC275 双仓构建委托切到 python -m SCons（配合 tc275_sbl 删 build_sbl.sh）
    - build_tc275_car/build_tc275_sbl 统一为 SCons 委托（余参透传 cfg/opt/-c），删除
    ADS subdir.mk 解析器与 tasking_env/find_sh/find_tasking（工具链由 SCons 发现）
    - 产物发现：build/tasking-*/ 版本化产物优先、ADS 目录回退，按名去重留最新；
    sbl_hex/app_hex 同步（版本化 hex 优先）
    - firmware/README.md：编译烧录表、SCons 说明、factory 路径、TASKING 环境变量同步
    - 验证：fw.py build 双仓全通；factory 整包合成成功（版本化产物入链）
2026-10-01 fw(dist): dist 归档入库——固件镜像+manifest 版本管理，elf/map 留本地
    - fw.py：构建成功即自动归档；TC275 归档目录名携带固件版本（v0.2.2-…-g哈希）；
    manifest 增加 fw_version；产物只取最新构建所在目录（避免新旧构建混杂）
    - .gitignore/.gitattributes：dist 镜像+manifest 入库（-text -diff 保真），
    elf/map/mdf 留本地；justfile 新增 fw-dist 一键提交推送
    - 含 tc275_car v0.2.2 / tc275_sbl v0.1.0 及更早历史归档
2026-10-01 build(scons): SCons 命令行构建入库（SConstruct + site_scons，与 tc275_sbl 同源副本）
    - build_sbl.sh 删除后 SCons 是唯一命令行构建路径，本地文件转正入库保持两仓对称
    - SConsignFile 收进 build/——签名库不再落在工程根；gitignore 换 cc[0-9a-f]* 防护网
    - aurix_tasking.py 含 header_version() 助手（产物名携带 mw/app_version.h 版本）
2026-10-01 lock: bump tc275_car/tc275_sbl——SConsignFile 入 build/，car 侧 SCons 构建入库
2026-10-01 feat(version): 读取 SBL 版本号——固定地址 0x80007E00 直读 + magic 校验
    - mw/app_version.[ch]：SBL_VERSION_ADDR（0x80007E00，tc275_sbl Lcf_SBL.lsl
    定址的 .sbl_version 组）+ sbl_version_string()，volatile 直读 PFlash，
    magic "SBLFW" 校验（SBL 未烧/老 SBL 返回 NULL）
    - Cpu0_Main 启动横幅顺带打印 SBL 版本
    - 验证：SCons 构建通过（ROM +72B）；host 单测 2948 项 0 失败
2026-10-01 lock: bump tc275_car/tc275_sbl——SBL 版本号定址 0x80007E00，App 可直读
2026-10-01 feat(version): 版本号上链路——遥测 fwVer 派生真版本 + EVT 0x24/0x25 版本信标
    - Cpu2_Main：遥测偏移33 的 fwVer 不再硬编码 0x00010200，由 APP_VERSION_STRING
    派生（0x00MMmmpp），S3 现有 FIRMWARE 行直接显示真实版本
    - Cpu0 vRobotControlTask：启动时 + 每 5s 经 XCORE_evtPush 推两个版本信标
    （SF EVT 0x24 APP / 0x25 SBL，各 24B 定长串；SBL 未烧为全零）
    - mw/sf/sf_frame.h：SF_CID_EVT_APP_VER/SBL_VER 常量（与 c6_sf 副本同步）
    - 验证：SCons 构建通过；host 单测 2948 项 0 失败
2026-10-01 feat(ui): 显示 TC275 APP+SBL 版本——tcver JSON 接入 + Diag 卡 SBL 行
    - scr_link：{"t":"tcver"} 文本分支 → app_state_set_tc_ver
    - app_state：tc_app_ver/tc_sbl_ver 字段 + setter（互斥锁保护）
    - Diagnostics TC275 卡：13 行布局（间距 31→29），SBL 行独立于遥测新鲜度
    刷新，magic 前缀剥离只显版本号，SBL 未烧显示 --（暗色）
    - Vehicle 页 FIRMWARE 行随遥测 fwVer 修正自动显示真实 APP 版本
    - host 单测全过
    [app_state.c, app_state.h, scr_link.c, ui_service.c]
2026-10-01 lock: bump 三仓——S3 可读 TC275 APP+SBL 版本（遥测 fwVer 修正 + EVT 0x24/0x25 信标贯通）
2026-10-01 lock: bump esp32c6_car——修复 sf_frame.h 注释结构
2026-10-01 docs(readme): 版本徽章——首个版本 tag v0.1.0 对齐 PROJECT_VER
2026-10-01 docs(readme): 版本徽章——tag v0.2.2 对齐 mw/app_version.h 0.2.2
2026-10-01 docs(readme): 五仓统一徽章——CI 状态 + 版本（meta 版本即整车总 tag）
2026-10-01 docs: 新增 CHANGELOG——Keep a Changelog zh-CN 1.1.0
2026-10-01 fix(ui): Diag 卡 SBL 行两处编译错误——fd.tc 数组 12→13，清除误写入源码的真实 NUL 字节
    [ui_service.c]
2026-10-01 lock: bump smartcar_remote——Diag 卡 SBL 行编译修复
2026-10-01 chore: gitignore 补 .codegraph/、.kiro/（本地工具目录不入库）
2026-10-01 feat(diag): CALJSON/TELE 控制台日志——不开 DIAGNOSE 页直读标定结果与 2 Hz 双侧目标/实测速度
2026-10-01 lock: bump submodule versions（CHANGELOG + scr_link.c 日志）
2026-10-01 feat(version): DIAG 0x53/0x24 请求即发版本信标——PROTO 消费 CID_DIAG，app_ver 请求标志 CPU0 同轮取走
2026-10-01 feat(ui): About 页节点卡 tap 刷新固件版本——C6 走 /api/health，TC275 走 tcver 请求链；版本号统一 v 前缀显示
2026-10-01 lock: bump esp32c6_car/tc275_car/smartcar_remote——About 页 tap 刷新固件版本全链路
2026-10-01 feat(ui): About 页 TC275 卡双行显示 APP+SBL 版本；信标缺失时回退遥测 fw_ver
2026-10-01 chore(fw): 构建别名 remote→r-s3，移除改名前的 myCarSbl 别名
2026-10-01 lock: bump smartcar_remote——About 页 APP/SBL 双行版本显示
2026-10-01 fix(link): hello.tc 占位串不再覆盖 tc_on（真在线信标先于 hello 广播）；遥测帧自证链路在线；WS 连续 3 次失败强制重连 Wi-Fi 自愈
    [app_state.c, scr_link.c, ui_pages.c]
2026-10-01 lock: bump esp32c6_car/smartcar_remote——http 状态行修复 + tc_on 自愈
2026-10-01 chore(log): 清理 tcver 与 About 页调试日志
2026-10-01 fw(dist): esp32c6_car 归档入库（d3feb4d，tcver 中继版本）
2026-10-01 lock: bump esp32c6_car/smartcar_remote——日志清理
2026-10-01 release: v1.0.0——首个稳定版（PROJECT_VER 1.0.0，CHANGELOG 收录版本 tap 刷新与链路自愈修复）
2026-10-01 release: v1.0.0——首个稳定版（app_version.h 1.0.0，CHANGELOG 收录按需版本信标）
2026-10-01 docs(changelog): 收录 v1.0.0 整车稳定版（四仓版本统一 1.0.0）
2026-10-01 chore: ignore 外部工具产生的 *.diff 临时差异文件
2026-10-01 feat(ota): fw.py ota 经 S3 中转——签包+SCFW 暂存进遥控器（FIRMWARE 页推送），--direct 保留直推；just 新增 fw-ota 配方
2026-10-01 chore(dist): esp32c6_car/smartcar_remote 归档不再入库——gitignore 两目录并清理已提交的旧归档
2026-10-01 feat(ota): FIRMWARE 页免配对推送——SCR_OTA_NO_AUTH=y（默认）跳过 token 门，量产与 C6_OTA_NO_AUTH 联动关闭
2026-10-01 lock: bump esp32c6_car/smartcar_remote——OTA 免配对推送（C6+S3 双侧）与 fw.py S3 中转链路
2026-10-01 feat(svc): add C6 OTA quiet handling to prevent false RADIO LOST alerts
    [scr_ctrl.c, scr_svc.c, scr_svc.h]
2026-10-01 fix: suppress full-screen RADIO LOST alert during C6 OTA and TC275 power-off scenarios
    - Updated the safety_watch function to ensure that the full-screen RADIO LOST alert is only triggered for actual radio link losses between S3 and C6.
    - The alert will not be shown if the vehicle (TC275) is powered off while the connection to C6 remains active, instead reflecting the status as OFFLINE/STALE on the SYSTEM page.
    - Adjusted the logic to debounce brief reconnections to prevent unnecessary overlay strobing during telemetry hiccups.
    [scr_ctrl.c]
2026-10-01 pin: bump esp32c6_car/smartcar_remote——telemetry 防重放 + C6 OTA 静默
2026-10-01 chore(just): 新增 pin 配方——固化子仓库 HEAD 修复 (new commits) 漂移；移除 .gitignore 对已跟踪子模块无效的 smartcar_remote 条目
2026-10-01 chore!: 退役 submodule 架构——移除四仓 gitlink 与 .gitmodules（monorepo 化第一步）
2026-10-01 ci!: workflow 收编至根目录——四工程 CI + 发版按 paths 触发；tag 加工程前缀（c6/ r-s3/ app/ sbl/）；tc275_car 跨仓校验改用仓内 esp32c6_car 源码
2026-10-01 chore(just)!: monorepo 化工具链——退役 init/status/sync/push/fix-head/lock/pin 配方与 repos.sh，新增 tag 配方；doctor 改单仓换行检查；README/doc-usage/CHANGELOG 重写为 monorepo 叙事
2026-10-01 feat(jog): 编码器计数 EVT 0x26 全链路——TC275 jog 中 10Hz 上报四轮增量，C6 转 jogcnt JSON，S3 标定页按物理位显示
    - TC275: 0x71 jog 活动期 10Hz + 400ms 滑行尾，EVT 0x26 {on u8, delta i32x4, A..D}；encoder 取 post-invert 原始计数
    - C6: bridge 解析 0x26 → {"t":"jogcnt","on":n,"d":[A..D]}；sf_frame.h 补帧 ID
    - S3: 标定页 res_name/jog_name + motor_at 物理位→电机映射（记录到达前用 DEF_POS 工厂缺省）
    - calib.html: jog 按钮箭头改上下向（◀▶ → ▲▼）
    monorepo 首个跨工程原子提交：C6/S3/TC275 三侧一处收口
    [bridge.c, calib_store.c, encoder.c, scr_link.c, scr_svc.c, scr_svc.h, ui_service.c]
2026-10-01 fix(c6): CONFIG_C6_BENCH_CTRL 固化进 sdkconfig.defaults——防 sdkconfig 重新生成时台架免配对开关静默丢失
    monorepo 迁移后 sdkconfig 重生成时丢掉了台架 WS 免配对开关，遥控器失去控制权；
    该开关从 gitignored 的本地 sdkconfig 提级到 defaults。生产固件必须置 n（文件内已注释告警）
2026-10-01 feat(ui): add custom triangle drawing for jog buttons to indicate direction
2026-10-01 feat(calib): enhance flash operation error handling and logging
    [calib_store.c]
2026-10-01 fix(ui): 标定页 RECORD 卡行距修正 + 启用 LVGL 暗色主题
    - ui_service: RECORD 卡将 FULL SCALE/WHEEL mm 两行上移，消除 ± 调节按钮与 READ/WRITE 按钮的纵向重叠
    - sdkconfig.defaults: CONFIG_LV_THEME_DEFAULT_DARK=y，避免默认主题把普通容器文字烘成浅底近黑色
    - ui.c: 启动页阶段名显式设置文字色，防止卡片样式注入不可读颜色
    [ui.c, ui_service.c]
2026-10-02 fix(calib): DFlash0 擦除态极性 0x00 + 页装载小端——标定保存链路台架闭环（v1.0.9/1.0.10/1.0.11）
    两个台架实锤根因，至此 0x70 标定后 SAVE failed/挂死系列问题闭环：
    - DFlash0 擦除态读 0x00 而非 0xFF（与 PFlash 极性相反，Infineon TC275
    训练材料佐证）——v1.0.2 引入的 0xFF 擦除确认门把擦好的扇区当没擦，
    永远拒绝编程；擦除确认改判 0x00，页填充随擦除态改 0x00
    - 页装载缓冲 LSB 落低地址——大端 packWord 把每组 4 字节写反
    （台架读回 'SDC1'→'1CDS' 实锤），改小端打包
    - 撤除基于"读全 0=未映射"误判的探针/自动选槽，槽位固定 0xAF01E000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
    [calib_store.c]
2026-10-02 fix(flash_ota): 页装载打包改小端——SBL/App OTA 写路径同款字节序 bug（sbl 1.0.1, app 1.0.11）
    - flash_ota.c 两份同源副本同步：packWord 大端→小端（页装载缓冲 LSB 落
    低地址，台架经 calib 记录路径实证），'TCOM' 魔数原会落成 'M OCT'，
    槽位编程与 DFlash meta 写入的回读校验必败
    - DFlash meta 页填充 0xFF→0x00（DFlash0 擦除态极性，同 calib 修复）
    - slotEntrySane 已同时认 0xFF/0x00 两种空态，无需改
    - OTA 端到端待一次真实 OTA 推送实测
    [flash_ota.c]
2026-10-02 chore(version): 四仓版本真源统一升至 1.1.0（迎接 S3-CAM 替换 C6）
    esp32c6_car/smartcar_remote PROJECT_VER、tc275_car/tc275_sbl app_version.h 同步 1.1.0；迁移前状态已由整车基线 tag v1.0.1 锁定
2026-10-02 feat(s3-gateway): 纳入 s3-gateway 工程（ESP32-S3 Freenove CAM，C6 全量移植）
    118 个源文件入轨：build/managed_components/sdkconfig 沿用工程自带 .gitignore 排除；PROJECT_VER 对齐整车 1.1.0；公钥例外路径随 c6_→s3_ 更名修正，pub_ed25519_dev.bin 恢复入库
    [partitions.csv]
2026-10-02 feat(s3-gateway): 双核任务绑核并固化分工文档
    单核 C6 的"任务自由浮动"前提在双核 S3 不再成立，按"核0=面向 socket 的一切、
    核1=面向引脚的一切"显式绑核：
    - link/bridge/ota/rb_chk/led 改 xTaskCreatePinnedToCore 到核1；控制与推流两台
    httpd 及 dns/mdns/legacy 用 core_id=0 留在核0
    - lwIP tcpip 由 NO_AFFINITY 改为 AFFINITY_CPU0，cam_task 经 CONFIG_CAMERA_CORE1
    挪出核0（其优先级 configMAX_PRIORITIES-2=23 高于 tcpip 18，留在核0 会让每帧
    JPEG 落地都抢占射频栈，表现为摇杆 RTT 抖）
    - 台架开机 task map 打印实测落核与剩余栈，并修正 TaskStatus_t 字段名
    （uxCurrentPriorit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
    [app_main.c]
2026-10-02 feat(camera): S3-CAM 视频链路双端打通——Remote 视频面落地 + 网关 /ws/camera 双向会话
    本轮台架联调把手持机到网关的相机链路闭合，主要块（细节与台架证据见根/两工程
    CHANGELOG [未发布] 段、s3-gateway/doc/19-camera.md、doc/21-spec-alignment.md、
    两份详细设计说明书 V1.0）：
    Remote（smartcar_remote）
    - 视频面 scr_cam + CAMERA/VISION 页：独立 esp_websocket_client 拨
    ws://<gw>:81/ws/camera（监督者独占拨号、3s 重拨、Control 断链联动拆链），
    20B cam_frame 头校验 + esp_jpeg(TJpgDec) 解码 + 3 帧槽最新帧环 + 10Hz LVGL 泵；
    app_state 扩 cam/vision 字段组，Kconfig 增 SCR_CAM_*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
2026-10-02 fix(remote): "置灰 + toast" 的 toast 是死代码——新增 ui_set_blocked 承载信息型门控
    LVGL 对 LV_STATE_DISABLED 对象根本不派发 CLICKED（lv_indev.c 的 is_enabled
    前置判断），§8.1 三 TAB、§8.2 profile、§8.3 mode/drive 按钮一旦变灰，tap 进
    不到回调，写在回调里的原因 toast 永不触发——说明书要求的"置灰 + toast"实际
    只剩置灰。
    - 新增主题原语 ui_set_blocked()：信息型门控保持可点，递归 OPA 淡出（子 label
    随父一起变暗）、取消 PRESSED 高亮让手感仍是"按不动"；LV_STATE_USER_1 只作
    标记，10 Hz 刷新遇到门控未变不重复重样式/重绘
    - 原因串单一真源：cam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
    [ui.c, ui_camera.c, ui_theme.c, ui_theme.h, ui_vision.c]
2026-10-02 fix(camera): /ws/camera 帧头 SEQ 恒 0——出站泵逐帧 ++s_seq，手持机不再把整条流当重复帧丢弃
    s_seq 的自增只存在于 /stream 的 sink 路径（++s_seq 作参数），WS 泵直接引用变量，
    导致每个视频帧 SEQ 恒为 0：手持机 cam_seq_note 把首帧（RESYNC 收下）之后的
    每一帧全判 CAM_SEQ_STALE 静默丢弃——CAM 页永远 NO SIGNAL，串口只剩
    seq=0/win=0/ferr=0 的"干净"零计数（STALE 不进任何计数器），无浏览器观众时
    必然复现。台架验证：10.0fps、seq 单调递增、e2e 14-38ms。
    同录两组台架否决（sdkconfig.defaults 注释 + CHANGELOG）：
    - PSRAM/flash 120 MHz：S3 上 OCTAL PSRAM 120M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
    [camera_stream.c]
2026-10-02 feat(remote): 视频面提速与可读性——表驱动 JPEG 解码 + 33ms 视频泵 + 信息条实测定宽
    解码器换血（体验主杠杆）：esp_jpeg 弃用 ROM 固化 TJpgDec（RGB565 输出走逐像素
    3→2 字节转换、哈夫曼无查表），改编译版 JD_FASTDECODE=2 表驱动哈夫曼 +
    JD_FORMAT_RGB565 原生 2 字节直写；63KB 工作区锁内部 RAM（PSRAM 回退兜底，
    启动日志标注落位）。CAMERA/VISION 页另立 33ms 视频泵（ui_camera/vision_
    pump_video，seq 门控让无新帧 tick 零开销），新帧平均 ~17ms 上面板，替代原先
    最长 100ms 的 UI tick 等待；遮罩只在可见性边沿搬前景。SCR_CAM_MAX_FPS 显示
    上限 10→12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
2026-10-02 fix(camera): WS 发送短写致截断帧、对端失步拆链——整帧写出发送器替换 httpd_ws_send_frame_async
    httpd_ws_send_frame_async 只检查 send() 返回 <0，而 lwIP 在 SO_SNDTIMEO 到期
    后返回的是"已入队字节数"（正值短写）：WiFi 拥塞下 20KB JPEG 常被掐半上链，
    下一帧头落在负载中间，手持机把 JPEG 字节解析成 RSV 置位/保留 opcode，整个
    Camera WS 被拆掉（台架 10-02：每次重连前都有一条 "ws send stalled"）。
    改为自绘无掩码服务端帧（FIN+opcode、7/16/64-bit 长度）+ ws_write_all 全量
    写出发送器：整帧 1.5s 预算（数个 SO_SNDTIMEO tick），EAGAIN/EINTR 续写；
    一个字节已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
    [camera_stream.c]
2026-10-02 fix(remote): CAM 页首帧落面板外全黑——immersive_applied 初值反置；顺带布局轨迹日志
    apply_layout(false) 结尾首调 + immersive_applied 初值 false → 命中无变化
    早退，视频区从未被定尺摆放，首帧画到面板外（台架 10-02：img 位于
    (-95,-55)-(224,184)，整页黑）。初值改 true（与首调目标态相反），首调真正
    生效；ui_camera/ui_vision 同修。帧尺寸变化时打一行实际面板坐标（off-panel
    与死流在画面上无法区分，串口上分得开）。.gitignore 收录 smartcar_remote/.cache。
    [scr_cam.c, ui_camera.c, ui_camera.h, ui_vision.c]
2026-10-02 feat(camera): VGA 按手持机解码速率节流——400ms 最小帧间距，控链不再被空口饿死
    手持机解一帧 VGA 要 ~450ms，传感器 ~11fps 意味着 3/4 的 VGA 帧过空口后在
    对端被 latest-only 丢弃（台架 10-02：drop=742/~1000）——白白占掉的空口时间
    正是把手持机控制上行挤到 150ms 写超时、触发 RADIO LOST 的元凶。VGA（宽>
    320）出站泵加 400ms 最小间距（~2.5fps=解码速率），QVGA（~70ms 解码）保持
    全速率；被节流的帧计入 wdrop 语义不变。
2026-10-02 fix(remote): immersive 视频页保留 TAB 栏（唯一回 HOME 的路）；TCP 窗口调优固化进 defaults
    640x480 immersive 布局原先把 TAB 栏整个藏掉，而它是视频页回 HOME 的唯一
    入口——用户被困在视频页（台架 10-02）。改为 TAB 常驻、覆盖帧底部 44px。
    sdkconfig.defaults 固化收包路径五项（live sdkconfig 已在跑的值）：TCP 窗
    5760→23040（默认窗在视频 RTT 70-100ms 下封顶 ~60KB/s，低于 WEB_PREVIEW
    ~140KB/s，网关 send stalled 最长 2s、共享空口积压把控制 WS 顶到 150ms 写
    超时）、recv mbox 16、WiFi 静态 RX 10、RX BA 窗 10、WiFi/lwIP 池入 PSRAM
    （大窗口不吃 ~53KB 内部堆）。
    [ui.c]
2026-10-02 feat(remote): 视频锁定 320×240 + FULLSCREEN ×2 放大，删除 640×480 档位
    手持机不再要 VGA（清晰度留给手机 /stream；订阅仍声明 REMOTE_PREVIEW）。
    侧栏 320/640 双档 radio 换成单个 FULLSCREEN 切换：lv_image_set_scale 2x
    最近邻绕图心放大，铺满 640×480 视频列（条带隐藏、TAB 常驻），同 ~11fps、
    同空口负载，画质略软；1x 恢复窗口态。本地缩放不设链路门控，LINK 态只
    挡 VISION 跳转；VISION 页保持 1:1（叠加层按帧像素坐标映射）。
2026-10-02 fix(remote): CAMERA→VISION 直切后 TAB 栏被页面盖住——tabs_set_visible 每次可见都幂等置顶
    ui_nav_open 置顶新页面后，tabs_set_visible(true) 只在"隐藏→可见"边沿重新
    raise；HOME→CAMERA 必经隐藏边沿所以正常，CAMERA→VISION 直切时 TAB 可见
    标志未变、边沿不触发，不透明页面对象盖住整条 TAB（底部三键全消失）。
    此前 640 档 immersive 每次切页先藏后显、每切必触发置顶，恰好掩盖了这
    个 Z 序缺陷，视频锁定 320 后路径变直才暴露。改为 on 恒置顶 + 已在顶层
    跳过 move（幂等，10Hz 刷新零额外开销）。
    [ui.c]
2026-10-02 docs(gateway): 视觉负载资源政策（doc/22）——空闲的是核 1 和 PSRAM，不是射频
    决策记录，约束 P4/P5/P6 的落位与前置：
    - 扩容顺序证伪"填满 PSRAM"路线：多开流先打爆 2.4G SoftAP（控制面空口被挤，
    10-02 台架已演示完整挤兑链路），再打爆 Remote 解码（VGA ~450ms/帧），
    最后才轮到 PSRAM——空闲算力在核 1，扩容方向是把视觉放核 1、用 PSRAM
    传指针，不是多开消耗空口的流
    - P4 Frame Hub + line/color/QR：核 1 vision_task 读 PSRAM fb 指针（租约），
    不在核 0 httpd 会话里做视觉；结果走文本面
    - P5 Assist 只出高层 omega：经 bridge/SF 现有命令泵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
2026-10-02 perf(camera): /ws/camera 出站零拷贝——fb 直发，删除 obuf 暂存机制
    ws_frame_write 本就把 WS 帧头与负载分开写，pump 却还维护整套暂存：每帧一次
    全帧 memcpy（fb→obuf+20）+ PSRAM 堆增长分配 + 退役释放。fb 在发送期间本就
    握在泵手里（fb_get 与 fb_return 之间），负载直接指 fb->buf，只有 20 B 帧头
    在栈上组——obuf/ocap 字段、WS_FRAME_HEADROOM、增长与释放代码全部删除
    （净 -30 行），每帧省一次 PSRAM 到 PSRAM 拷贝。
    发送端拆为 ws_send_frame_parts（scatter：帧头段 + 负载段），ws_send_frame
    退化为单段薄封装，文本面（hello/state/pong）零改动；撕裂检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
2026-10-03 feat: Implement S3-gateway support and auto power-off functionality
    - Updated scr_cam.h to utilize esp_new_jpeg for improved JPEG decoding.
    - Modified scr_link.c to conditionally compile vision handling based on CONFIG_SCR_S3GW_ENABLE.
    - Enhanced UI components in ui.c, ui_home.c, and ui_pages.c to support S3-gateway features.
    - Added scr_power.c and scr_power.h for auto power-off functionality based on touch inactivity.
    - Updated sdkconfig.defaults to include configuration options for S3-gateway and auto power-off.
2026-10-03 feat(clangd): 五工程 clangd 全量识别——TC275 生成 CDB + HighTec shim 兜底
    - 三个 ESP-IDF 工程沿用 build/compile_commands.json（clangd 自动向上发现，
    含 build/ 子目录，零配置）
    - scripts/gen-tc275-cdb.py（just clangd-db 重跑）：与 site_scons/aurix_tasking
    同源解析 .cproject 的 include/宏/源码排除表，宿主 clang + __HIGHTEC__ 路径
    （iLLD 抽象层里对宿主最兼容的分支）生成 tc275_car/tc275_sbl 的
    build/compile_commands.json，120+83 个源文件；--target=x86_64 让 GNU 风格
    d/a 汇编约束过语法检查，__interrupt/__vector_table 关键字宏空（port.c）
    - scripts/clangd-shim/tc275/：兜底树内缺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
2026-10-03 feat(c6): 控制/标定页视觉重做——亮色主题 + workspace 布局，新增 Playwright UI 回归
    - 控制页（index/app/style）：暗色 #0b0f14 → 米白 #f1f2e9 + 草绿 accent，
    新增页面 heading/eyebrow/速度表盘与仪表+遥测双列 workspace 栅格；
    状态胶囊文案 车→车端、WS→链路；viewport 放开缩放限制
    - 标定页：内联样式回并 style.css（中途抽过 calib.css 又折回），calib.js
    流程增强；A/B/C/D 明确标作驱动通道（motor=0/1/2/3），点动胎纹动画只呈现
    被命令轮位，doc/17 补 2026-10-03 实物核对记录
    - 新增 test/web/：Playwright 回归脚本（control/navigation/calibration），
    mock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
2026-10-03 fix(adc): 电池 VIN 读数小 1000 倍——DIV_NUM 按 x1000 量纲存 11000，换算链抽纯函数加主机单测
    ADC_BATT_DIV_NUM 原存裸 11，(pin_mV*11)/1000 使 g_vinMv 携带整伏数，
    12.6V 电池读成 0.012V、电量恒 0%。改为 11000u；counts→分压点 mV→VIN mV
    抽成 bsp/adc.h 内联纯函数（EMA 仍留在 adc.c 的 pin-mV 域），固件与主机单测
    编译同一份数学；新增 test/host/test_adc.c 回归守卫（13 断言）并接入 CI，
    doc 33 同步自证命令。
    [adc.c, adc.h, test_adc.c]
2026-10-03 fw(dist): tc275_car v1.1.0 归档入库——电池换算修复后的镜像+manifest
    manifest 基线 2631163（dirty 构建，工作树已含本批 ADC 修复）；elf/map 按
    gitignore 留本地，仅 hex + manifest 入库。
2026-10-03 feat(c6): 控制页电压/电量显示防抖——中值+平滑+迟滞锁存，新增 battery-ui 回归
    - 电压显示：5 点中值 + 500ms 时间常数平滑 + 每秒最多 2 次 DOM 更新 +
    20mV 下降迟滞；同一页面内只保持或下降，断线重连不解除保持，刷新后由
    第一笔有效电压重新初始化；零值视为未就绪采样
    - 电量百分比：5 点中值 + 持续 1.5s 下降确认，同样只保持或下降，避免
    1% 边界抖动和单次低值锁存；电压未就绪不初始化电量，有效电压的 0%
    仍是合法值
    - 告警颜色、故障与遥测继续用设备真实数值，显示防抖只作用于展示层；
    index.html 的电量/电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
2026-10-03 fix(build): cctc 临时响应文件指进 build/<variant>/tmp——修中断后在工程根漏 ccXXXXXX 垃圾
    cctc 内部两步法（compile -> ccXXXXa.src -> assemble）的临时文件优先写
    TMPDIR，未设时落 cwd=工程根，进程被中断（Ctrl+C、-j8 全量重编被杀）不
    回收——v6.3r1 实测 kill 三次漏三个。显式指进 build/<variant>/tmp：目录
    先建好（缺目录 cctc F101 拒编），泄漏物随 scons -c 一起清。
    tc275_car / tc275_sbl 同源文件同步修改。
2026-10-03 fw(dist): 固件归档刷新——清空旧档，仅保留 tc275_car v1.1.0（g2cd7e4a+tmp 修复）
    fw.py clean + collect：tc275_car v0.2.2、v1.1.0(g2631163)、tc275_sbl v0.1.0
    移出版本管理；当前 TC275 源码构建的 v1.1.0 hex+manifest 入库（elf/map 留本地）。
2026-10-03 docs(23): 23号接线文档升 V1.18——新增 §10 LSM6DSV16BX 六轴 IMU 接线定稿（QSPI1+INT1/2），00-index 真源表同步
2026-10-03 feat(ios): S3 Remote iOS App 首版——C6 遥控全功能移植 + 座舱 HUD UI
    - proto v2 Swift 移植：CRC16 黄金向量（check==0x29B1）/帧编解码/遥测 38B LE，
    与 C 实现（proto_frames.[ch]）字节级对齐；JSON 文本面按 C6 http_server 实串核对
    - 链路：WS /ws?token、hello/tc/pong/err 解析、1Hz ping RTT、10s 静默看门狗、
    3s 退避重连、配对 REST（403/409/504/503 → 动作提示）
    - 控制：30Hz DRIVE 心跳、ECO/NORMAL/SPORT 限幅、STOP 单击锁存/长按 1.2s 急停
    双锁存、RELEASE 后保持停止、err{auth} 控制权冻结（对齐 scr_ctrl.c）
    - 安全：失联 1.2s 去抖全屏告警、故障码、电池 20/10% 回差；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
2026-10-03 ci(ios): iOS App 纳入 monorepo 门控与发版；just/fw 接入下载指令
    - .github/workflows/ios-remote.yml：push/PR 触及 ios_remote/** 在 macOS runner
    跑全部 Swift 单测（模拟器名动态挑选，镜像漂移不炸）；workflow_call 供发版复用
    - ios-remote-release.yml：push ios/v* tag 先复用 CI 门禁再建 GitHub Release
    （0.x prerelease；不附签名产物——证书绑定开发机，从 tag 自行 just ios-install）
    - justfile：ios-build / ios-install / ios-test / ios-icon / ios-version 配方
    （设备/团队/模拟器为可覆盖变量，ios-version 改 pbxproj MARKETING_VERSION 真源）；
    tag 前缀表加 ios/
    - firmware/README.md：iOS App 专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
2026-10-03 fix(ci): ios 模拟器挑选改 sed——BSD awk 不接受 -F' ('，分组元字符致 illegal primary
2026-10-03 docs(readme): 工程版本勋章表——shields filter 按前缀（c6/gw-s3/r-s3/app/sbl/ios）各自点亮；工程清单补全 s3-gateway 与 ios_remote
2026-10-03 fix(xcore): 根治 LINK cmdq full 洪水自持——v1.1.1 命令队列抗突发四件套
    台架实锤：链路泵任何秒级停摆后 C6 把整段积压（≈96 帧）一次性灌入，8 深
    CPU0 命令队列瞬间打满，每条被拒命令打一行日志，而 CPU0 阻塞排日志环
    （全环 ≈180ms @115200）又拖慢同一循环里的出队——拒绝产生日志、日志拖慢
    出队、出队慢导致更多拒绝。修复四件套：
    - 队列 8→16 深；
    - SET_SPEED（30Hz 摇杆/心跳流）走新 API XCORE_cmdPushLatest 新者胜入队，
    积压塌缩成 1 条；急停/一次性命令仍严格 FIFO（link_forward 分流）；
    - cmdq full 日志限速 1 行/s 携带抑制计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
    [link.c, test_xcore.c, uart.h, xcore.c, xcore.h]
2026-10-03 fix(calib): 标定保存时序收口——替换操作先结清挂起 EVT，新增主机单测入 CI
    - calib_store.c：入队新标定前先以 SAVED_NONE 结清挂起的保存回执（不再给台架
    留一条永远等不到结果的旧请求）；persistInvert 返回 boolean 贯通成败
    - 新增主机单测 test_calib_store（195 行 C 用例 + 43 行 python 驱动，桩替换
    flash/xcore/时钟边界，不编译硬件原语），tc275-car CI 增跑该步
    - 标定 UI 回归（calibration-ui.cjs）与 calib.js 同步，17/34/33 号文档更新
    - .gitignore 忽略 tc275_car/.cache/（clangd 缓存）
    [calib.js, calib_store.c, test_calib_store.c, test_calib_store.py]
2026-10-03 feat(watchdog): add NMI hook for CPU watchdog expiry reaction to prevent system freeze fix(wdg): update watchdog reload value to reflect accurate timeout duration chore(version): bump app version to 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
    [wdg.h]
2026-10-03 feat(ios): 整车拓扑页 + 芯片版本清单——链路节点态实时点亮，零固件改动
    拓扑页把 iPhone → Wi-Fi/WS proto v2 → C6 → SPI/SF 帧 → TC275 的节点链画出来，
    WS/TV 通道、两级 RTT 与 SPI 误码实时点亮；TC275 外设与 s3-gateway 视觉网关
    （v1 未接相机面）分别用外设条和虚线占位标出接入状态。
    芯片版本清单来源全在现有报文上：本 App 读 Bundle、C6 取 hello ver、
    TC275 App/SBL 取 tcver 信标并以遥测 fw_ver 兜底、硬件 rev 取 hw_rev。
    tcver 此前只落事件日志，现收进 AppState 并随断链清零。
    顺带修 App 版本号链路：Info.plist 的 CFBundleShortVersionString/CFBun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
2026-10-03 Add LSM6DSV16BX IMU driver implementation and unit tests
    - Introduced `bsp/imu.h` for the LSM6DSV16BX six-axis IMU driver, including register definitions, configuration defaults, and helper functions for SPI communication.
    - Created documentation `35-imu-driver.md` detailing the design, implementation status, and operational guidelines for the IMU driver.
    - Implemented unit tests in `test_imu.c` to validate conversion functions and register access for the IMU driver, ensuring correctness of the mathematical operations and SPI byte formatting.
    [Cpu0_Main.c, Cpu1_Main.c, imu.c, imu.h, motor_algo.c, test_imu.c, test_xcore.c, xcore.c]
2026-10-03 fix(imu): 失联诊断行 IMUERR st/id/err/clk= + WHO_AM_I 0x71 与小端/ZYX 突发解码修正
    台架首验①未过（报失联）暴露两处事实错误 + 一处可观测性缺口：
    - WHO_AM_I 0x70→0x71：LSM6DSV16BX 数据手册 0Fh=71h（0x70 是别的料号，
    v1.0 因此把健康器件报成 absent）；
    - 突发解码改 ST PID 同款小端 le16，加速计块声明 Z,Y/X（陀螺 X,Y,Z）——
    整段解码收进 IMU_le16/IMU_burst*Raw 纯函数（test_imu 覆盖）；
    - imu_probe 由 boolean 改回 ImuStatus（IMU_ERR_NO_DEV 自此有使用者），
    init/1Hz 重探失败路径按 0.5Hz 打 IMUERR st/id/err/clk=，原始 WHO_AM_I
    字节把无供电/相位错/CS 未到/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
    [imu.c, imu.h]
2026-10-03 refactor(link): 移除旧 UART/AA55 传输路径——SF-over-SPI 成为唯一板间链路
    G1 已过、SPI 链路转正后双路径失去存在意义：删 com/wifi_at.c/.h（-744 行，
    ASCLIN1 AT 固件桥）、protocol.c 砍掉 CPU2 侧字节解析/路由/回传（PROTO 只留
    CPU0 的 handleCommand，帧同步与 CRC 归 SF 层）、Cpu2_Main 摘掉 USE_SPI_LINK
    条件编译、两份 TASKING 配置删除该宏（doc 21 SS5.6 本就判 UART 弃用）。
    验证：全仓无悬空引用；TASKING 全量编译链接绿（120 源文件，v1.1.2）。
2026-10-03 fix(build): mw/crypto 目录定向关 W537——逐字拷贝的上游代码不许为本仓告警而改
    mw/crypto/ 是 esp32c6_car components/c6_ota 的逐字拷贝（doc 24：两侧共用
    真源），c6_consts.h 把 SHA-512 与 ed25519 常量塞同一头文件，ed25519v.c 只
    用后者，ctc 报 W537 unused variable（gcc/clang 默认不报，上游一直没暴露）。
    未用数组是 per-object .rodata，链接期即被丢弃。既不改拷贝源、也不全局关
    告警号——只对该目录追加 -Wc-w537，本工程自有代码的死变量检测照旧。
    另：tc275_sbl/.cproject 随 ADS 保存补 refreshScope 存储模块（IDE 噪声）。
2026-10-03 fix(calib): DPT 结果回传 sint32→int32_t 按元素拷贝，不再跨类型重解释指针
    xcore 邮箱是 iLLD 类型域（sint32 = TriCore 上的 long），C99 纯编解码器取
    stdint 的 int32_t（int）——宽度相同但元素类型不同，指针直接转是未定义
    行为（TriCore 上恰好无声，主机 UBSan 会炸）。calib_sendResultEvt 改按
    元素循环拷贝。
    [calib_store.c]
2026-10-03 Update IMU probe identity and enhance test coverage
    - Changed expected WHO_AM_I value from 0x70 to 0x71 in xcore.h and related tests to reflect the correct sensor identity.
    - Updated the launch configuration for TriCore Debug with a new session ID and adjusted memory map entries for accuracy.
    - Enhanced test_imu.c with additional tests for WHO_AM_I, little-endian handling, burst decoding, and blank detection scenarios.
    - Removed redundant include path entries in .cproject files for cleaner configuration.
    - Adjusted app_version.c to include the correct header file path.
    - Modified aurix_tasking.py to handle unused variable warnings specifically for the mw/crypto/ directory without affecting g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
    [imu.c, imu.h, test_imu.c, test_xcore.c, xcore.h]
2026-10-03 fix: correct INT2 pin reference in IMU driver documentation
    Updated the INT2 pin reference from X1-30 to X1-29 in the IMU driver documentation. This change clarifies the correct pin assignment and addresses a previous error where X1-30 was incorrectly noted, as it is actually the PORST_N reset line. The documentation now accurately reflects the configuration for ERU REQ13.
2026-10-03 Add VL53L5CX ToF driver and documentation
    - Introduced the ToF driver implementation in bsp/tof.c and bsp/tof.h for the VL53L5CX sensor, including I2C communication handling and state management.
    - Added detailed documentation for the ToF driver in doc/30-tc275/36-tof-driver.md, outlining the driver functionality, integration, and troubleshooting steps.
    - Implemented a test suite in test/host/test_tof_bus.py to validate the I2C communication model and ensure proper functioning of the ToF driver under various scenarios, including error handling and timeout conditions.
    [Cpu0_Main.c, test_tof_bus.py, tof.c, tof.h]
2026-10-03 fix(tof-driver): Update documentation for version changes and clarify I2C bus recovery procedures
    feat(test_tof_bus): Enhance test cases for I2C bus handling and GPIO isolation scenarios
    [test_tof_bus.py, tof.c, tof.h]
2026-10-03 fix(tof-driver): Update version details and validation results in documentation
2026-10-03 fix(tof-driver): Update documentation for VL53L5CX driver, including final transaction fixes and successful ranging results
2026-10-03 fix(tof-driver): Update I2C baud rate to 1 MHz for bench trial and adjust documentation accordingly
    [tof.c, tof.h]
2026-10-04 fix(c6-flash): 把 idf.py 构建退出码传回调用方
    之前 PowerShell 子命令的失败码被吞掉，flash.py 在构建失败时仍继续走
    后续流程，只能靠人读日志发现。
    [flash.py]
2026-10-04 feat(fusion): 多传感器融合与遥控驾驶辅助保护落地（App v1.2.0）
    CPU0 robot 任务在心跳/故障处理后插入 FUSION_step：以编码器实测车速为锚、
    用前向 ToF 最近有效区算速度包络；触发保护停车后需松杆并累计 3 个新健康帧
    才解锁，倒车只做限速。IMU 安装轴向尚未标定，本批不参与姿态制动与航向控制。
    - bsp/tof：每帧发布完整 FusionTof 快照（距离/状态/目标数/序号/时间戳），
    读成功但持续 1 s 无新帧时回到 1 Hz 重探
    - mw/xcore：新增 tof/fusion 块与 encoder.seq，跨核快照带发布新鲜度
    - Cpu2：链路 READY 时 5 Hz 发 SF EVT 0x27（版本 1、28 B 显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
2026-10-04 feat(logging): v1.2.1 开发者日志改为字段名+单位并按状态分级节流
    数字串日志（LINKERR=/TOFERR=/SPD=/SRV= 等按位置解读）换成
    [MODULE] field=value 形式，单位与异常含义集中登记在新建的 38 号字典。
    只降日志频率，采样、控制、ToF 总线速率与网络遥测周期均未改动。
    - mw/xcore：新增 XCORE_logFields/XCORE_LOG_FIELDS（XL_U/I/H/S，单次 1..16
    字段）、调用方持有的 XCORE_logDue 速率门（无符号差值容忍时钟回绕）、
    XCORE_logDropped 丢弃计数；格式化在锁外，长记录按字段边界分行并重复标签
    - com/link.c：LINK/LINK_SLAVE/LINK_ERRORS/LINK_TRAFFIC 分组，30 s 周期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
2026-10-04 fix(c6-web): 电池显示新增充电恢复通道，充电后不再锁死低电量
    防抖原为"会话内只降不升"，充电后显示值永久锁死在低电量。新增两条恢复
    通道——① 遥测 uptime 回退（整车重启，即充电断电重开）时电压/电量双平面
    重置并立即重播种；② 车边充边连时，电压平面加 50 mV 上行迟滞，电量中值
    持续 ≥+2 % 达 10 s 步进上调（最终回 100 %）。原有 1.5 s 下降确认、中值
    尖峰吸收、≤2 Hz 显示闸等防抖特性全部保留，与 ios_remote
    BatteryDisplayFilter 同语义；安全告警仍用原始遥测。
    测试：battery-ui.cjs 补充电恢复/重启重置场景；新增 b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
2026-10-04 feat(ios): S3Remote v1.3.0——实时相机、玩法体系、新手引导与充电电量恢复
    新增（车端零改动）：
    - 实时相机视频面：s3-gateway MJPEG :81/stream 接入，驾驶页实时画面卡
    （LIVE/BUSY/ERROR 状态章）+ 全屏页，拓扑页网关节点实时状态，设置独立
    开关与地址；单查看者礼让、503 占用态、4 s 短超时 + 0.8 s→4 s 指数退避
    重连 + 2 s 帧停滞自愈（Camera/CameraClient.swift + UI/CameraView.swift）
    - 玩法 Tab：特技动作库（8 预设关键帧 30 Hz 走摇杆同一条 DRIVE 通道，
    STOP/急停/摇杆/失联/退后台即时中止，Control/StuntSequencer.swift）、
    体感驾驶（CoreMotion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
2026-10-04 feat(c6): 1.1.2 hello 报实时链路状态、移除本地 ADXL345 改用 TC275 IMU
    - hello 帧携带实时 TC275 链路状态，修掉 iOS 被固定 "down" 覆盖的假离线
    - 删除 C6 本地 ADXL345 驱动/Kconfig/文档，IMU 数据统一取 TC275 侧
    - C6 SPI 统计明确字段含义并改为 10 秒周期，WARN 默认构建也能观察链路事件
    - get_request_token 按调用点同条件裁切，台架配置（BENCH_CTRL+OTA_NO_AUTH）下恢复零告警
    - host 侧新增 test_diag.py / test_ws_hello.py，.gitignore 放行 test/host 的 .py
2026-10-04 fix(flash): ESP-IDF 安装发现去版本硬编码，build 目录过期时自动 fullclean
    EIM 把 IDF 从 v6.1-beta1 升到 v6.1 GA 后，两份 flash.py 与 firmware/fw.py 的
    Windows 兜底路径仍硬编码 beta1，而 build/ 记的是旧安装，idf.py 从此拒绝一切
    命令（fw-flash c6 直接失败）。
    - 发现顺序：eim_idf.json 尊重 idfSelectedId 且校验目录在盘上 → 环境变量 →
    按各 OS 的 EIM 目录布局扫盘取版本最高的安装（Windows 覆盖 C:\esp\v*\esp-idf
    与 C:\Espressif\frameworks\esp-idf-v* 两套形状）
    - python/IDF/激活脚本按同一版本配对，混装机器不会凑出跨版本三件套；
    FW_IDF_PROFILE 仍然优先
    - 版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
    [flash.py]
2026-10-04 chore(ide): VSCode IDF 设置指向 Windows 侧 v6.1 安装，cproject 去掉 iLLD/I2c 根 include
    - .vscode/settings.json 与 esp32c6_car/.vscode/settings.json 的 idf.currentSetup
    从 macOS 路径改为 C:\esp\v6.1\esp-idf，串口改 COM8
    - tc275_car/.cproject 移除两条 Libraries/iLLD/.../I2c 的"工程根" include 路径
2026-10-04 feat(tc275): ToF 覆盖稀疏时降级为限速爬行，摘要输出各区域原始测距
    - fusion.h 新增 FUSION_TOF_LIMITED(128) 与 FUSION_SPARSE_MM_S(150)：传感器仍在
    出帧但有效区不足一半时，不再当作完全失明，前进上限压到 150 mm/s 人工低速
    - fusion.c 放行条件、清障计数与阻断判定统一按 (TOF_OK|TOF_LIMITED) 计算，
    nearestMm 为 0（空旷无回波）不再误判成障碍触发 FUSION_OBSTACLE
    - tof.c 在 10 秒摘要节奏打印每个区域的 distance_mm/status_raw/targets，用于
    区分"前方确实空旷"和"光学回波无效"这两种需要不同处置的情形
    - app_version 升至 1.2.3；host 场景测试同步覆盖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
2026-10-04 feat(link): C6 网页与 iOS 呈现"测距覆盖不足"低速放行，补 v1.1.2 实机验证记录
    - assets_src/app.js：flags&128 且未触发前向锁定时显示"测距覆盖不足，低速遥控中"
    并按 cap*0.0036 给出 km/h 上限
    - ios_remote TextMessage：新增 fusion 信标解析（reason/flags/distance/cap 逐字段
    范围校验）与 FusionStatus.warning 分级文案，AppState/LinkEngine/HomeView 接上
    显示链路
    - doc/13-verification.md：记入最终 v1.1.2 的 COM8 烧录与 45 秒双串口摘要
    （up=1、收发增长、CRC/格式/序列错误为 0），并说明主机侧累计计数不能当作
    本次增量
2026-10-04 feat(fusion): 低速降级模式容忍 100 ms 超速瞬态（App v1.2.4）
    实测低速起步有 164–190 mm/s 编码器瞬态，旧的瞬时超速判定会把车反复锁死。
    现在只在"覆盖不足且包络为完整 150 mm/s"这一种降级下容忍 100 ms 超速，
    持续超速仍锁车；近障、数据失效、已知距离导致的包络收缩保持立即制动。
    同批改：
    - test_fusion.c 增短暂波动、回落重计时、单区近障不等 100 ms、计时器跨
    32 位时基回绕四条场景；test_fusion_bridge.py 冻结判读改用 0x80 位。
    - 37 号补 v1.2.4 行为与实机验证记录（COM16 45 s 油门采集），38 号补
    forward=limited_tof_coverage、health_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
2026-10-04 fix(ios): 车头链路断开时清除融合快照
    否则遥控页会继续显示上一次的车速、限速与告警文案，把已失联的车读成"还在低速放行"。
2026-10-04 Add diagnostic transaction engine implementation
    - Introduced `diag_txn.h` and `diag_txn.c` to define and implement the transaction engine for handling diagnostic data.
    - Created `diag_service.c` and `diag_service.h` to manage the initialization, command processing, and tick functions for the diagnostic service.
    - Implemented wire protocol helpers in `diag_wire.h` for transaction schema and data framing.
    - Developed unit tests in `test_diag_txn.c` to validate the functionality of the diagnostic transaction engine, including request handling, admission control, and response validation.
2026-10-04 feat(diag): Enhance diagnostic transactions and IMU integration
    - Updated documentation for version V1.6, detailing new STBY control and IMU integration.
    - Added IMU constants and helpers to diag_service for improved sensor data handling.
    - Refined motor algorithm calibration step to ensure proper state management.
    - Enhanced test coverage for diagnostic transactions, including edge cases for command handling.
    - Introduced new diagnostic transaction documentation outlining current capabilities and implementation boundaries.
    - Added tests for CPU2 dispatch and CPU0 diagnostic service to validate functionality and robustness.
2026-10-04 fix: address encoder health monitoring issue by implementing per-side edge age tracking
    - Introduced `edgeAgeMs[2]` in `XcoreEncoder` to track the time since the last edge for each side, allowing for better health monitoring of the encoders.
    - Updated the `ENCODER_getEdgeAgeMs()` function to populate the edge age data.
    - Modified the `ENCODER_publish()` function to include edge age information in the published snapshot.
    - Adjusted the motor control logic in `motor_algo.c` to use per-side edge age for determining measurement validity, preventing dead sides from masking alive sides.
    - Enhanced the fusion logic to incorporate edge age data, ensuring that only the healthy side contributes to spe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
    [Cpu0_Main.c, Cpu2_Main.c, encoder.c, encoder.h, fusion.c, fusion.h, motor_algo.c]
2026-10-04 更新文档版本和内容以反映最新的功能和修复
    - 在 31-firmware-architecture.md 中更新历史版本记录，新增 V2.9 版本，包含编码器健康按侧判定的现状回写。
    - 在 33-ai-codebase-guide.md 中更新版本至 V1.8，补充编码器健康判定相关内容，并更新日志泵的实现细节。
    - 在 38-developer-logging.md 中更新版本至 V1.2，新增编码器按侧健康判读的字段 `left_edge_age_ms` 和 `right_edge_age_ms`，并更新相关描述。
2026-10-04 fix(fusion): refine motion control logic to prevent erroneous ENCODER_LOST relabeling during protective holds
    [fusion.c, test_fusion.c]
2026-10-05 feat(motor-model): 电机算法 MATLAB/Simulink 建模——控制律与固件逐位等价 + 整定预扫
    新建 matlab_motor_model/，对 TC275 CPU1 的 1 kHz 电机闭环做 MATLAB/Simulink
    建模，代替"上车试参数"。控制律不是照抄的另一份实现，而是与编译出来的固件
    代码逐位比对过：
    - fw/：逐位复刻 servo.c SERVO_update（single 精度，运算顺序与 C 一致）、
    stepToward 斜率限制、encoder.c 测量链（8 ms 窗口均值→mm/s 截断→pct*10、
    alive 窗口）；sim_run_side 与 MOTOR_ALGO_task 拍内时序同构
    - 被控对象：MG310+TB6612 物理模型（电气/机械 ZOH 精确离散 expm、库仑/静
    摩擦显式处理、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
    [golden_servo.csv]
2026-10-05 feat: Update documentation and code for version 1.3.2
    - Updated AI codebase guide to reflect changes in encoder health checks and added fusion protection switch.
    - Revised sensor fusion documentation to include details on the new fusion protection switch and its implications for operation.
    - Enhanced developer logging documentation to incorporate the new protection field in logs.
    - Bumped application version to 1.3.2 in app_version.h.
    - Added regression test for fusion bypass functionality to ensure telemetry remains active while bypassing protections.
    - Introduced a new calibration tool for wheel-speed constants to assist in ensuring accurate measurements and configurations.
2026-10-05 Add console command interface and MATLAB live plotting for TC275
    - Implemented a line-command console in app/console.c to control the TC275 speed loop via UART.
    - Added command handling for "BENCH on", "BENCH off", and "BENCH?" with appropriate responses.
    - Created a test suite in test/host/test_console.c to validate console command functionality.
    - Developed a MATLAB script (live_serial_plot.m) for real-time plotting of speed loop telemetry from the TC275.
    - Introduced unit tests for calibration session logic in S3Remote, covering jog commands, window management, and result validation.
    - Ensured robust handling of invalid inputs and edge cases in both console and MATLAB implementations.
2026-10-08 feat(sensor-stream): implement diagnostic sensor streams for IMU and ToF data
2026-10-08 feat(sensor-stream): improve TOF zone handling and update IMU tick logic
2026-10-08 feat(sensor-stream): C6 桥接转发 IMU/ToF zone 诊断流
    bridge.c DIAG 隧道新增 EVT 0x2A/0x2B 分发（常量镜像自 tc275_car
    app/sensor_stream.h，C6 构建不见该树）：
    - {"t":"tofz","seq","f","m","v","near","z":[25]}：64 区 ToF 图的
    单个分片，C6 无状态逐片转发，手机端按 {seq,f} 重组
    - {"t":"imu","seq","ms","acc","gyro","tp"}：20 Hz 原始六轴采样
    合计 ~9 KB/s，走既有 http_broadcast_ctl 文本面。
2026-10-08 feat(sensors): iOS 新增「传感器」tab —— IMU 三维可视化与 ToF 热力图
    全链路消费 TC275 诊断流（EVT 0x2A/0x2B 经 C6 转 JSON）：
    - TextMessage: 新增 .imu/.tofFragment 解析（畸形整体丢弃）；FusionStatus
    补全 C6 一直广播的 12 字段（此前 roll/pitch/heading 等被丢弃）
    - TofZoneAssembler: 分片重组纯逻辑（乱序/重复/seq 跳变安全，
    mm/16 反量化，0xFF=不可信区）
    - AppState: imuHistory(200)/accelTrail(120)/peakHorizontalG/tofMap 等显示
    缓冲，暂停开关与断连清理；显示专用，不回灌控制
    - SensorsView 四卡片：ToF 8×8 热力图+场景徽章+近距走势；「IMU 三维姿态」
    （3D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
2026-10-08 chore: 新增根级 AGENTS.md（monorepo 布局/命令/铁律/各端注意事项）
2026-10-08 feat(imu-cal): IMU 轴向标定全链路（0x75 命令族）+ 传感器页迭代
    跨工程原子提交（contracts 铁律）：IMU 传感器轴到车体系的标定通道贯通，
    iOS 传感器页在未标定时显示原始姿态预览并明确标注来源。
    - contracts/link proto_frames.h + 三端副本: DPT 0x75 从未实现转为
    IMU_CAL_SET {axis i8x3, trackMm u16LE}，回执走 EVT 0x23
    - TC275: CalibRecord v2（28 B DFlash blob，imuAxis/trackMm 入 CRC），
    EVT 0x23 15→21 B（追加 axes/track/saved）；axisOk 校验
    （唯一性/行列式 +1）；protocol 处理 0x75；Cpu0 fusion 标定接入
    - C6 bridge: rec JSON 追加 imuAxis/trackMm/imuSaved（n≥21 才发，
    兼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
2026-10-08 refactor(imu-cal): IMU 标定命令 0x75→0x7A，0x75 恢复保留语义
    跨工程原子变更（契约 + 三端副本 + 测试 + 文档同批）：
    - 0x7A 承接 IMU_CAL_SET {axis i8x3, trackMm u16LE}（回执 EVT 0x23）；
    0x75 恢复历史 CAL_SAVE 保留位（TC275 default 忽略），
    0x76..0x79 保留，避免占用历史编号
    - c6_link: DPT 转发范围上限 ENTER..IMU_CAL_SET(0x7A)
    - 同步三端 proto_frames.h 副本、TC275 calib 注释、iOS Proto.swift
    枚举与两端 test_sf 用例；文档 34-calib-dpt / 37-sensor-fusion /
    17-calib-ui / transaction-v1 / 两端 README 同批更新
    验证: just contracts 全过；TC275 test_sf 2965 项 + sensor_stream
    133 项全过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
2026-10-08 feat(sensors): 3D 姿态仪升级 SceneKit 真三维，rec v2 轴映射接入姿态预览
    - Car3DView 重写: Canvas 2D 斜投影 → SceneKit（UIViewRepresentable
    包 SCNView）：车身网格 + 环境光/平行光，updateUIView 用 simd 四元数
    按 heading/pitch/roll 更新车体节点，仍是系统框架零第三方依赖
    - SensorsView 适配新视图
    - applyCalibRecord 现在把车端 rec v2 的 imuAxis 写入显示标定
    （settings.imuDisplayCalibration），applyImu 的姿态预览按轴映射
    变换到车体系——新测试锁定：imuAxis=[-2,1,3] 时传感器系 500/866mg
    重力呈现为车体抬头 >20°，线上数据保持原始值
    验证: iOS SensorStream/Link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
2026-10-08 feat(calibration): enhance IMU calibration status handling and add wheel calibration tracking
2026-10-08 feat(calibration): extend IMU calibration data structure with wheel calibration status
2026-10-08 feat(calibration): update behavior matrix for wheel calibration status in SERVO operations
2026-10-08 fix(calibration): expose wheel status safely across bridge and iOS
    [bridge.c]
2026-10-08 fix(ios): dismiss keyboard after wheel track entry
2026-10-09 feat(ios): degrade radio-lost to non-blocking banner for offline usability
    连接已中断 no longer locks the UI: the full-screen overlay becomes a
    top banner (tap jumps to the link tab, auto-clears on recovery), and
    the joystick stays draggable offline. Drive/send gates, handleDown
    reset and emergency/fault/battery overlays are unchanged — zero wire
    behavior difference. New OfflineUsabilityTests pin the contract.
2026-10-09 fix(ci): repair stale tests and SoundEngine isolation so CI runs green
    - tc275 test_fusion_bridge.py: cut the bridge_emit_fusion extraction at
    the next top-level static fn — the old pump_link_frame boundary
    swallowed the tofz/imu emitters added since, tripping -Werror
    (unused functions, implicit proto_get_u32)
    - iOS STOP/ESTOP sync the outV/outW display with the frame actually
    sent (display lagged one 33 ms beat; SystemTests pins immediacy)
    - SystemTests: single-frame battery drop is debounced by design
    (5-point median + 1.5 s sustained confirm) — seed 50 % on the first
    frame and pin the debounce; post-emergency takeover must re-apply
    joystick axes since emergency() zeroes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
    [test_fusion_bridge.py]
2026-10-09 feat(ios): remove drive-page STOP button
    删除驾驶页底部「停止车辆」按钮（含长按 1.2 s 急停入口）：停车依靠
    松开摇杆回中（30 Hz 零速心跳）与 TC275 看门狗兜底。标定页独立 STOP
    保留；底层 STOP/急停状态机与告警逻辑保留（测试仍覆盖）。关联文案
    同批更新（特技中止提示、设置页停车方式、README/CHANGELOG）。
2026-10-09 feat(ios): match status-deck battery/signal colors to logo gauge rings
    驾驶页顶部状态条的电池与 RTT/信号读数改用与 Logo 双圆环相同的档位
    配色（电量 >20% 绿 / ≤20% 黄 / ≤10% 红；信号 ≥3 格橙 / 2 黄 / 1 红 /
    无灰）。档位逻辑抽为共享 TierColor，圆环与状态条共用一份，无读数
    置灰。
